beagleboard/pocketbeagle-2/README.md

# PocketBeagle 2

PocketBeagle 2 is based on [Texas Instrments AM6254 SoC](https://www.ti.com/product/AM625), it's quad A53 cores can 
provides better performance than the original PocketBeagle. The new design comes with pre-soldered headers, 
3-pin JST-SH 1.00mm uart debug port, USB-C port, MSPM0L1105, 512MB RAM, LiPo Battery charger, and optional eMMC storage.

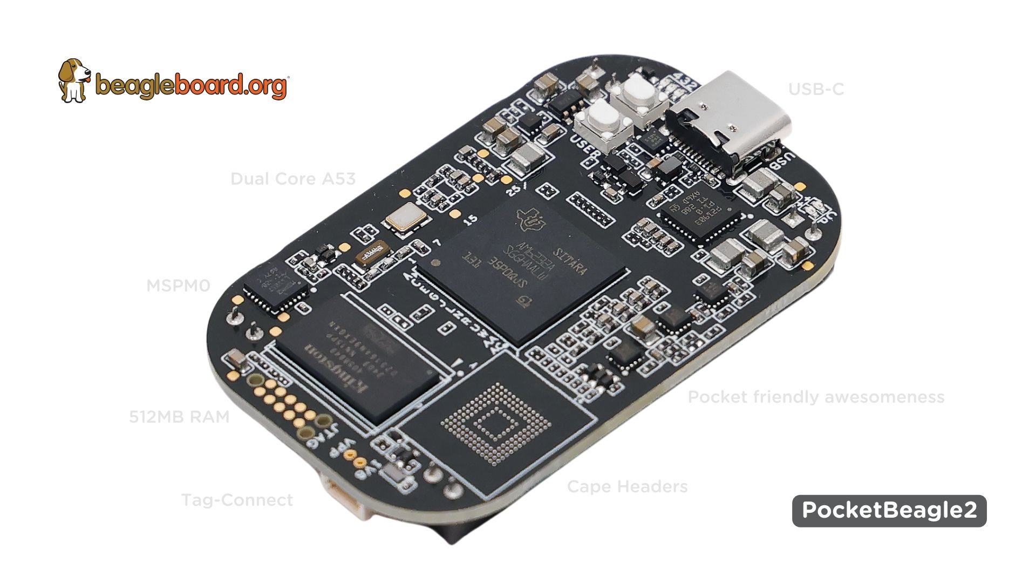
[picture p1: images/hero.jpg]


## Component location - Rev A

| Front |  Back |
| :---: | :---: |
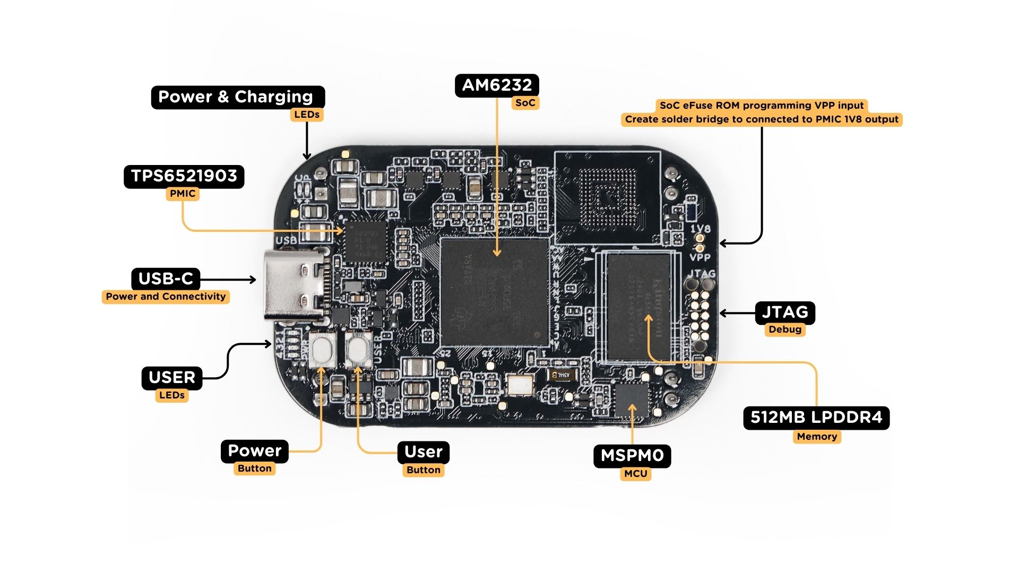
[picture p2: images/front.jpg]
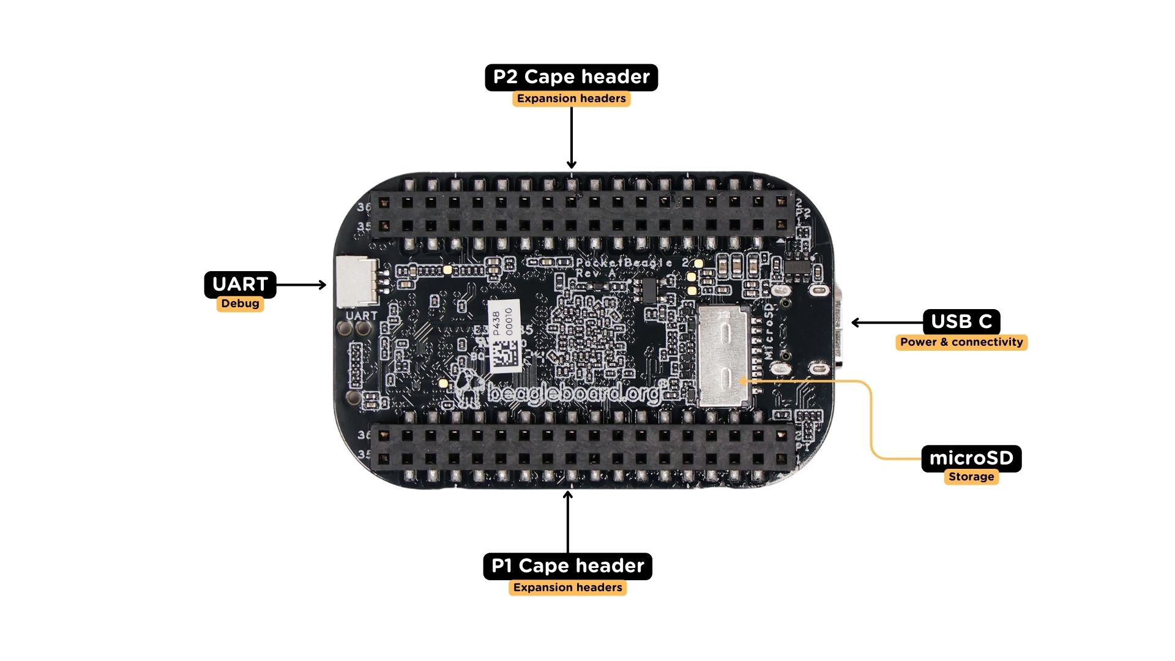
[picture p3: images/back.jpg]
|  |  | 

## Comparison table

| Feature | PocketBeagle 2 | PocketBeagle (original) |
| :---: | :---: | :---: |
| SoC | AM6254 | AM3358 |
| Arm CPU | Cortex-A53 (64-bit) | Cortex-A8 (32-bit) |
| Arm cores | 4 x 1.4 GHz | 1 x 1GHz |
| RAM | 512MB DDR4 | 512MB DDR3 |

## PocketBeagle 2 Features and Specification

| | Feature |
| :---: | :---: |
| **Processor** | [Texas Instrments AM6254 SoC](https://www.ti.com/product/AM625) |
| **SDRAM Memory** | 512MB DDR4 (Kingston D2516AN9EXGXN-TU) |
| **PMIC** | TPS6521903 |
| **Debug Support** | 3 pin 3.3V JST-SH 1.00mm UART debug port (RPI debug probe compatible) |
| | 10-pin JTAG TAG-CONNECT footprint |
| **Power Source** | USB C or Cape Header VIN (5V @ 1A) |
| **PCB** | 55 x 35 mm |
| **Indicators** | 1x Power, 1x Battery charging, and 4x User Controllable LEDs |
| **SD/MMC Connector** | microSD (1.8/3.3V) |
| **User Input** | 1. Power Button |
| | 2. User/Boot Button |
| **Weight** | 12.7gm |
