beagleboard/pocketbeagle-2/images/pocketbeagle2-45-back.jpg

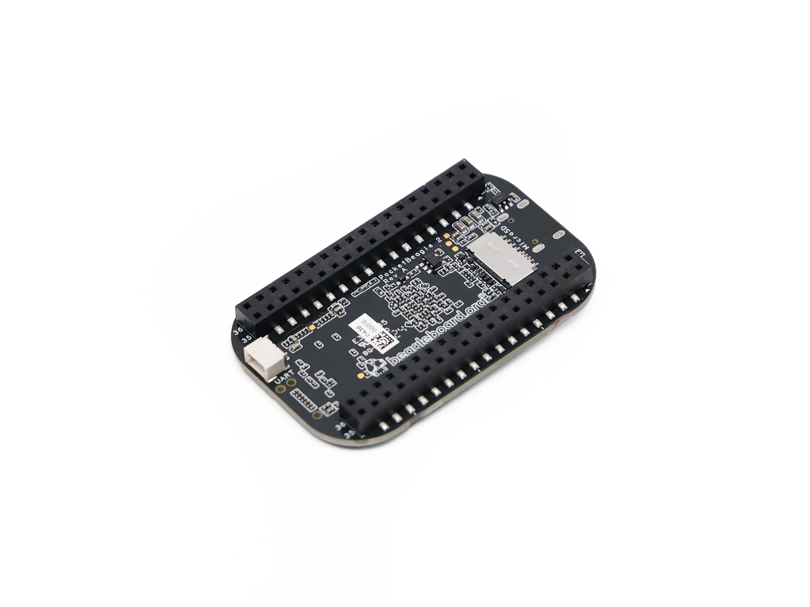
images/pocketbeagle2-45-back.jpg
