beagleboard/pocketbeagle-2/images/pocketbeagle2-45-front.jpg

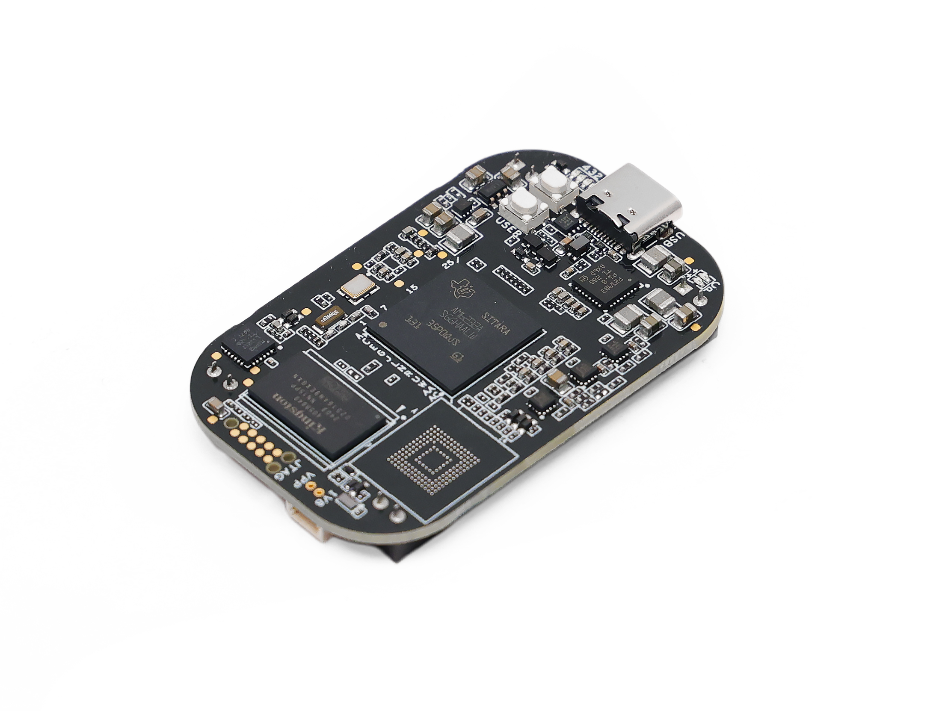
images/pocketbeagle2-45-front.jpg
