beagleboard/pocketbeagle-2/images/pocketbeagle2-back.jpg

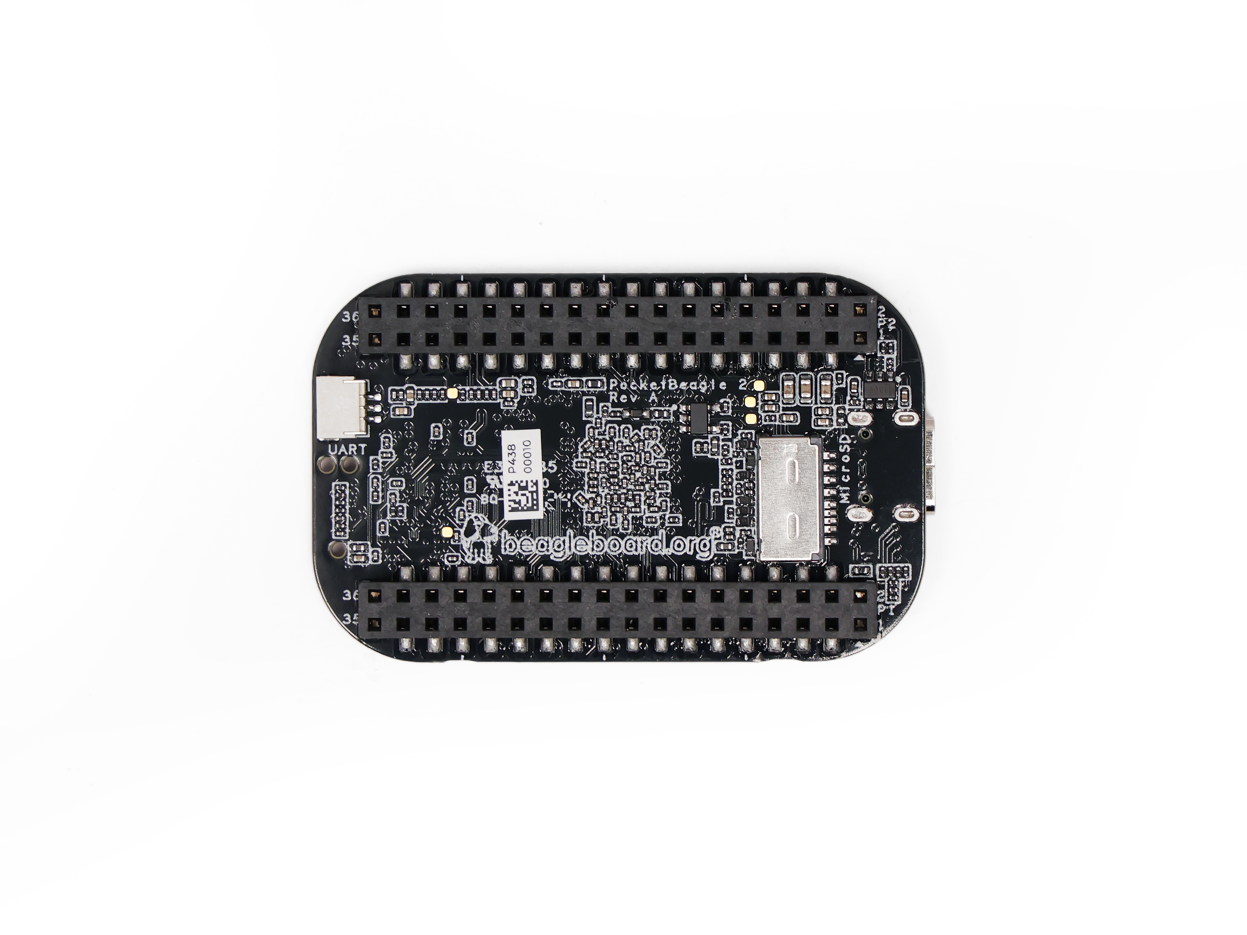
images/pocketbeagle2-back.jpg
