beagleboard/pocketbeagle-2/images/pocketbeagle2-front.jpg

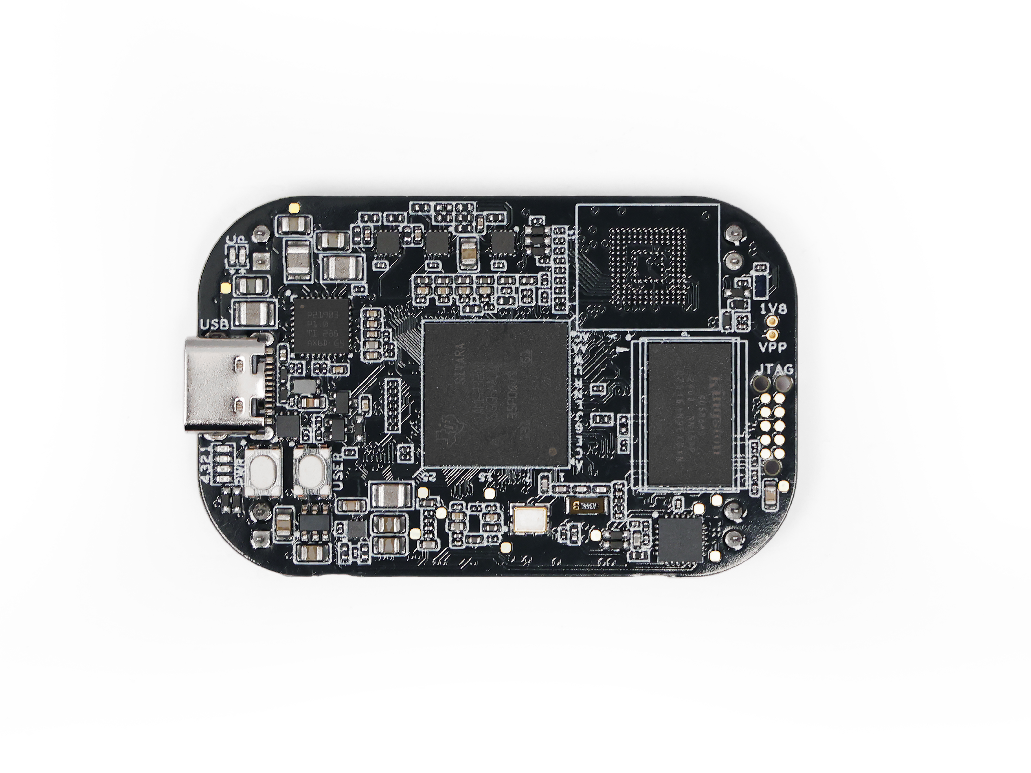
images/pocketbeagle2-front.jpg
