beagleboard/pocketbeagle-2/test-reports/evt/procedure/sd-card.md

Connecting SD Card
==================

Pre-requisites
--------------
* [micor-sd](https://www.amazon.com/SanDisk-Ultra-UHS-I-Memory-Adapter/dp/B00M55C0NS/)

Connecting the SDCard
---------------------

> :warning: Be careful NOT to break SDcard with pressure from top due to the spacing

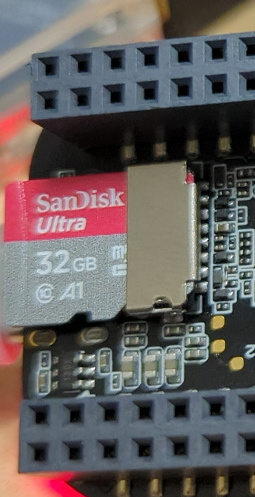
[picture p8: test-reports/evt/procedure/img/pb2_sd_card.jpg]
SDCard

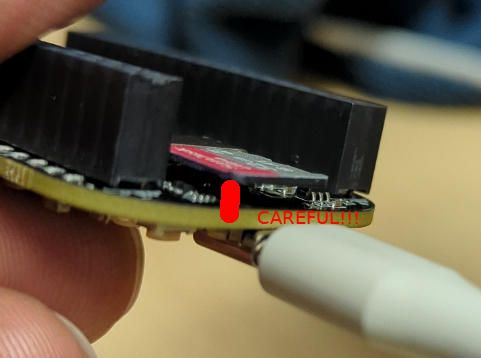
[picture p9: test-reports/evt/procedure/img/pb2_sd_card-2.jpg]
SDcard spacing SDCARD spacing

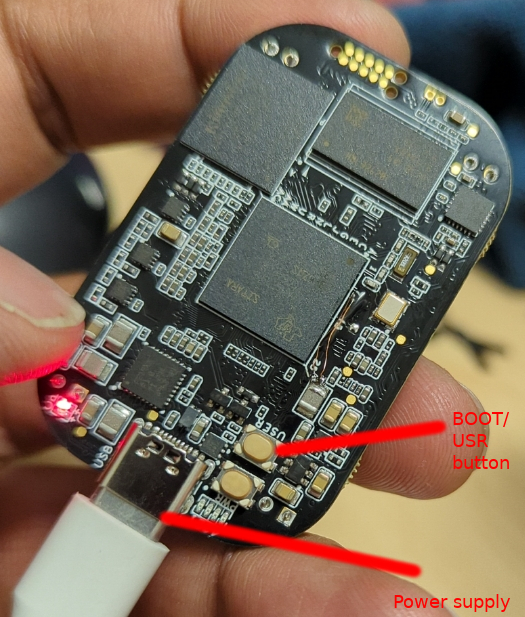
[picture p10: test-reports/evt/procedure/img/pb2_sd-push-button-power.jpg]
USR Button/Power SDCARD USRButton


Booting with SDCard
-------------------
* Flash a bootable SDCard image on uSD card
* With the user button pressed, plug-in power supply over type C
* Once the serial messages startup, let go of the USR button
