beagleboard/pocketbeagle-2/test-reports/evt/procedure/serial_console.md

Serial Console Connectivity
===========================

Pre-requisites
--------------
* [CP2102 USB2Serial adapter](https://www.amazon.com/gp/product/B078W5L8W1/)
* [Male to Female Jumper cable](https://www.amazon.com/EDGELEC-Breadboard-Optional-Assorted-Multicolored/dp/B07GD2BWPY/)

Connecting the serial cable
---------------------------

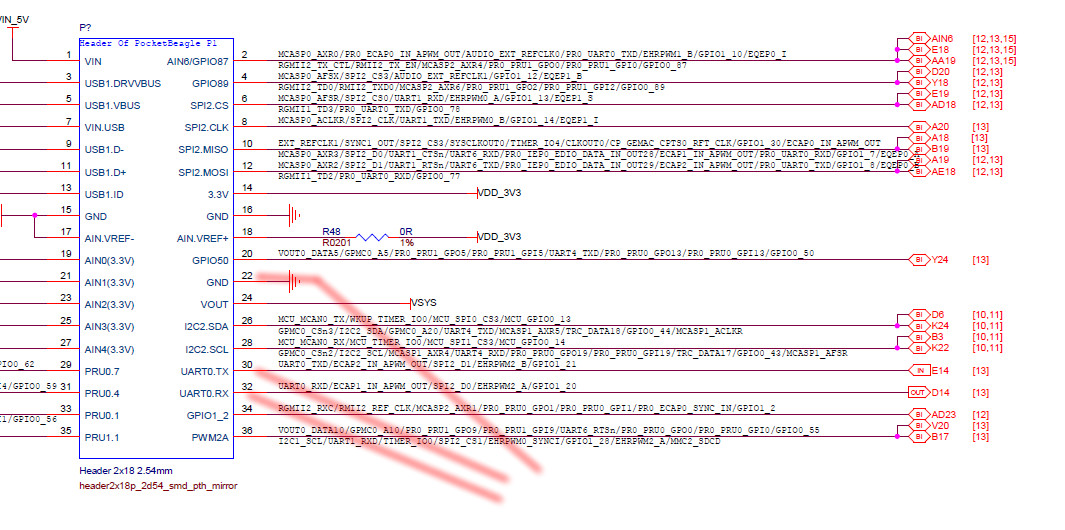
[picture p11: test-reports/evt/procedure/img/pb2_serial_console_shm.jpg]
Console pins schematics Serial Cable Schematics

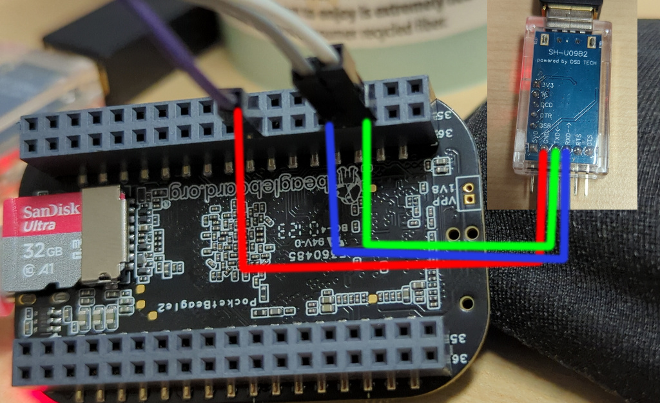
[picture p12: test-reports/evt/procedure/img/pb2_serial_console.jpg]
Connecting serial cable Connecting Serial Cable
