beagleboard/pocketbeagle-2/test-reports/evt/EVT1_PB2_rev0.5_Test_Results.xls

Sheet: Export Summary
This document was exported from Numbers. Each table was converted to an Excel worksheet. All other objects on each Numbers sheet were placed on separate worksheets. Please be aware that formula calculations may differ in Excel.
Numbers Sheet Name | Numbers Table Name | Excel Worksheet Name
Sheet1
 | Table 1 | Sheet1
Sheet2
 | Table 1 | Sheet2

Sheet: Sheet1
Sl.No | Function | Connector | Test case description | Test result (TI) | Comments (TI) | Board work | Seeed Test Result | Seeed comments | Fail track | Priority | Remarks
1 | AM62 JTAG | J19 | Attempt to connect with jtag (openocd)
2 | Uart Console | J6 | prints on console works (Linux console)
3 | Boot (Sdboot) | J1 | Boot works in FS Boot mode
4 | Board ID (eeprom) | U20 | Read and write |  | Dependent on MSP M0 Firmware
5 | LED USR0 | LED3 | enable/disable LED
6 | LED USR1 | LED4 | enable/disable LED
7 | LED USR2 | LED5 | enable/disable LED
8 | LED USR3 | LED6 | enable/disable LED
9 | Power LED | LED11 | Should glow on power ON
10 | Switch on board |  | Board must start up on applying power on Type C
11 | Button (USR) – boot mode select |  | Press USR button and boot into alternate boot – ???
12 | Button (USR) – user detect |  | Press usr button in userspace – event detect
13 | Button (PWR) – power on after power off |  | S/w power off, then press power on button to start
14 | Button (PWR) – short press power on button |  | Short press PWR button and power menu should start up (if GUI is active)
15 | Button (PWR) – Long press power off |  | On Pressing PWR button for long (8-12sec), system should power off
16 | Button (PWR) – Long press power off, PWR ON |  | after h/w power off, pressing power button should start system back up
17 | USB – Host | P1 | Operate USB as mass storage / HID devices |  | Requires External USB
18 | USB – peripheral | P1 | Power board from PC, operate as USB peripheral mode
19 | MSP M0 (RTC) |  | Detect,operate RTC |  | Dependent on MSP M0 Firmware
20 | MSP M0 (ADC) |  | Detect, get ADC readings |  | Dependent on MSP M0 Firmware
21 | Crystal operation: SoC – 25MHz | X6 | Run linux, measure time taken for sleep |  | test_25_mhz_time.md
22 | Stress operation – build for long hours |  | Do on target build for over the weekend – build linux kernel in a loop over weekend
23 | Stress operation – power on-off test |  | Power on/off board using s/w and power cycle over weekend.
 | Rest to be filled by Seeed
