beagleboard/pocketbeagle-2/test-reports/evt/procedure/README.md

Test procedure for Pocket beagle 2
==================================

* [Serial Console](serial_console.md)
* [SD Card](sd-card.md)
