beagleboard/pocketbeagle-2/design/pocketbeagle2 revA_dimension.pdf

55MM

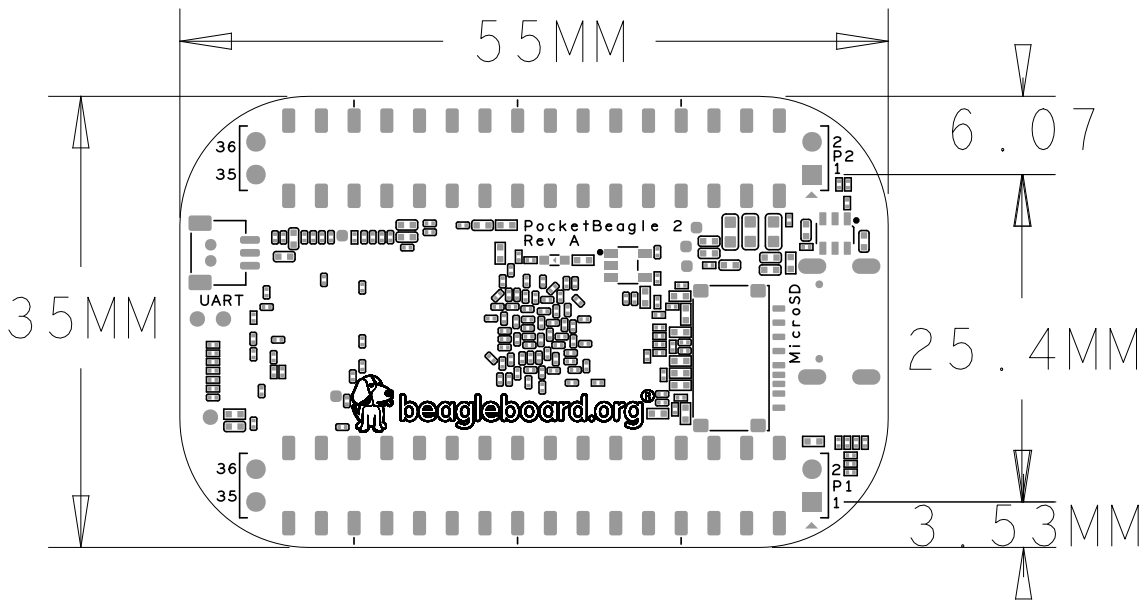
[picture p13: page 1]
UART; PocketBeagle 2 Rev A; MicroSD
