beagleboard/pocketbeagle-2/pocketbeagle2_sch.pdf

D | D
C | C
B | B
A | A
VER # | DATE | DESCRIPTION OF CHANGES | AUTHOR
0.1 | | First release | qxn
| | | qxn

## 28 Oct. 2022

## PAGE

001 | Revision History PAGE NAME
PAGE LIST | REVISION HISTORY
002 | 002_Block Diagram
003 | 003_Power Tree
004 | 004_I2C Usage Diagram
005 | 005_PMIC & Charger
006 | 006_SoC Power
007 | 007_SoC DCAPs
008 | 008_SoC DDR & DDR4
009 | 009_SoC MMC & eMMC & SD

010

011

012

014

013

016

015

## qxn

## qxn 010_SoC WKUP/MCU/System

## 011_SoC Bootstrap

## 012_SoC RGMII/OSPI

## 013_SoC GPIO/MCASP/VOUT

## 014_SoC USB/OLDI/CSI & USB C

## 015_SoC JTAG & MISC

## 016_BP P1 & P2

0.2 | 1. Remove unused nets

## 2. Use WKUP_I2C0 for PMIC 3. Add pull-down to VPP 4. Move eEMMC_RSTn to GPIO0_7 5. Add USER button for boot mode seletion 6. Try to add a CSI connector 7. Using processor boall numbers for signal name on P1 and P2 8. Change SoC to AM6232, change eMMC to 4GB, change DDR to 512MB

## 1 Nov. 2022

0.3 | 1. Remove CSI

## 2. Add SD card, move LDO0 to VDD_SD 3. Power the VPP with VDD_1V8 through a jumper 4. Connect P2.19 to AC20 instead

## 2 Nov. 2022

0.4 | 1. Replace the ideal diode with LM73100RPWR

## 2. Replace EEPROM and ADC with MSPM0 3. Correct the boot settings

4. Connect AD24(MDC) to P2.17 and AB22(MDIO) to P2.20 which is same as pocketbealge.

## 23 Dec.2022

0.5 | qxn
1. Add B5 (MCU_UART0_RXD) to P2_5.
2. Add A5 (MCU_UART0_TXD) to P2_7.
3. Add A18 (EXT_REFCLK1) to P1_10.
4. Add AD24 (MDIO0_MDC) to P2_1. 5. Add AB22 (MDIO0_MDIO) to P2_3.

## 28 Dec.2022

1. Add a buffer on reset 2. Correct typo - WKUP_I2C0_SDL 3. Add decoupling capacitors for LM73100 4. Change R44 to 100k 0.1% 5. Add pulldown resistors on RESETSTATz and PORZ_OUT 6. Correct the ideal diode control logic 7. Change C17 to 10uF 8. Change the SD card holder to lower profile with insertion detection 9. Move C11 to be in parallel with R260 10. Add pullup resistors to WKUP_I2C0 11. Add voltage divider on USB1_VBUS
0.6 | 09 Oct.2023 | qxn
1. Add 3-pin JST connector for UART debug 0.7 | 05 Mar.2024 | 2. Add buffer to debug UART | qxn
0.8 | qxn
1. Fix typo of ‘debug' in schematic 21 Nov.2024 | 2. Correct ideal diode control logic.
1. Modify the boot order of non-emmc version, add a pull-down resistor on non-emmc version to force 0.9 | 3 Dec.2024 | SD boot as primary boot | qxn
1.0 | 20 Dec.2024 | 1. Change USB_5V to charger input to prevent battery voltage flowing back to the charger input through the ideal diode, causing charger indicator light problems

## 2. Change the main MPU to AM6232ASGGHAALW which has PRU 3. Change ADC MCU to MSPM0L1105

## qxn

Title:

Size: | Document Number: | Rev:
Draw By: | Date: | Sheet: | of

# https://www.seeedstudio.com

A3 | v1.0
qxn | Friday, December 20, 2024 | 1 | 16

## PocketBeagle2

001_Revision History

SD Only

# https://www.seeedstudio.com

qxn | Friday, December 20, 2024 | 1 | 16
| 001_Revision History

SD Only

# https://www.seeedstudio.com

qxn | Friday, December 20, 2024 | 1 | 16
| 001_Revision History

SD Only

# Block Diagram

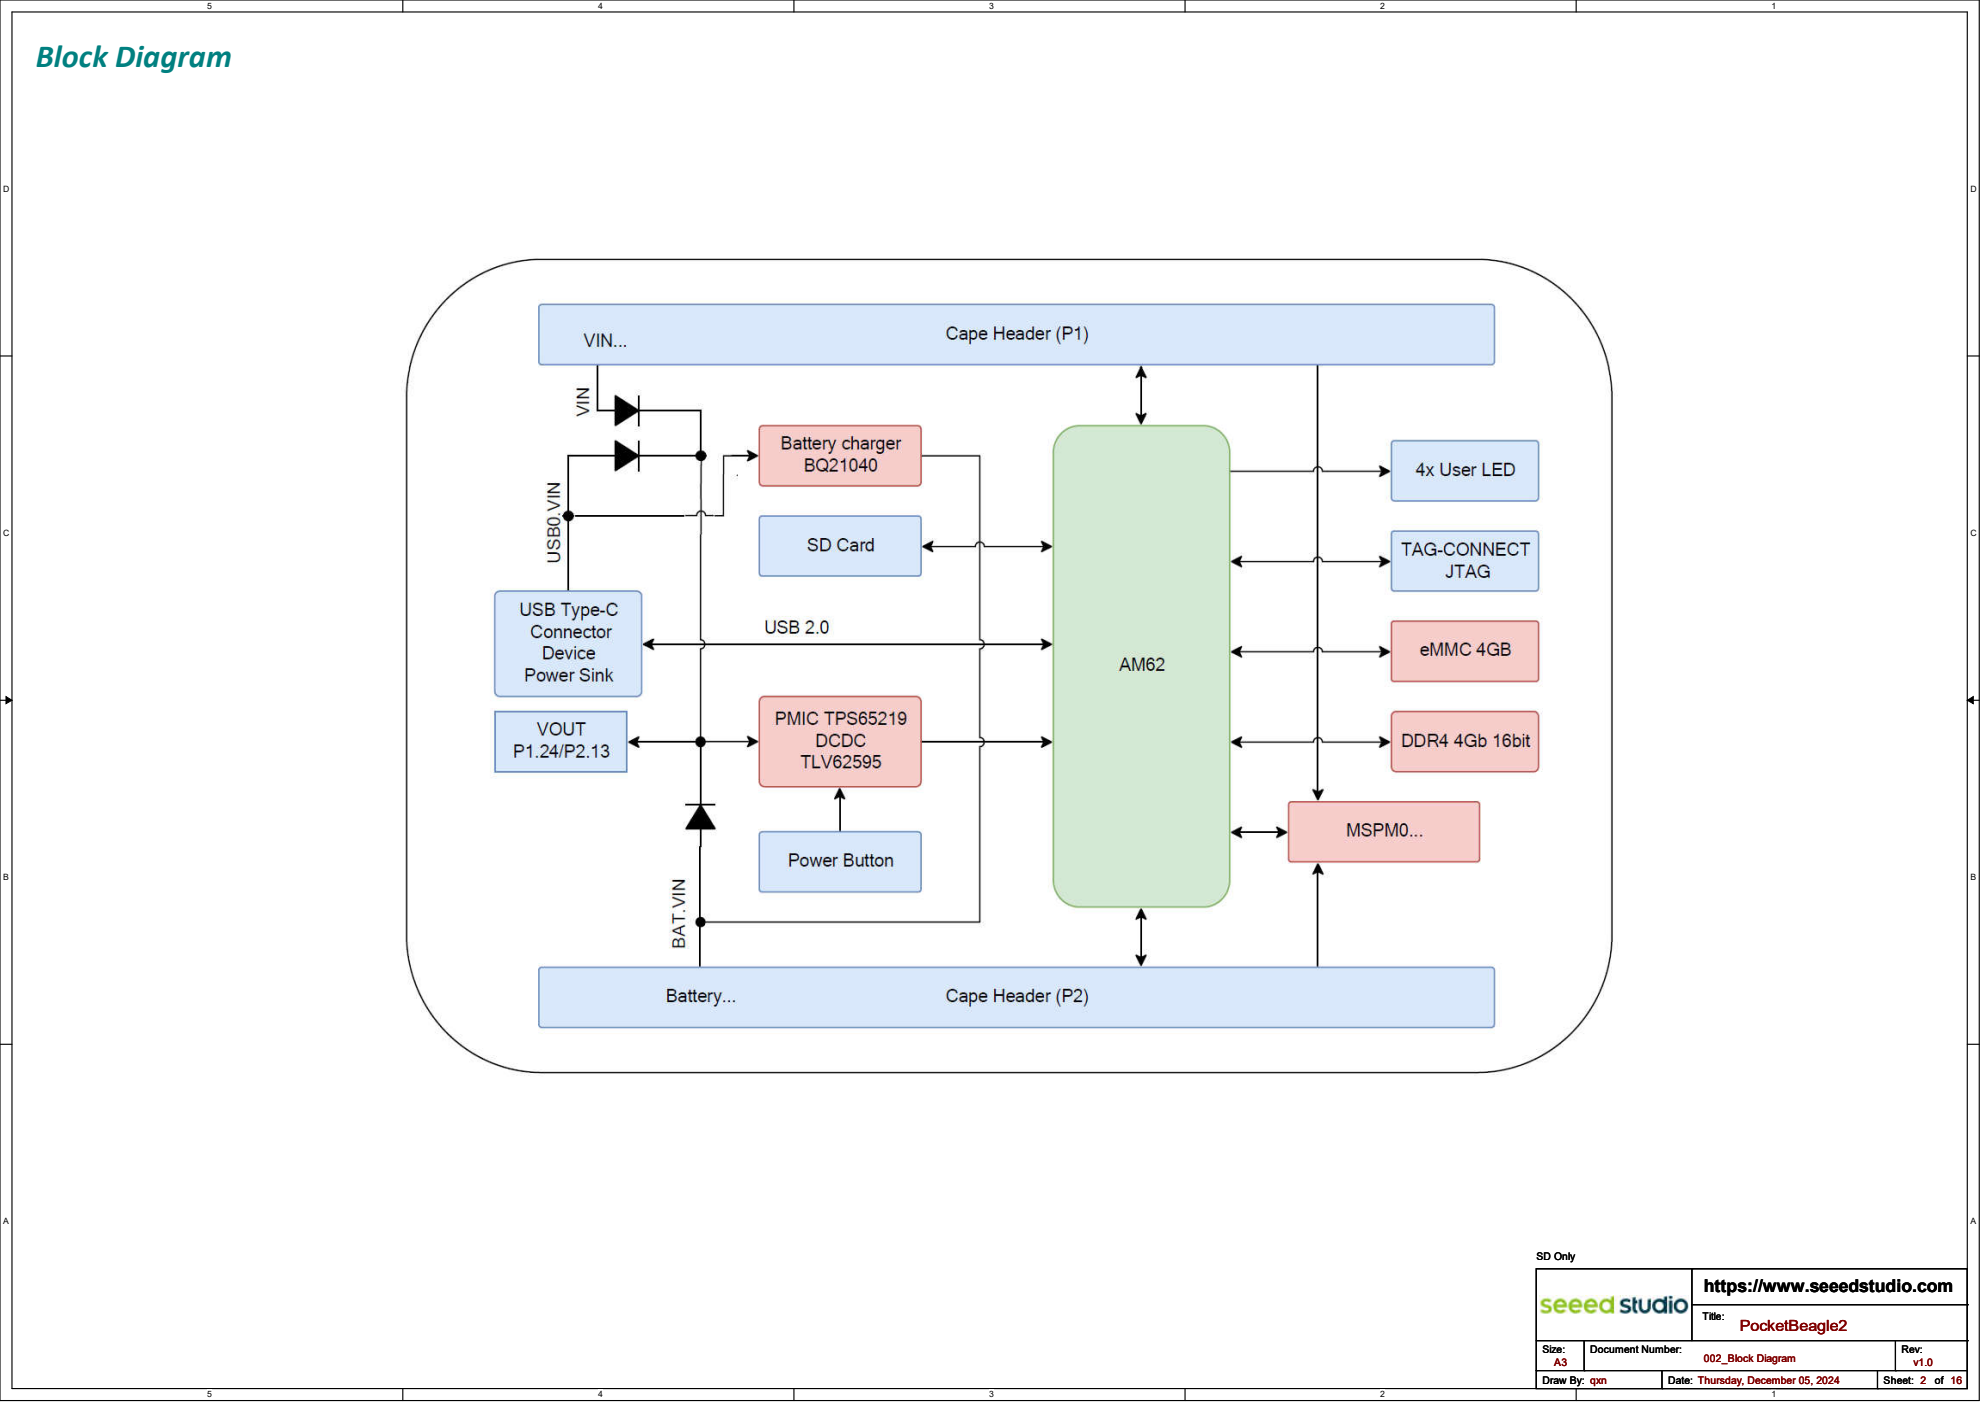
[picture p14: page 2]
qxn; Thursday, December 05, 2024; 002_Block Diagram; SD Only

https://www.seeedstudio.com

# Power tree

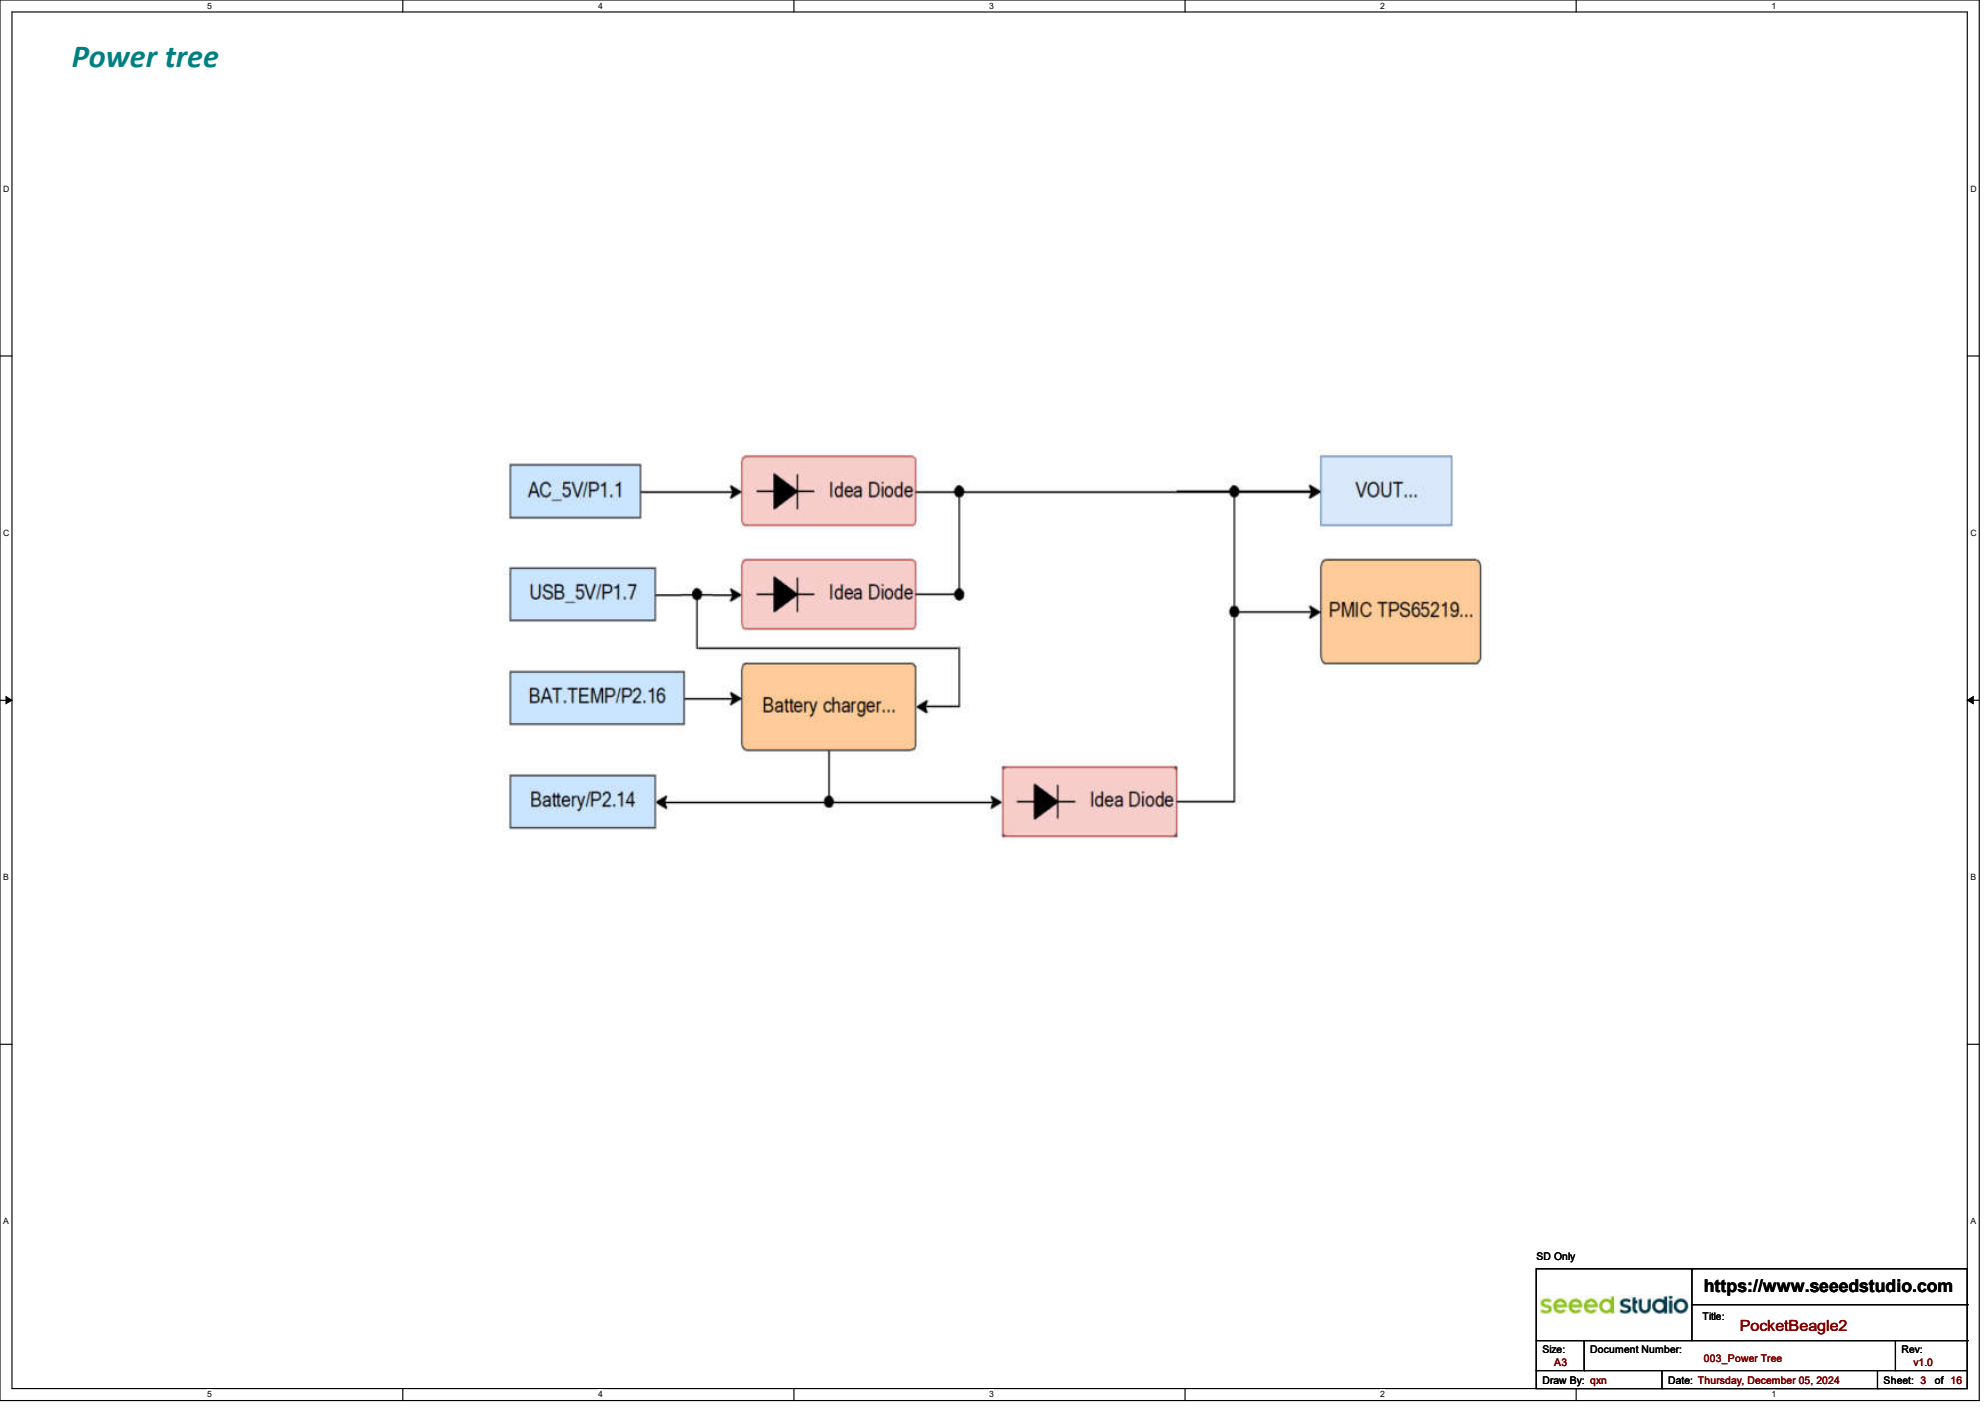
[picture p15: page 3]
qxn; Thursday, December 05, 2024; 003_Power Tree; SD Only

https://www.seeedstudio.com

# I2C Usage Diagram

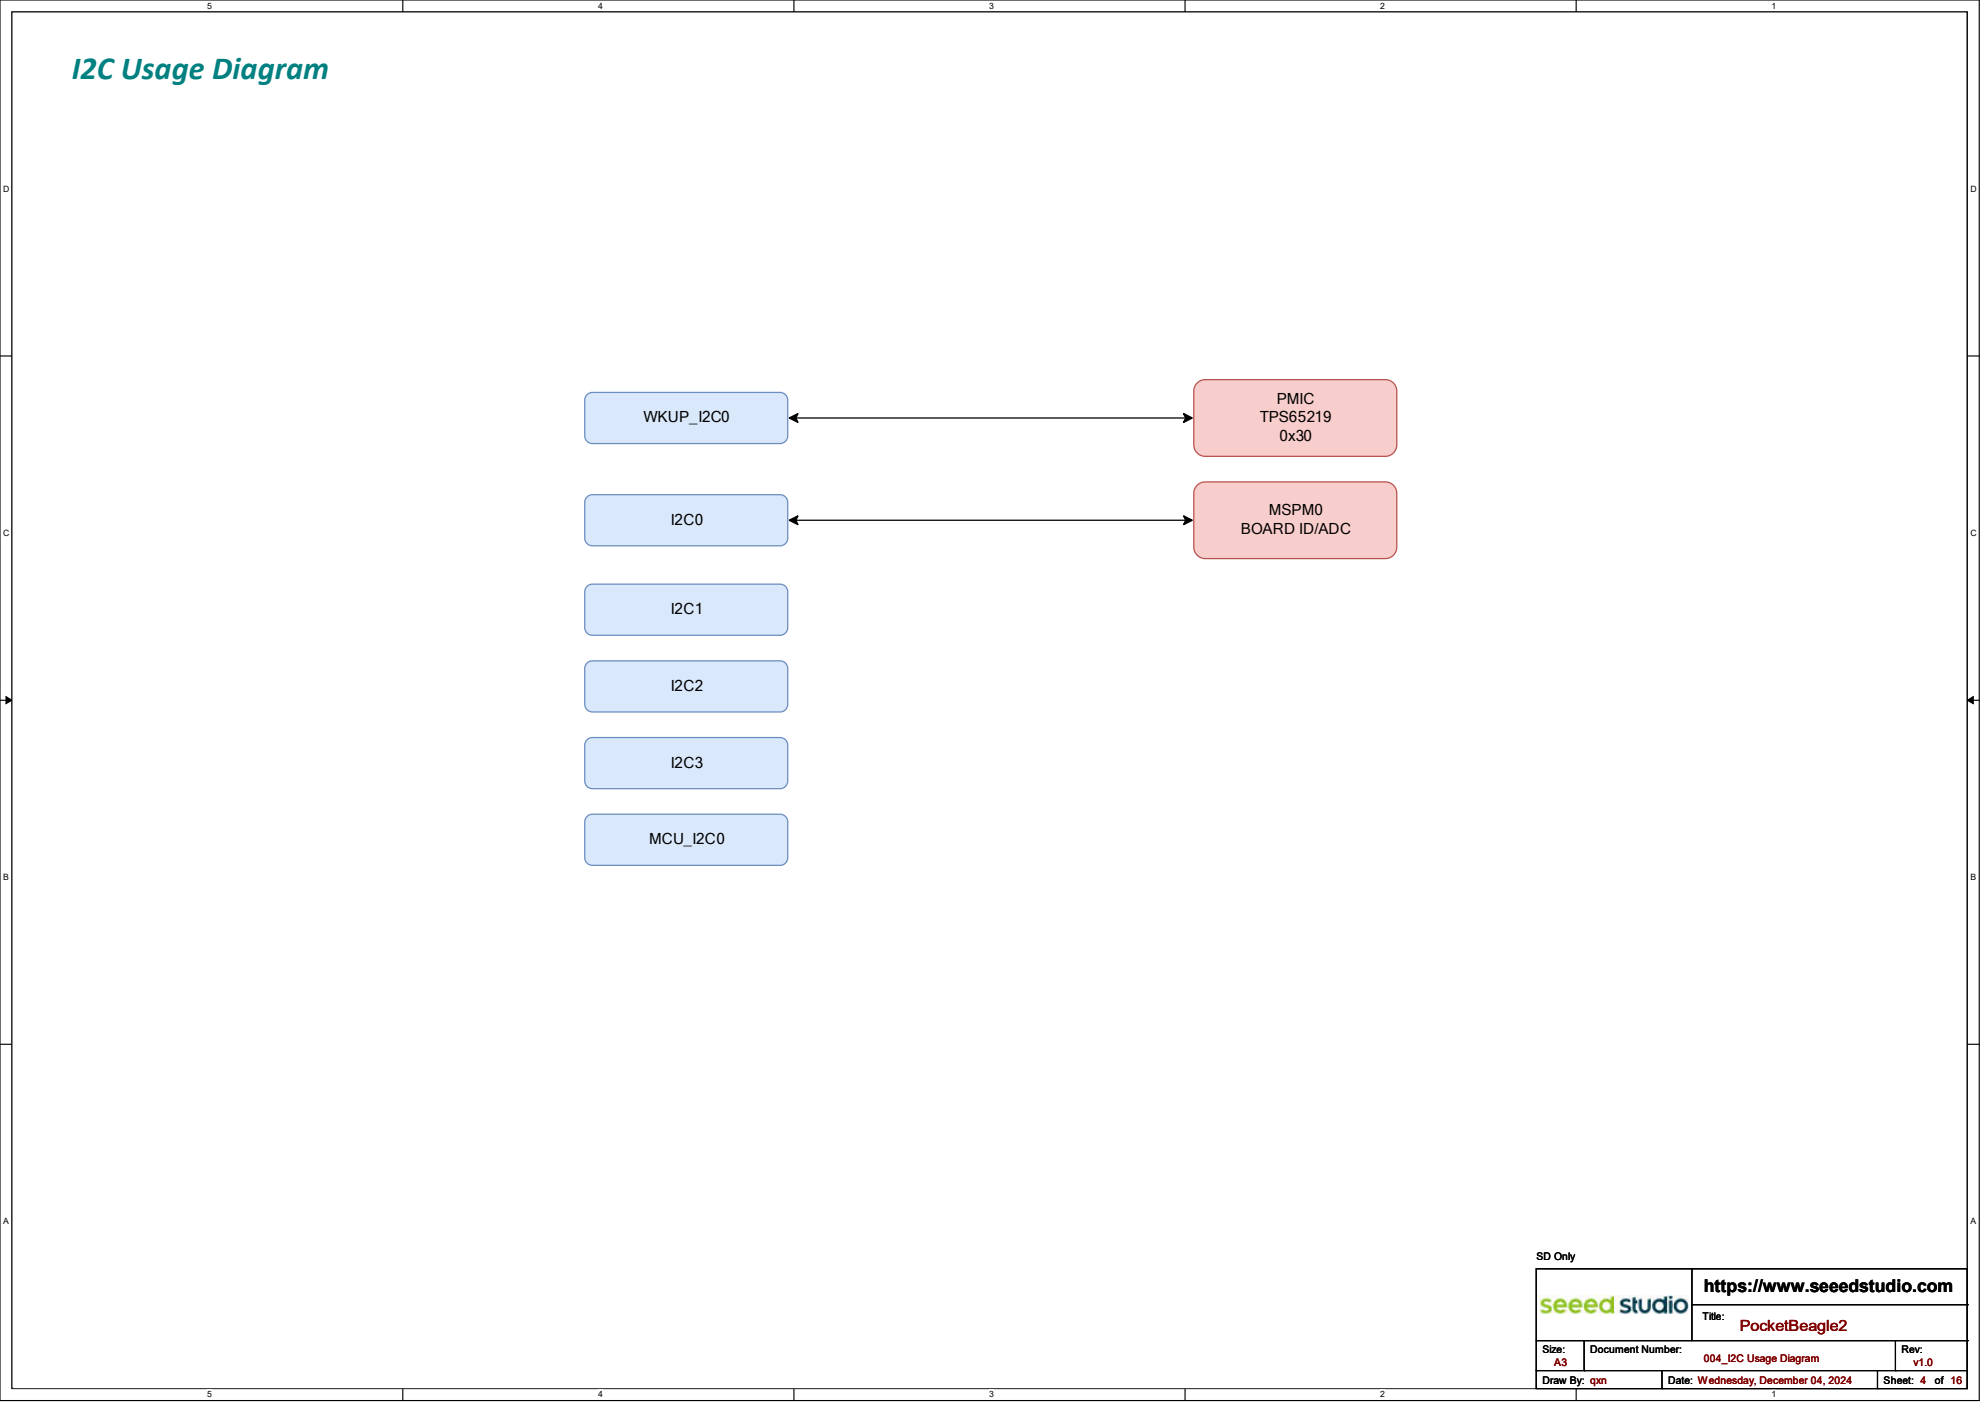
[picture p16: page 4]
PMIC TPS65219 0x30; MSPM0; MCU_I2C0; WKUP_I2C0; qxn; Wednesday, December 04, 2024; 004_I2C Usage Diagram; SD Only

BOARD ID/ADC

https://www.seeedstudio.com

Power Path | Battery Charger

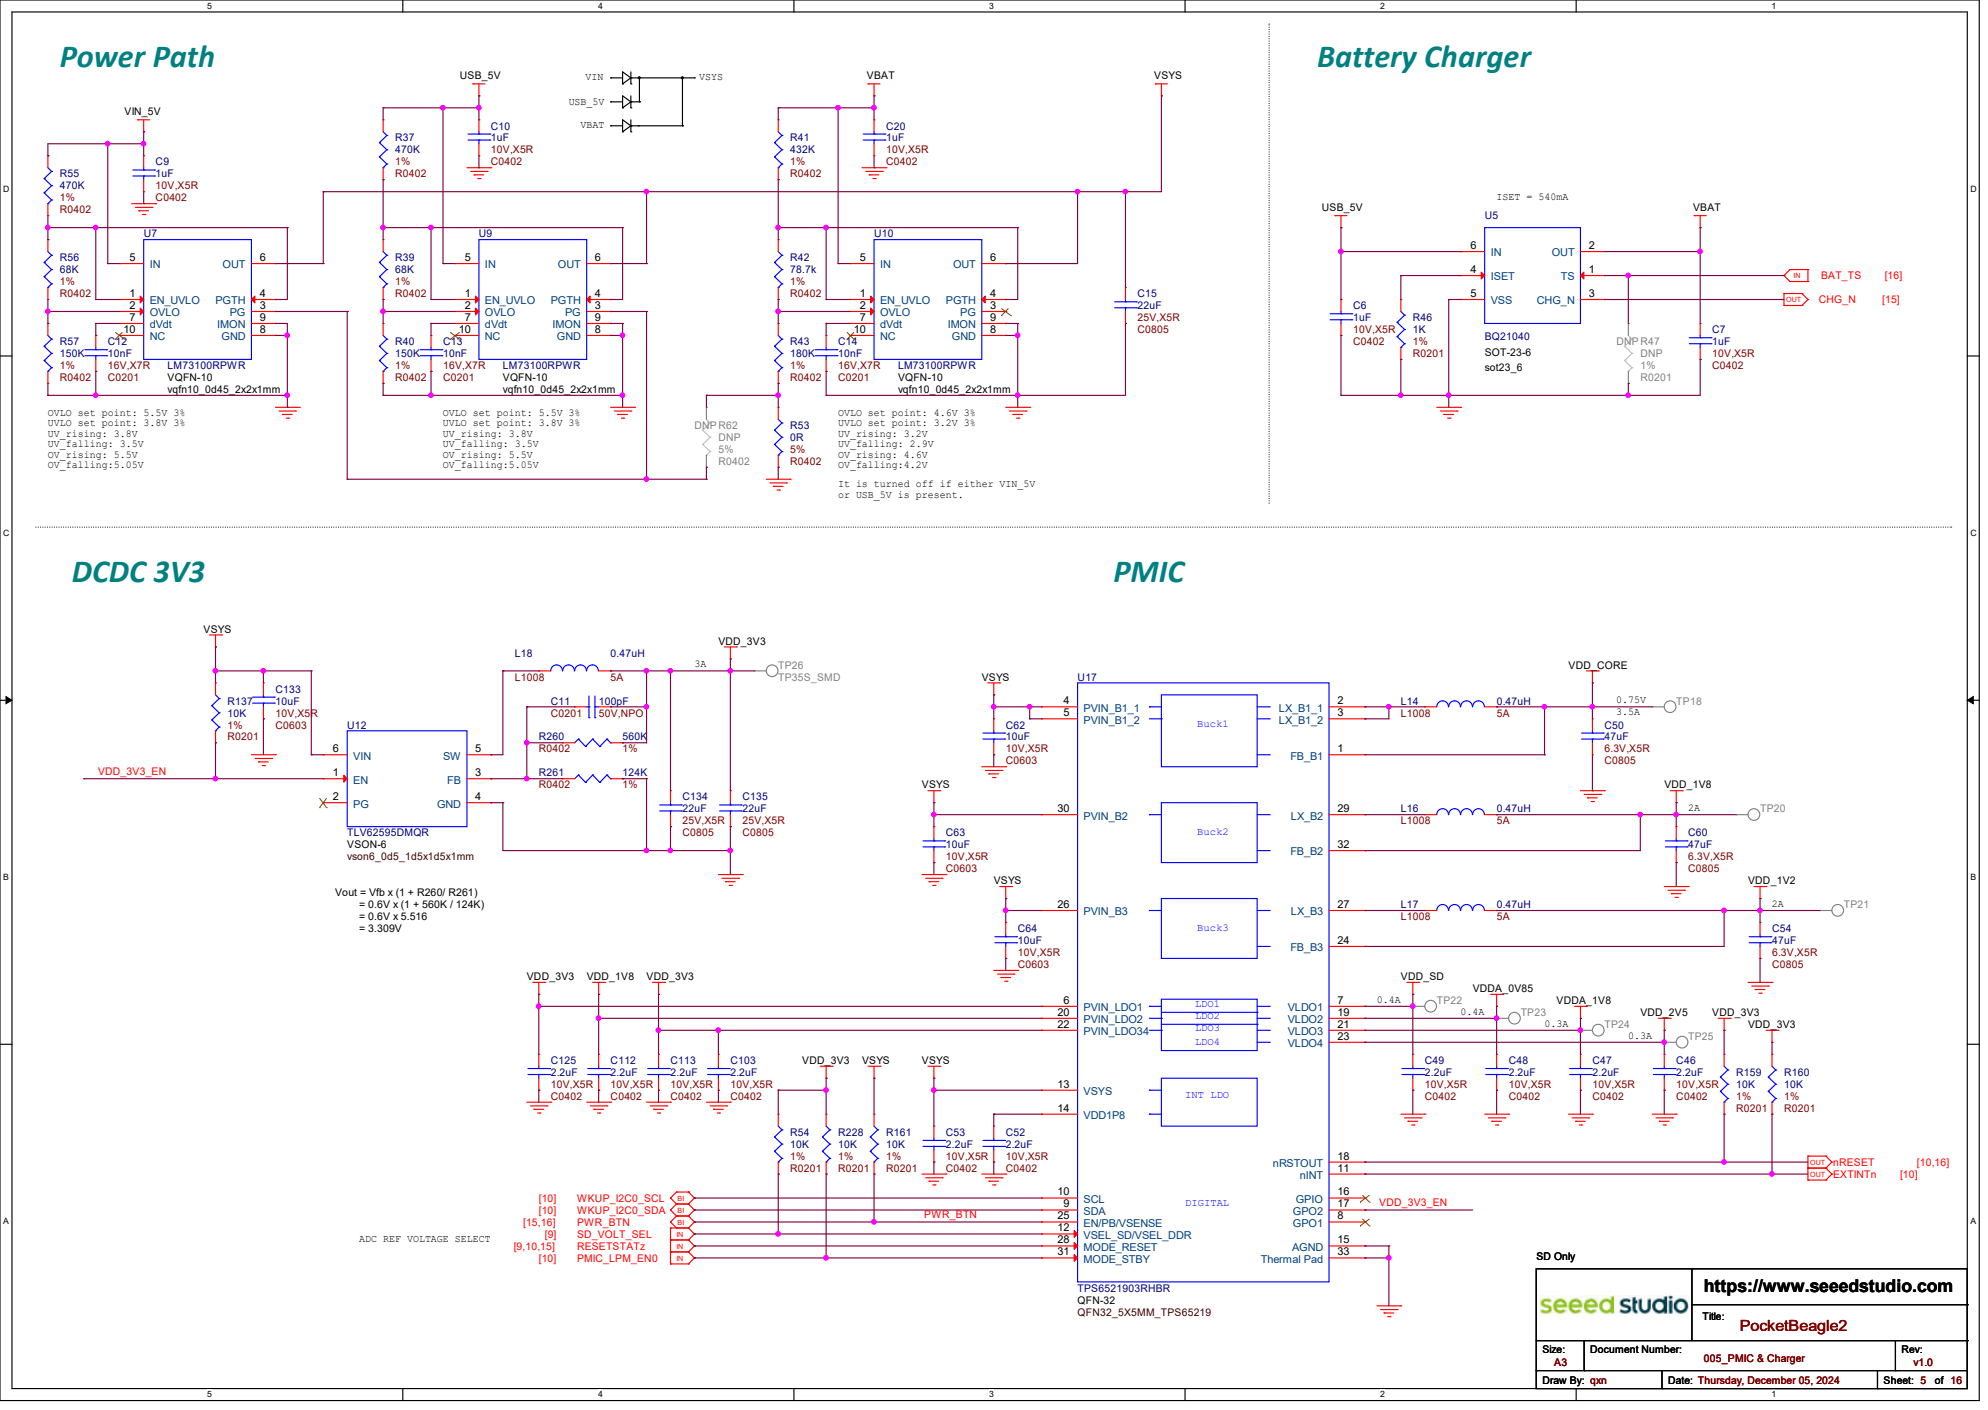
[picture p17: page 5]

It is turned off if either VIN_5V
or USB_5V is present.

ADC REF VOLTAGE SELECT

https://www.seeedstudio.com

# SoC Power

## ANALOG AND DIGITAL

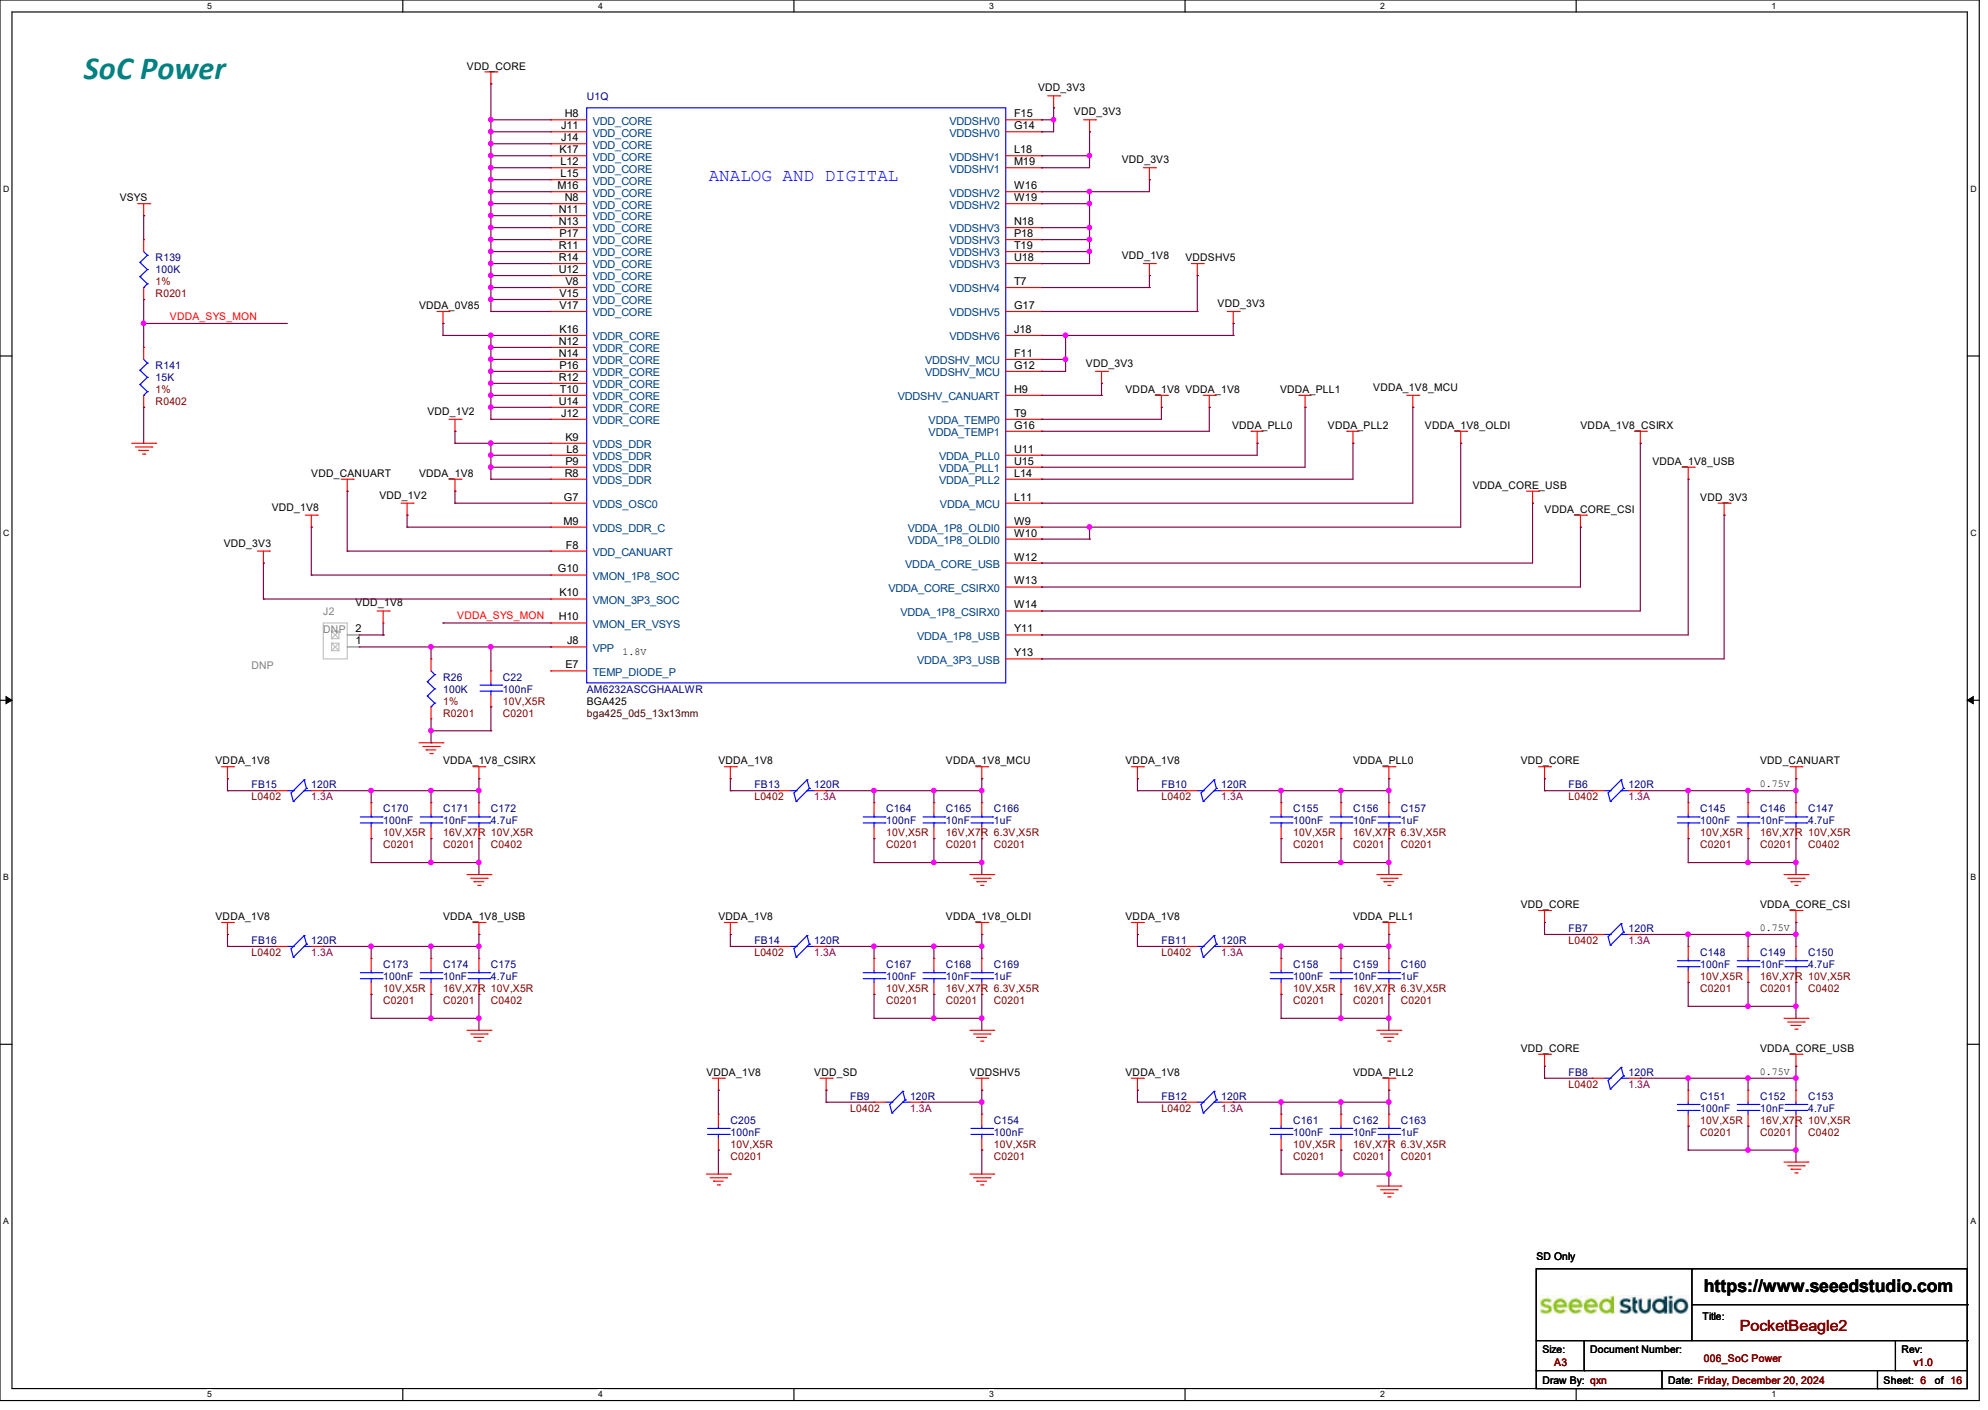
[picture p18: page 6]

https://www.seeedstudio.com

# SoC DCAPs

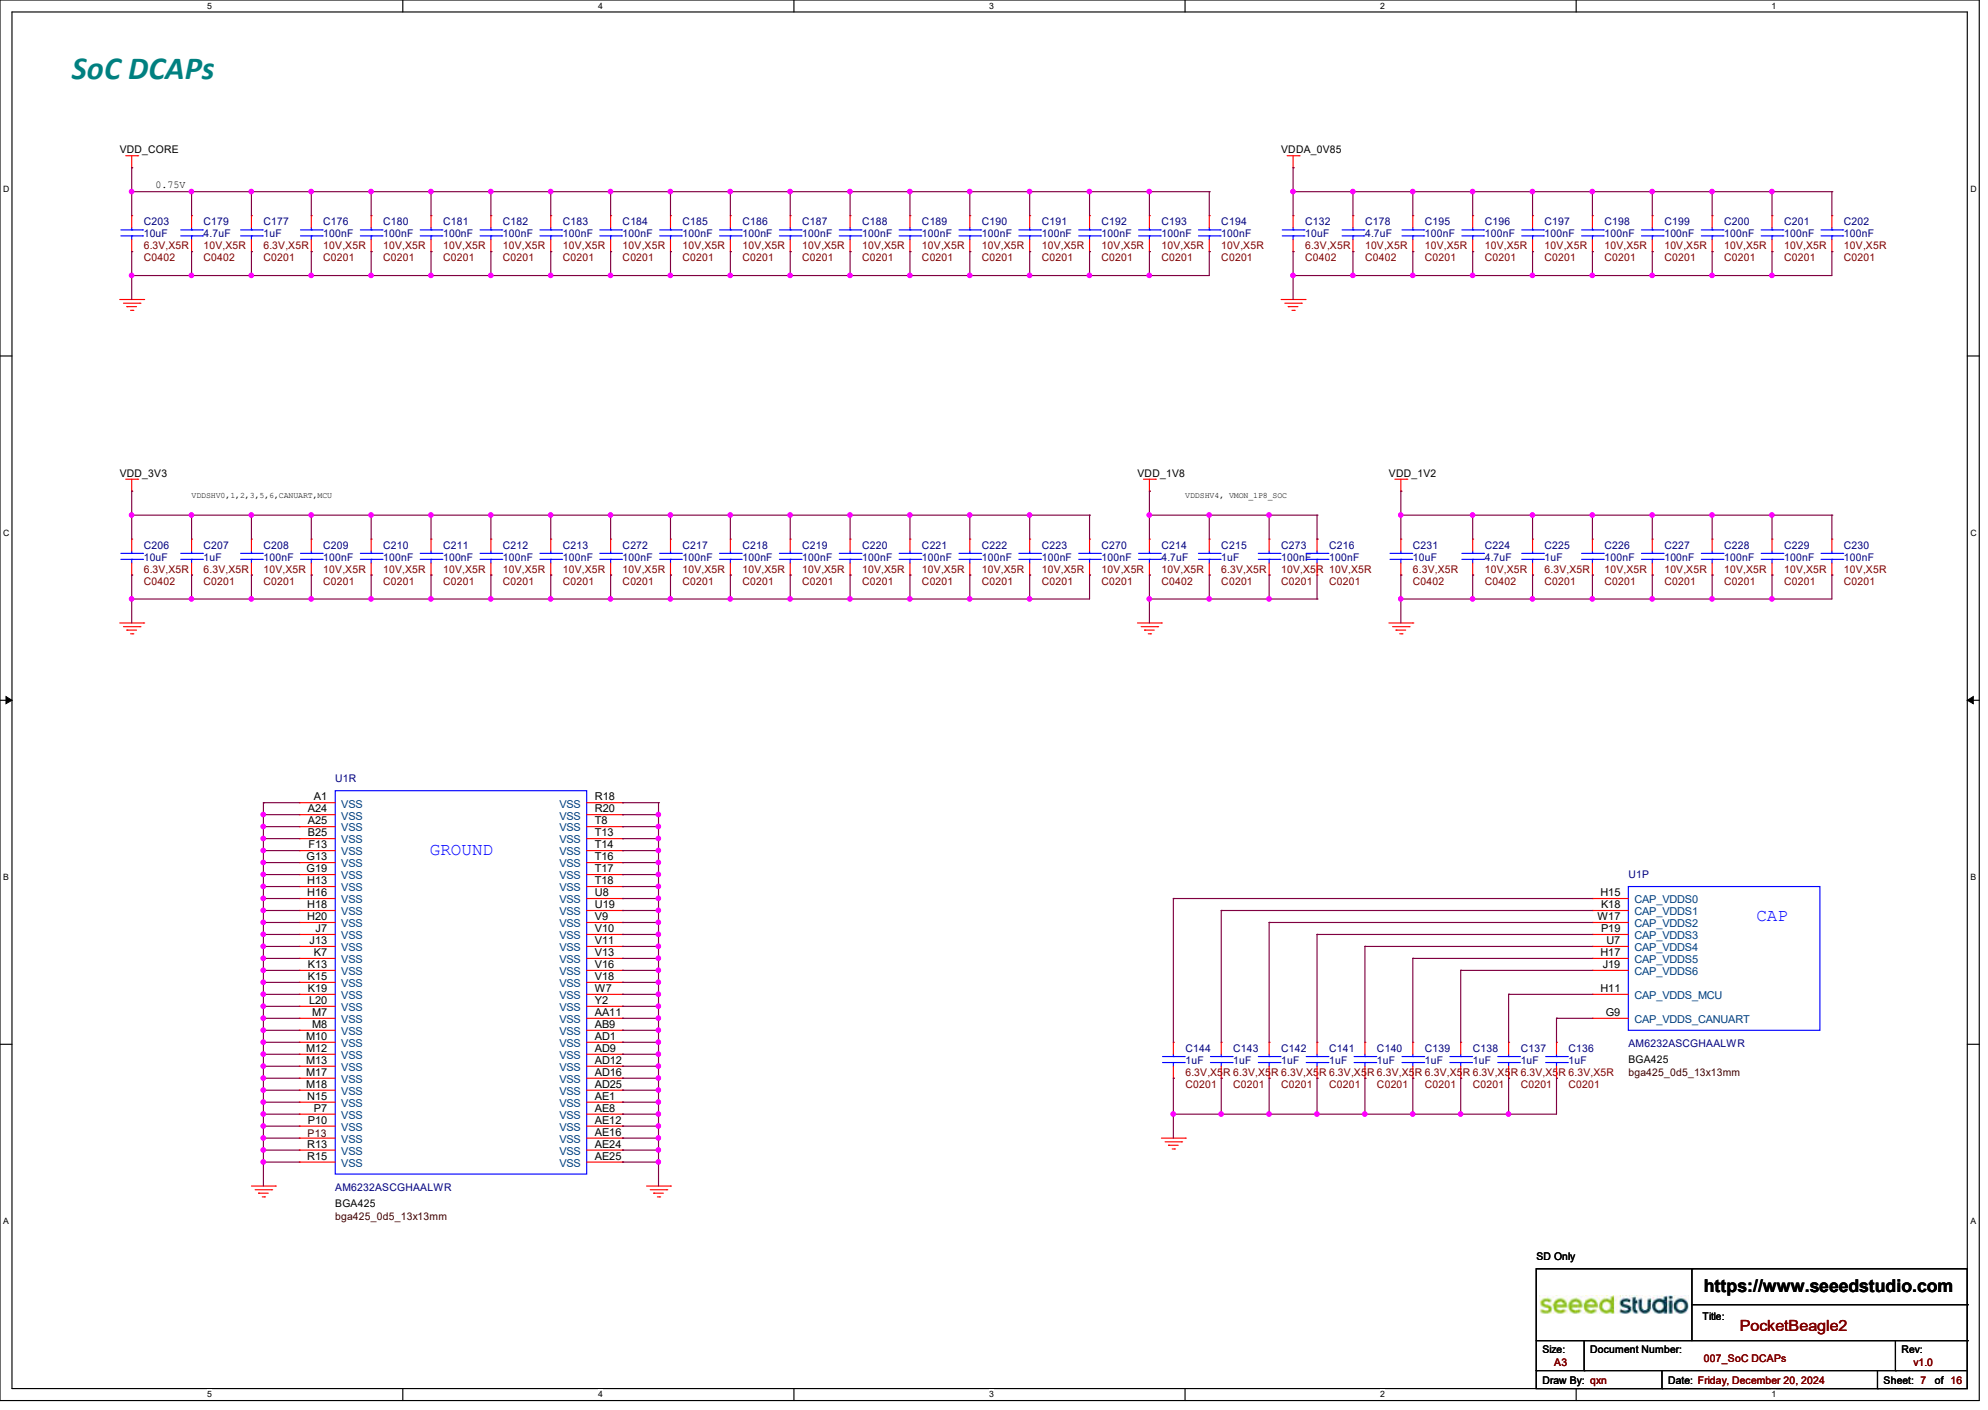
[picture p19: page 7]

https://www.seeedstudio.com

# DDR4

bga96_t9_p8_10_3x13_3 VDD B³ | VDD B⁹ | VDD D¹

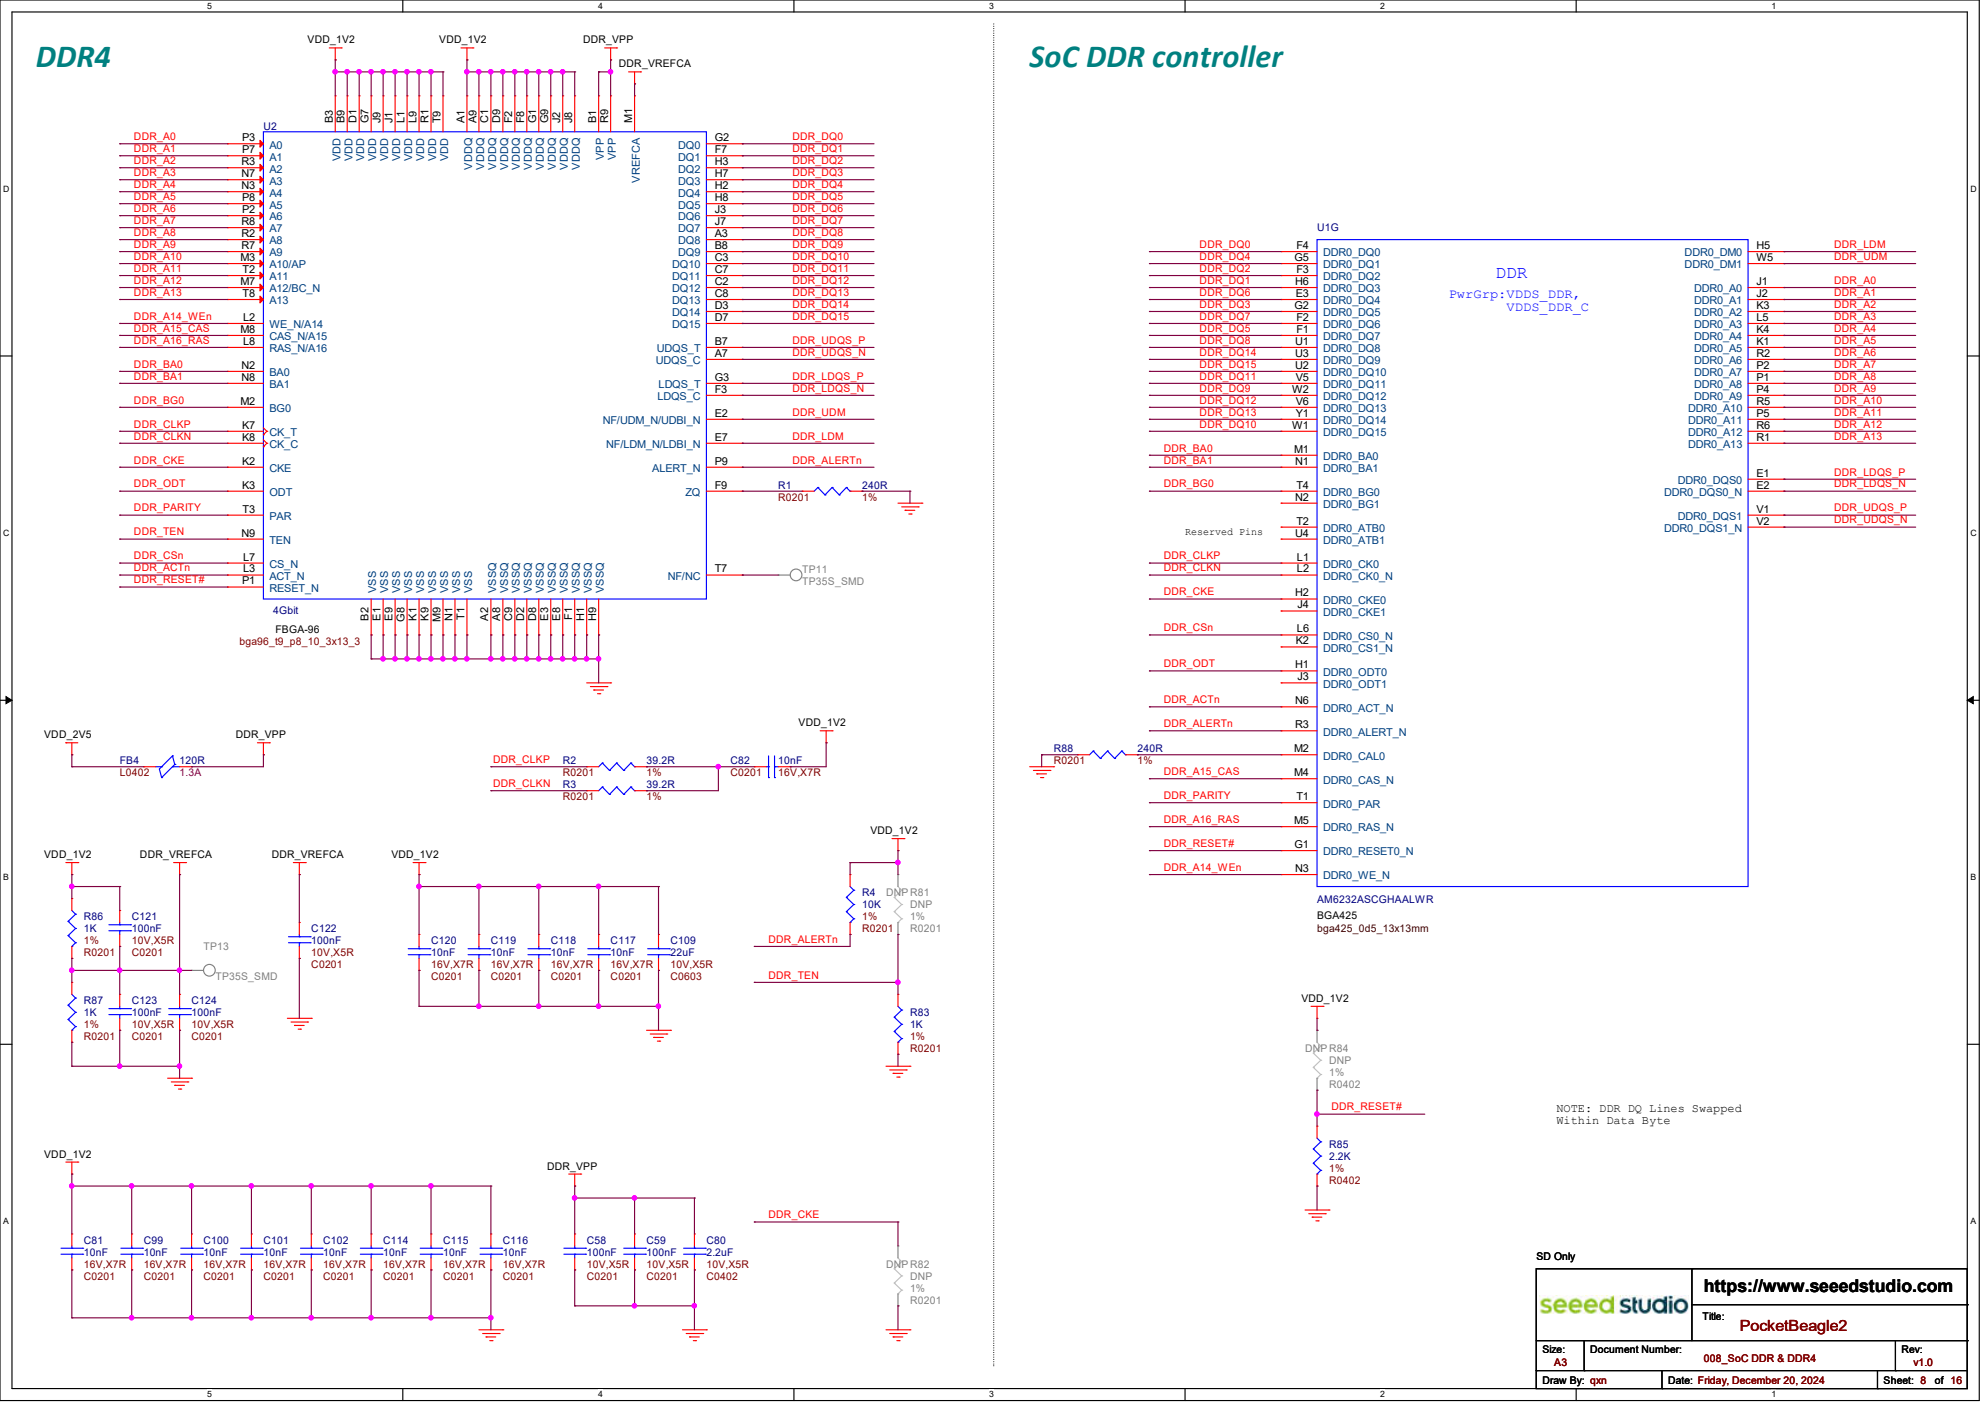
[picture p20: page 8]

NOTE: DDR DQ Lines Swapped
Within Data Byte

https://www.seeedstudio.com

# eMMC

# SoC MMC & eMMC

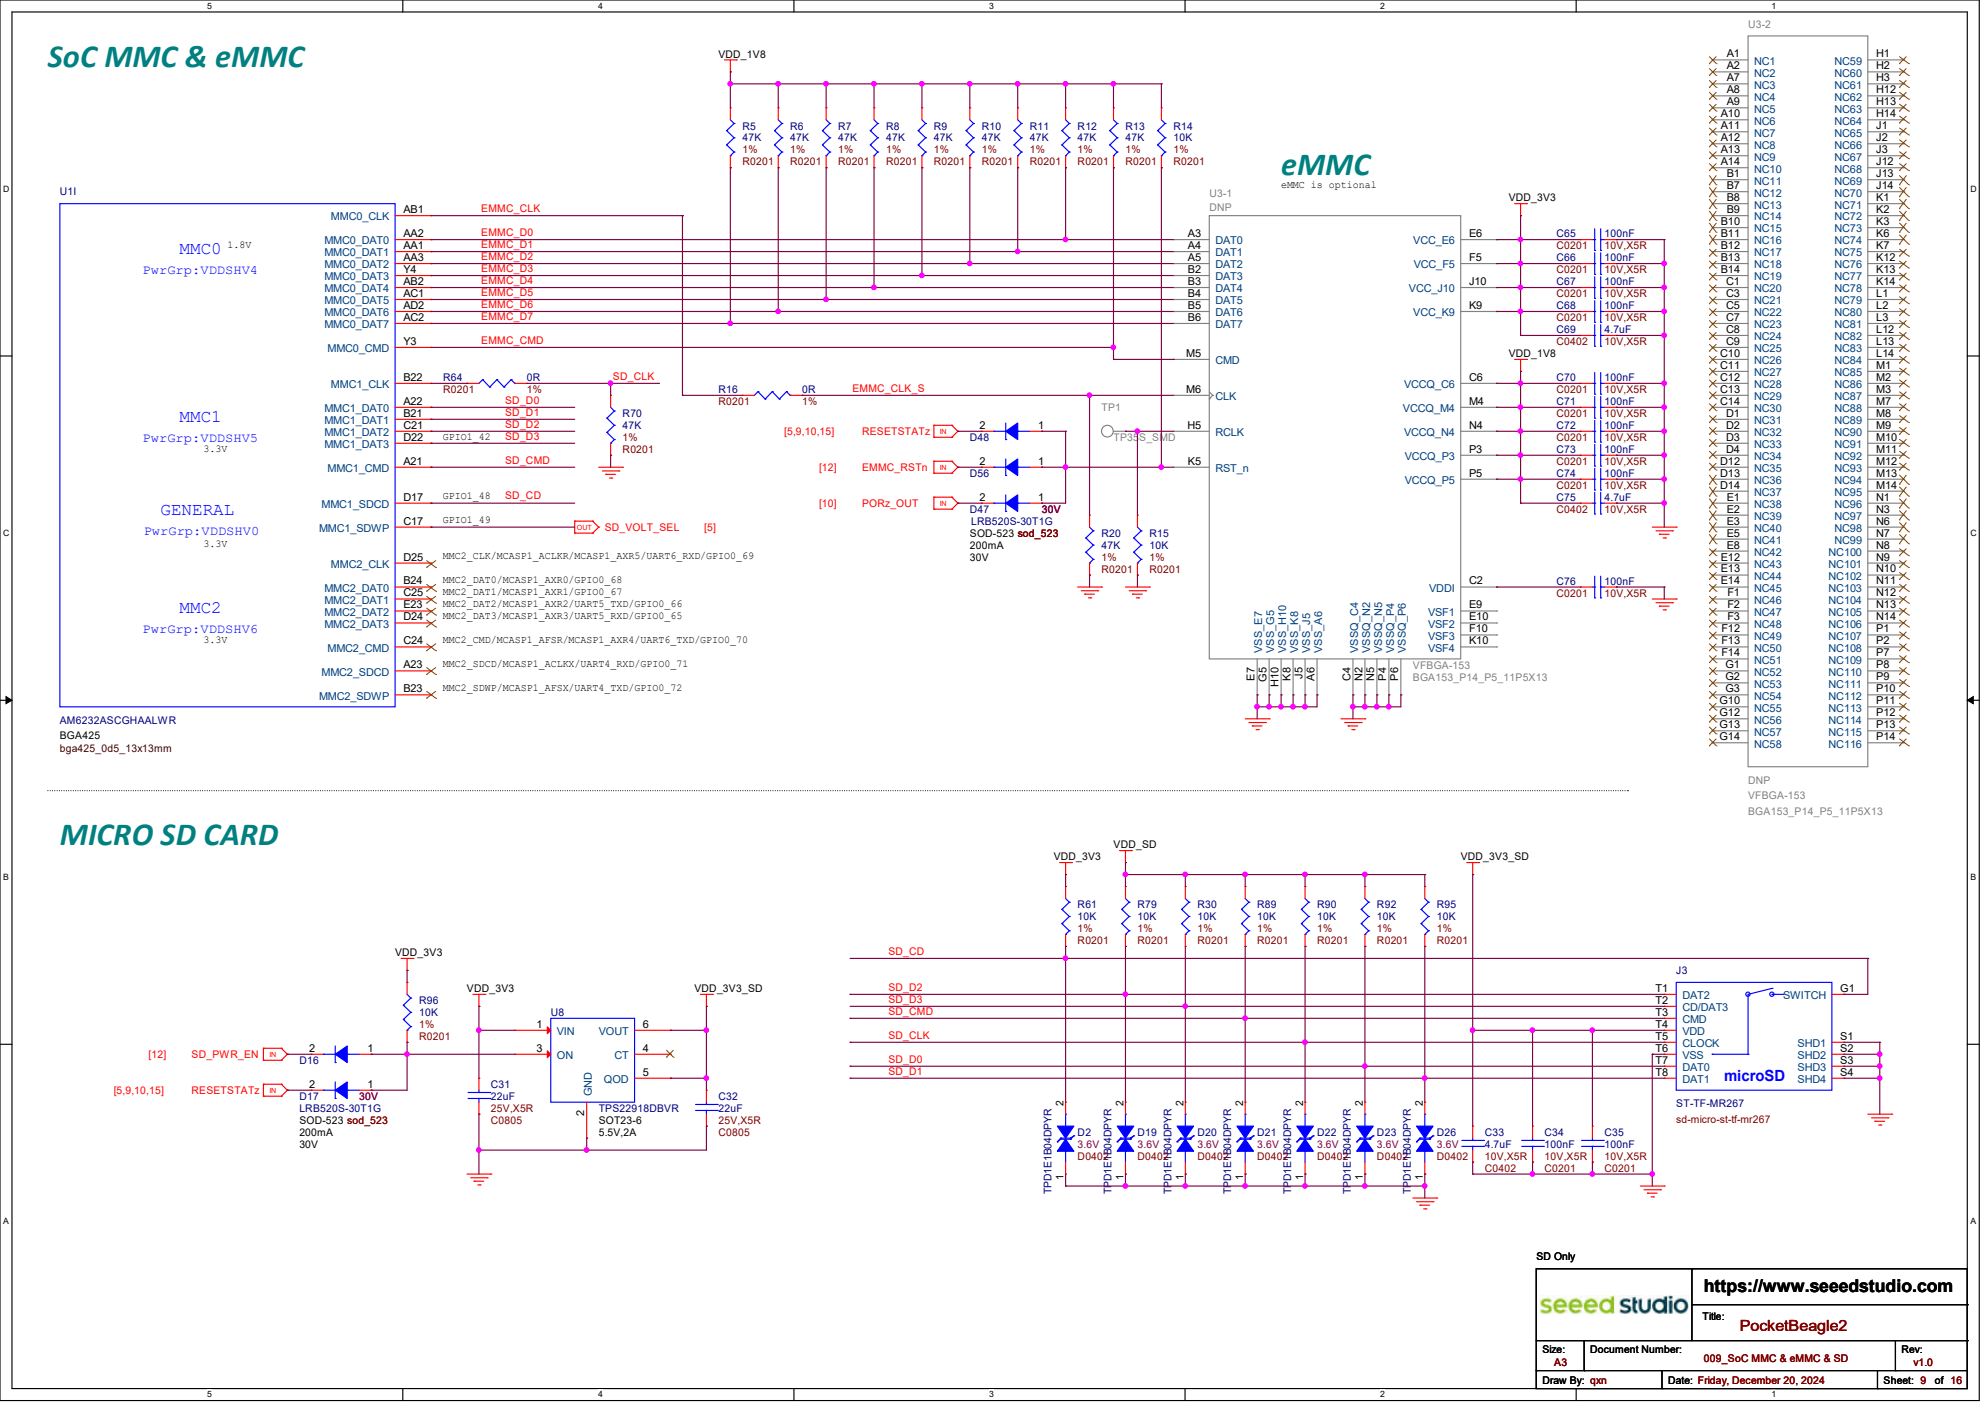
[picture p21: page 9]

sd-micro-st-tf-mr267

https://www.seeedstudio.com

# SoC System

## OSC0

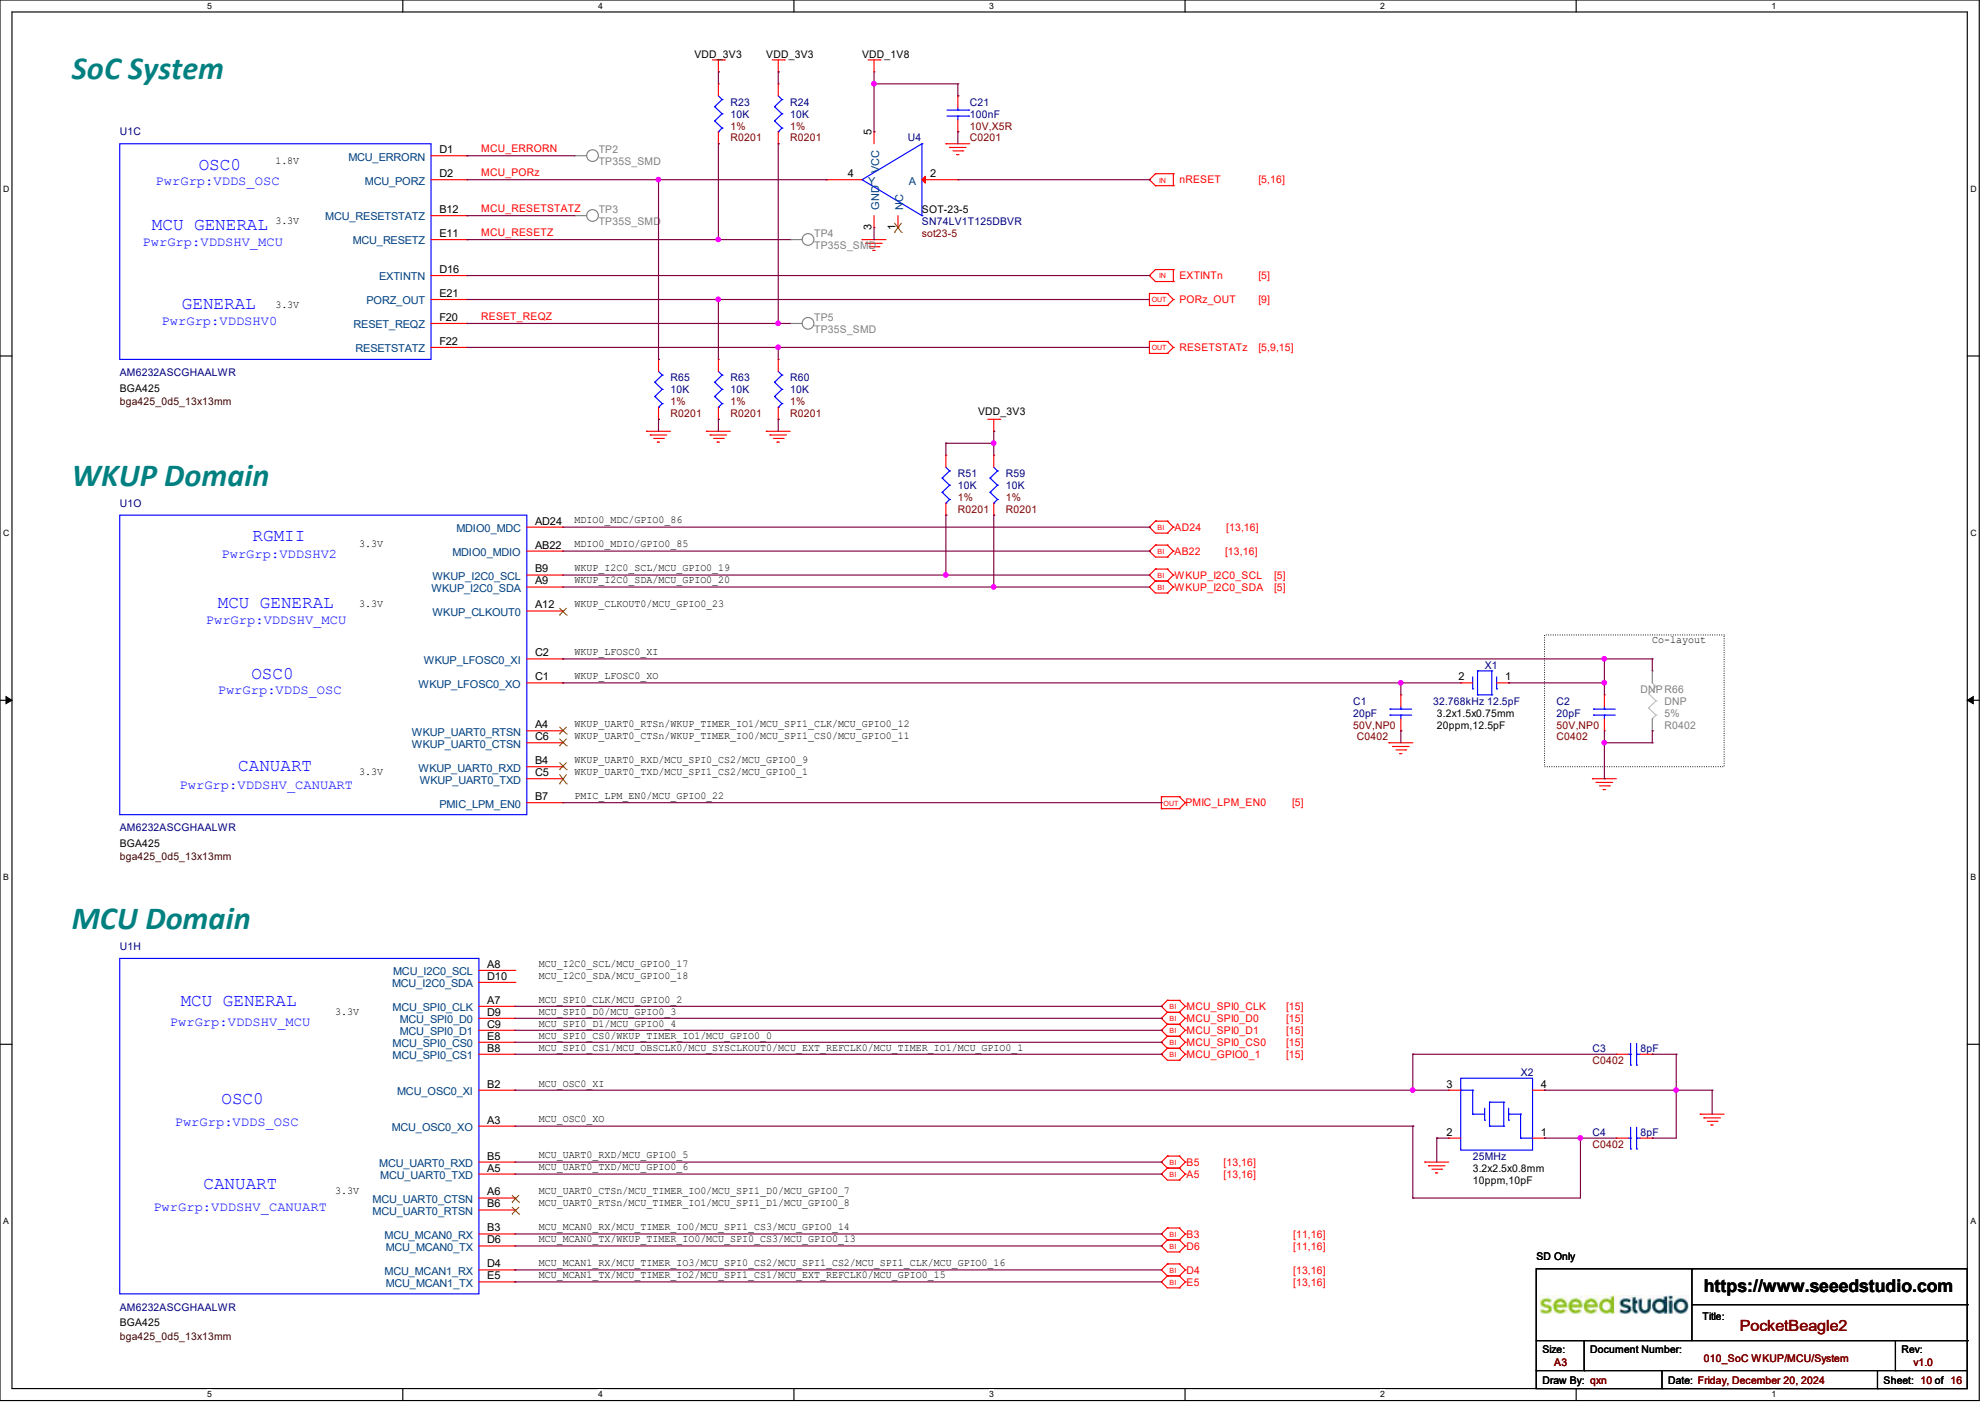
[picture p22: page 10]

https://www.seeedstudio.com

# SoC GPIO

## GPMC

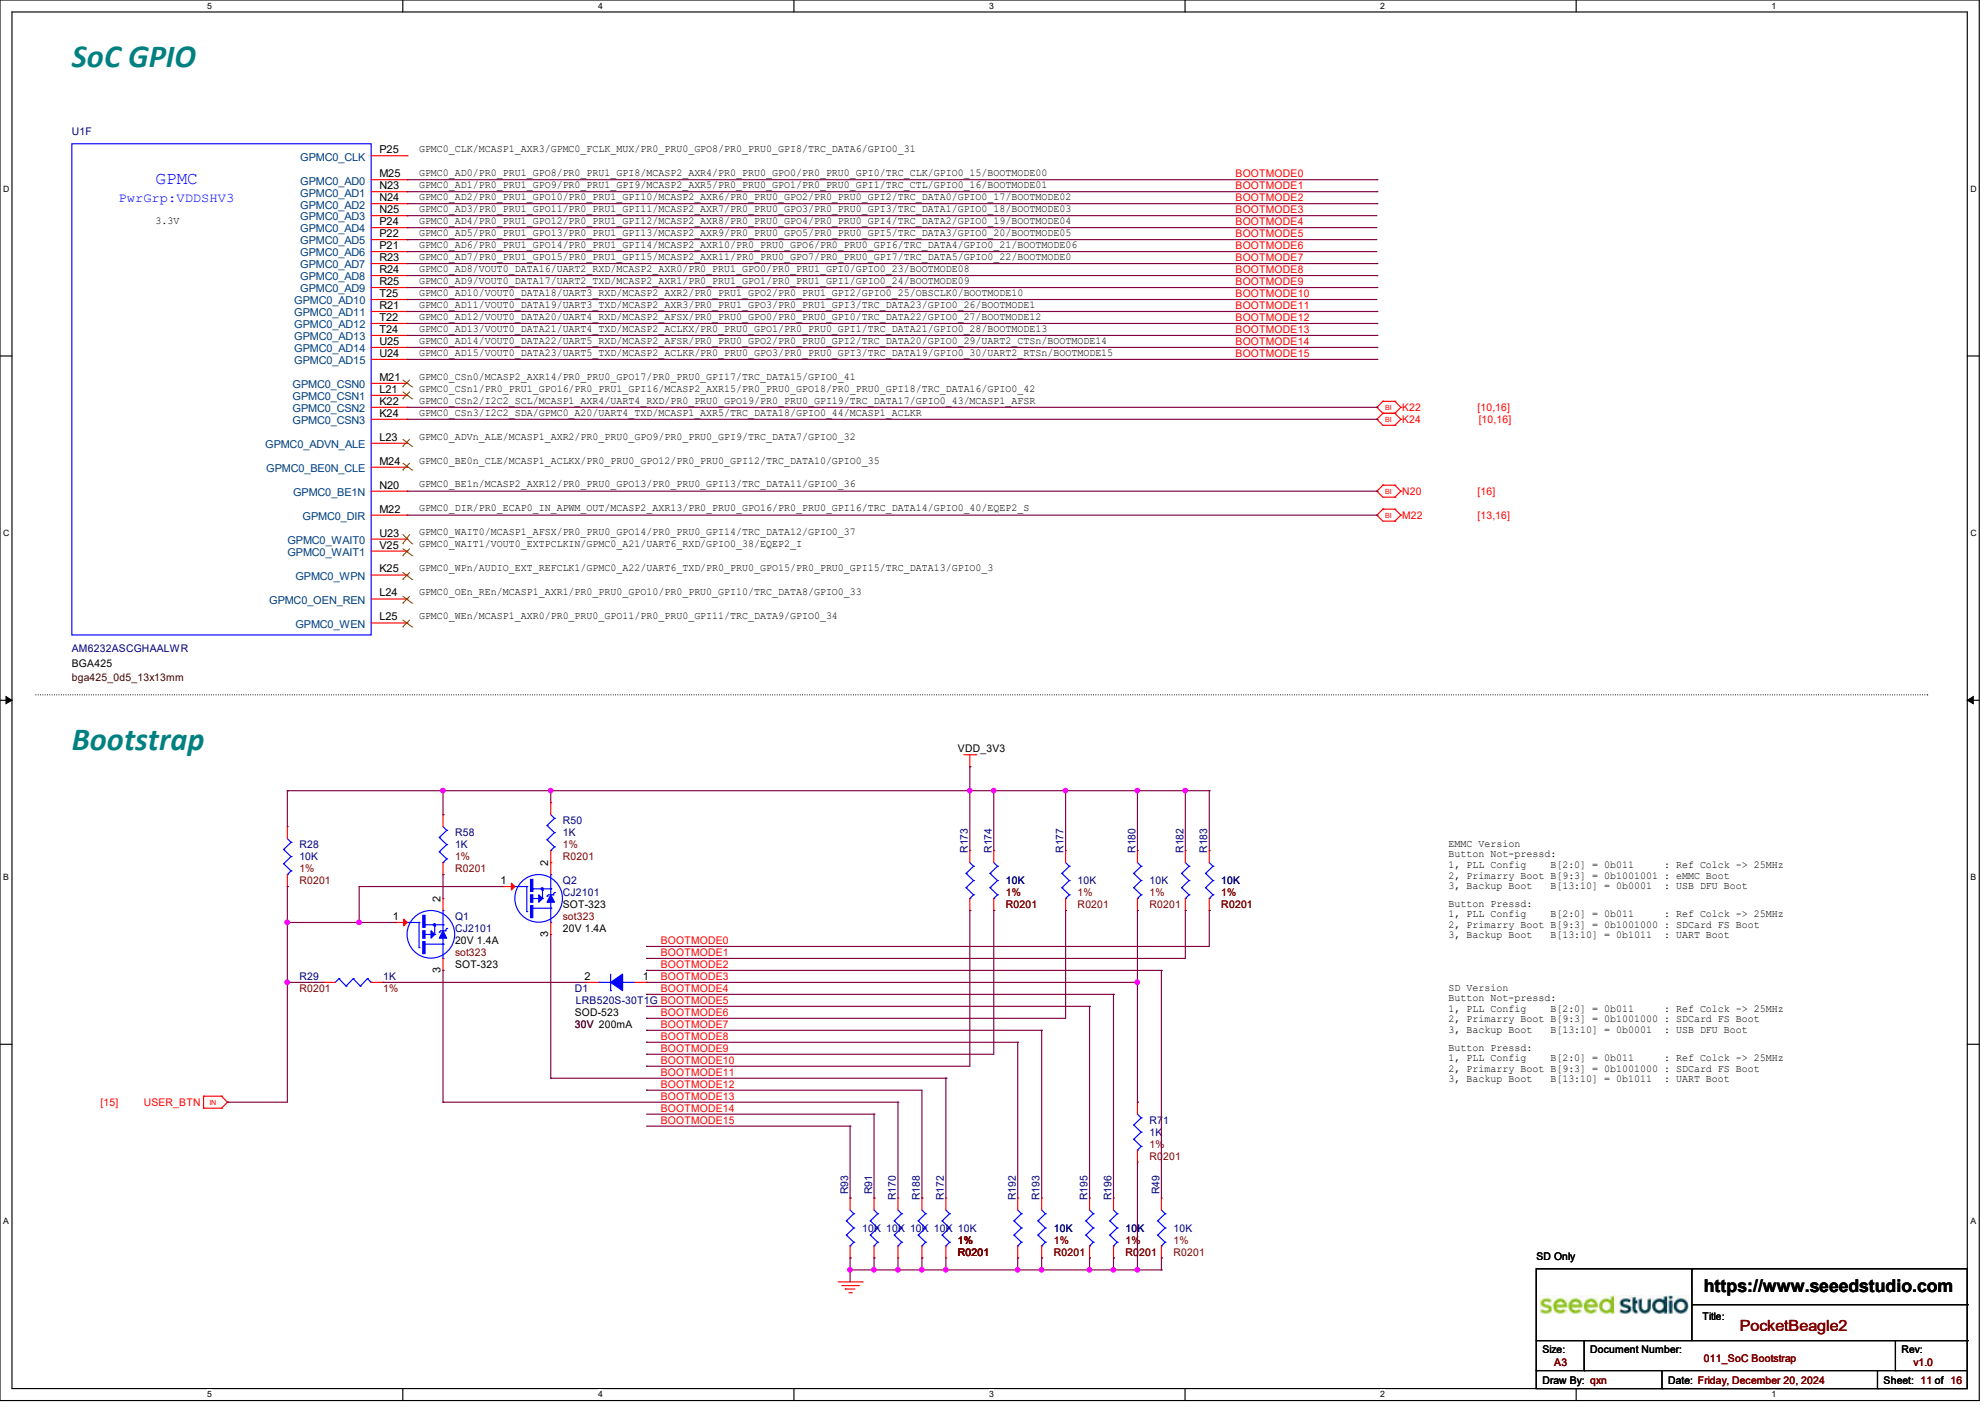
[picture p23: page 11]

EMMC Version
Button Not-pressd:
2, Primarry Boot B[9:3] = 0b1001001 : eMMC Boot

Button Pressd:
2, Primarry Boot B[9:3] = 0b1001000 : SDCard FS Boot

SD Version

https://www.seeedstudio.com

# RGMII

## RGMII1

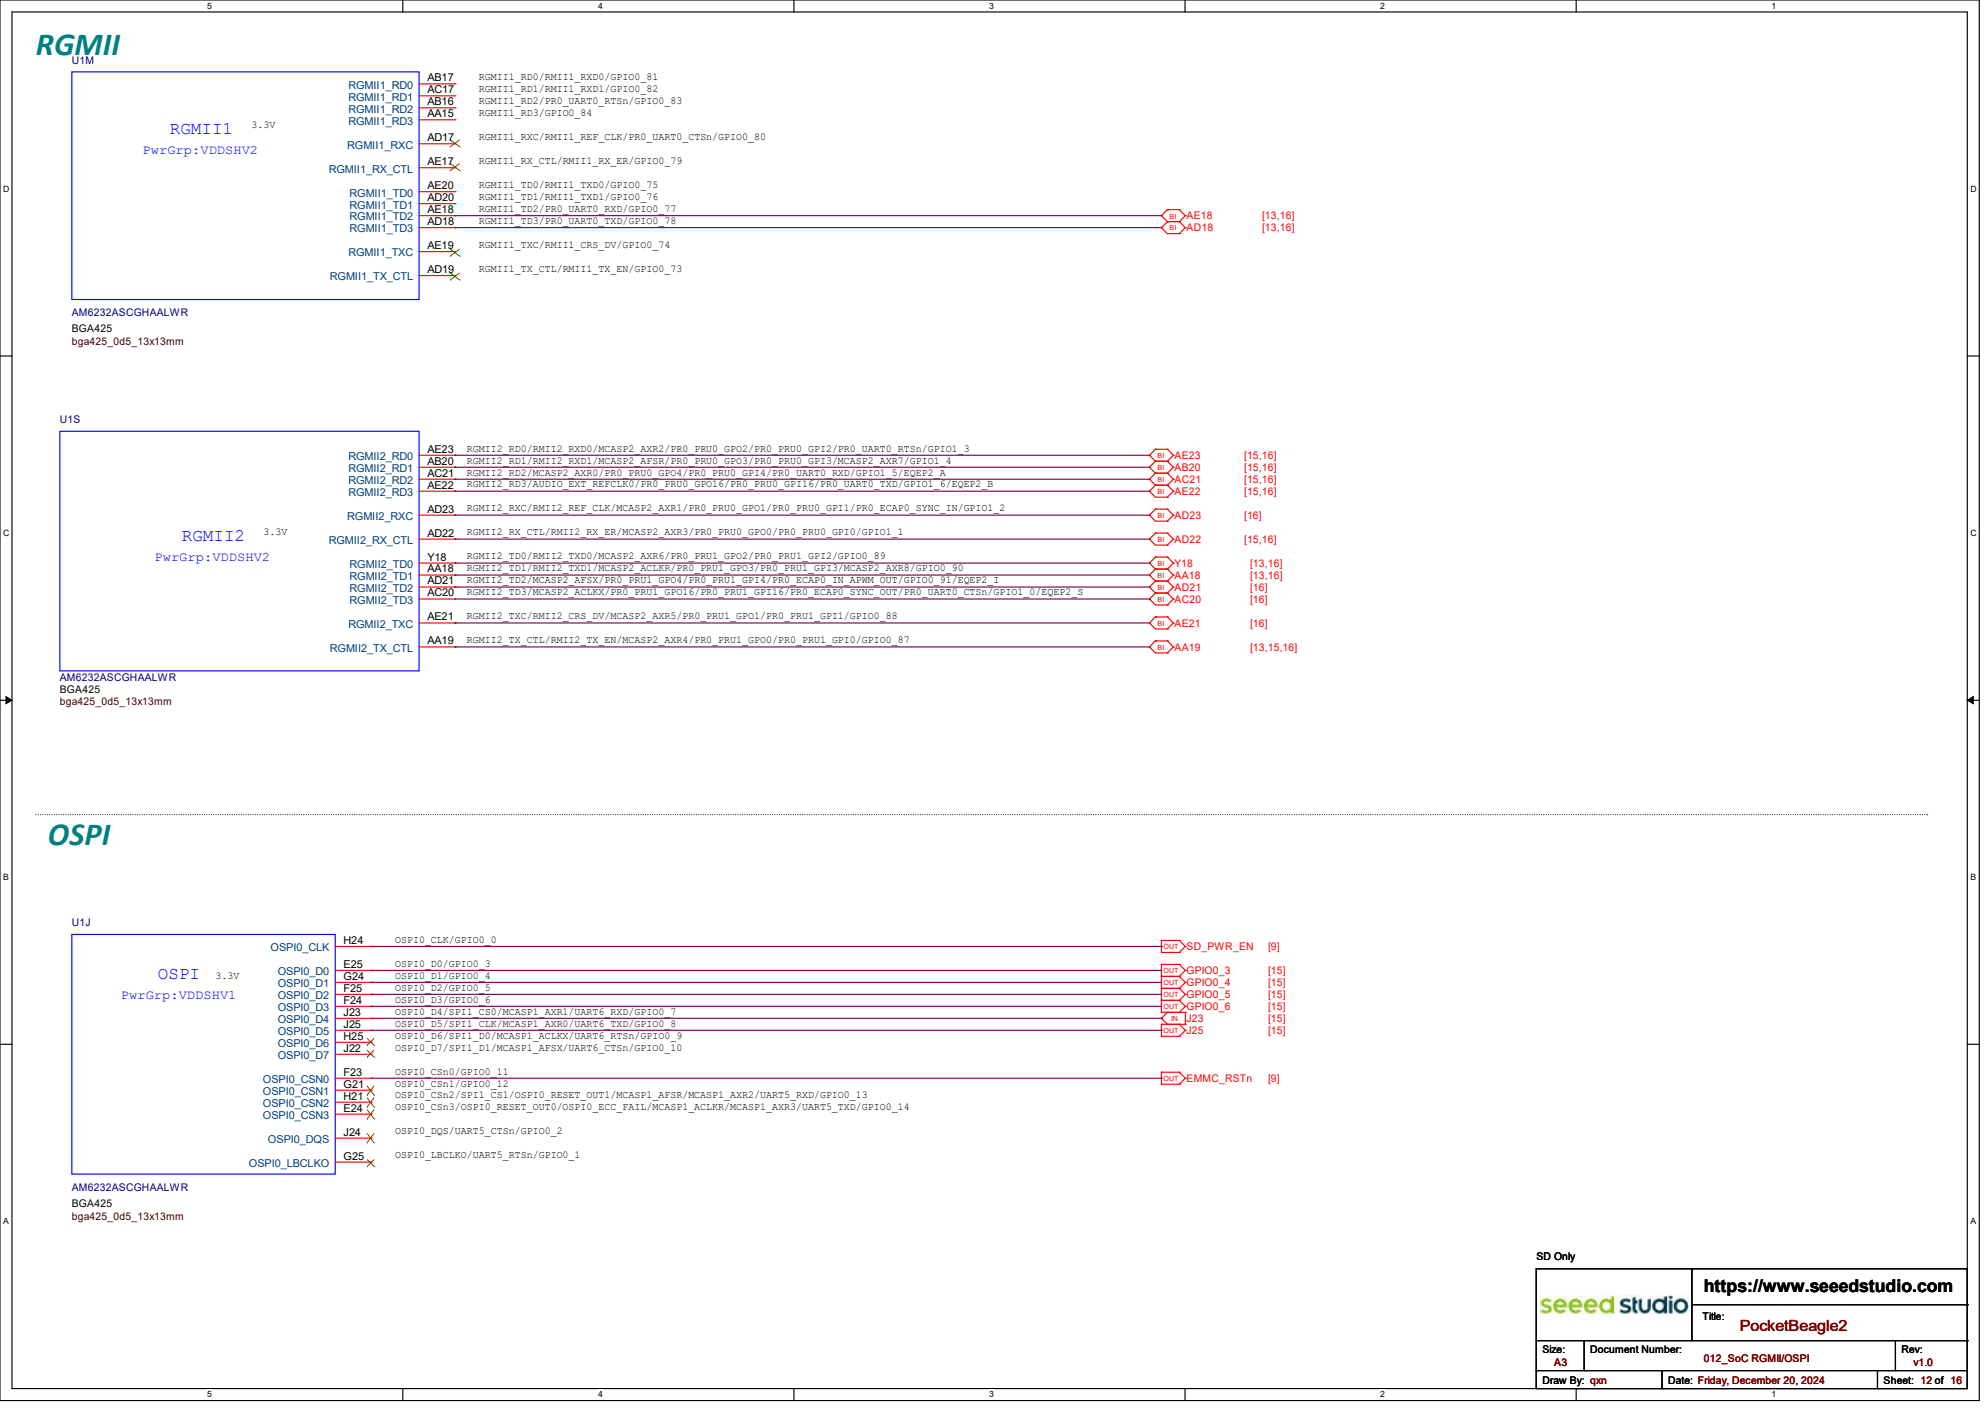
[picture p24: page 12]
OSPI0_DQS/UART5_CTSn/GPIO0_2; OSPI0_CSn3/OSPI0_RESET_OUT0/OSPI0_ECC_FAIL/MCASP1_ACLKR/MCASP1_AXR3/UART5_TXD/GPIO0_14; OSPI0_D0/GPIO0_3; OSPI0_CSn1/GPIO0_12; OSPI0_CLK/GPIO0_0; OSPI0_CSn2/SPI1_CS1/OSPI0_RESET_OUT1/MCASP1_AFSR/MCASP1_AXR2/UART5_RXD/GPIO0_13; OSPI0_D2/GPIO0_5 OSPI0_D3/GPIO0_6 OSPI0_D4/SPI1_CS0/MCASP1_AXR1/UART6_RXD/GPIO0_7; OSPI0_D1/GPIO0_4; OSPI0_D7/SPI1_D1/MCASP1_AFSX/UART6_CTSn/GPIO0_10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

https://www.seeedstudio.com

# SoC GPIO

3.3V

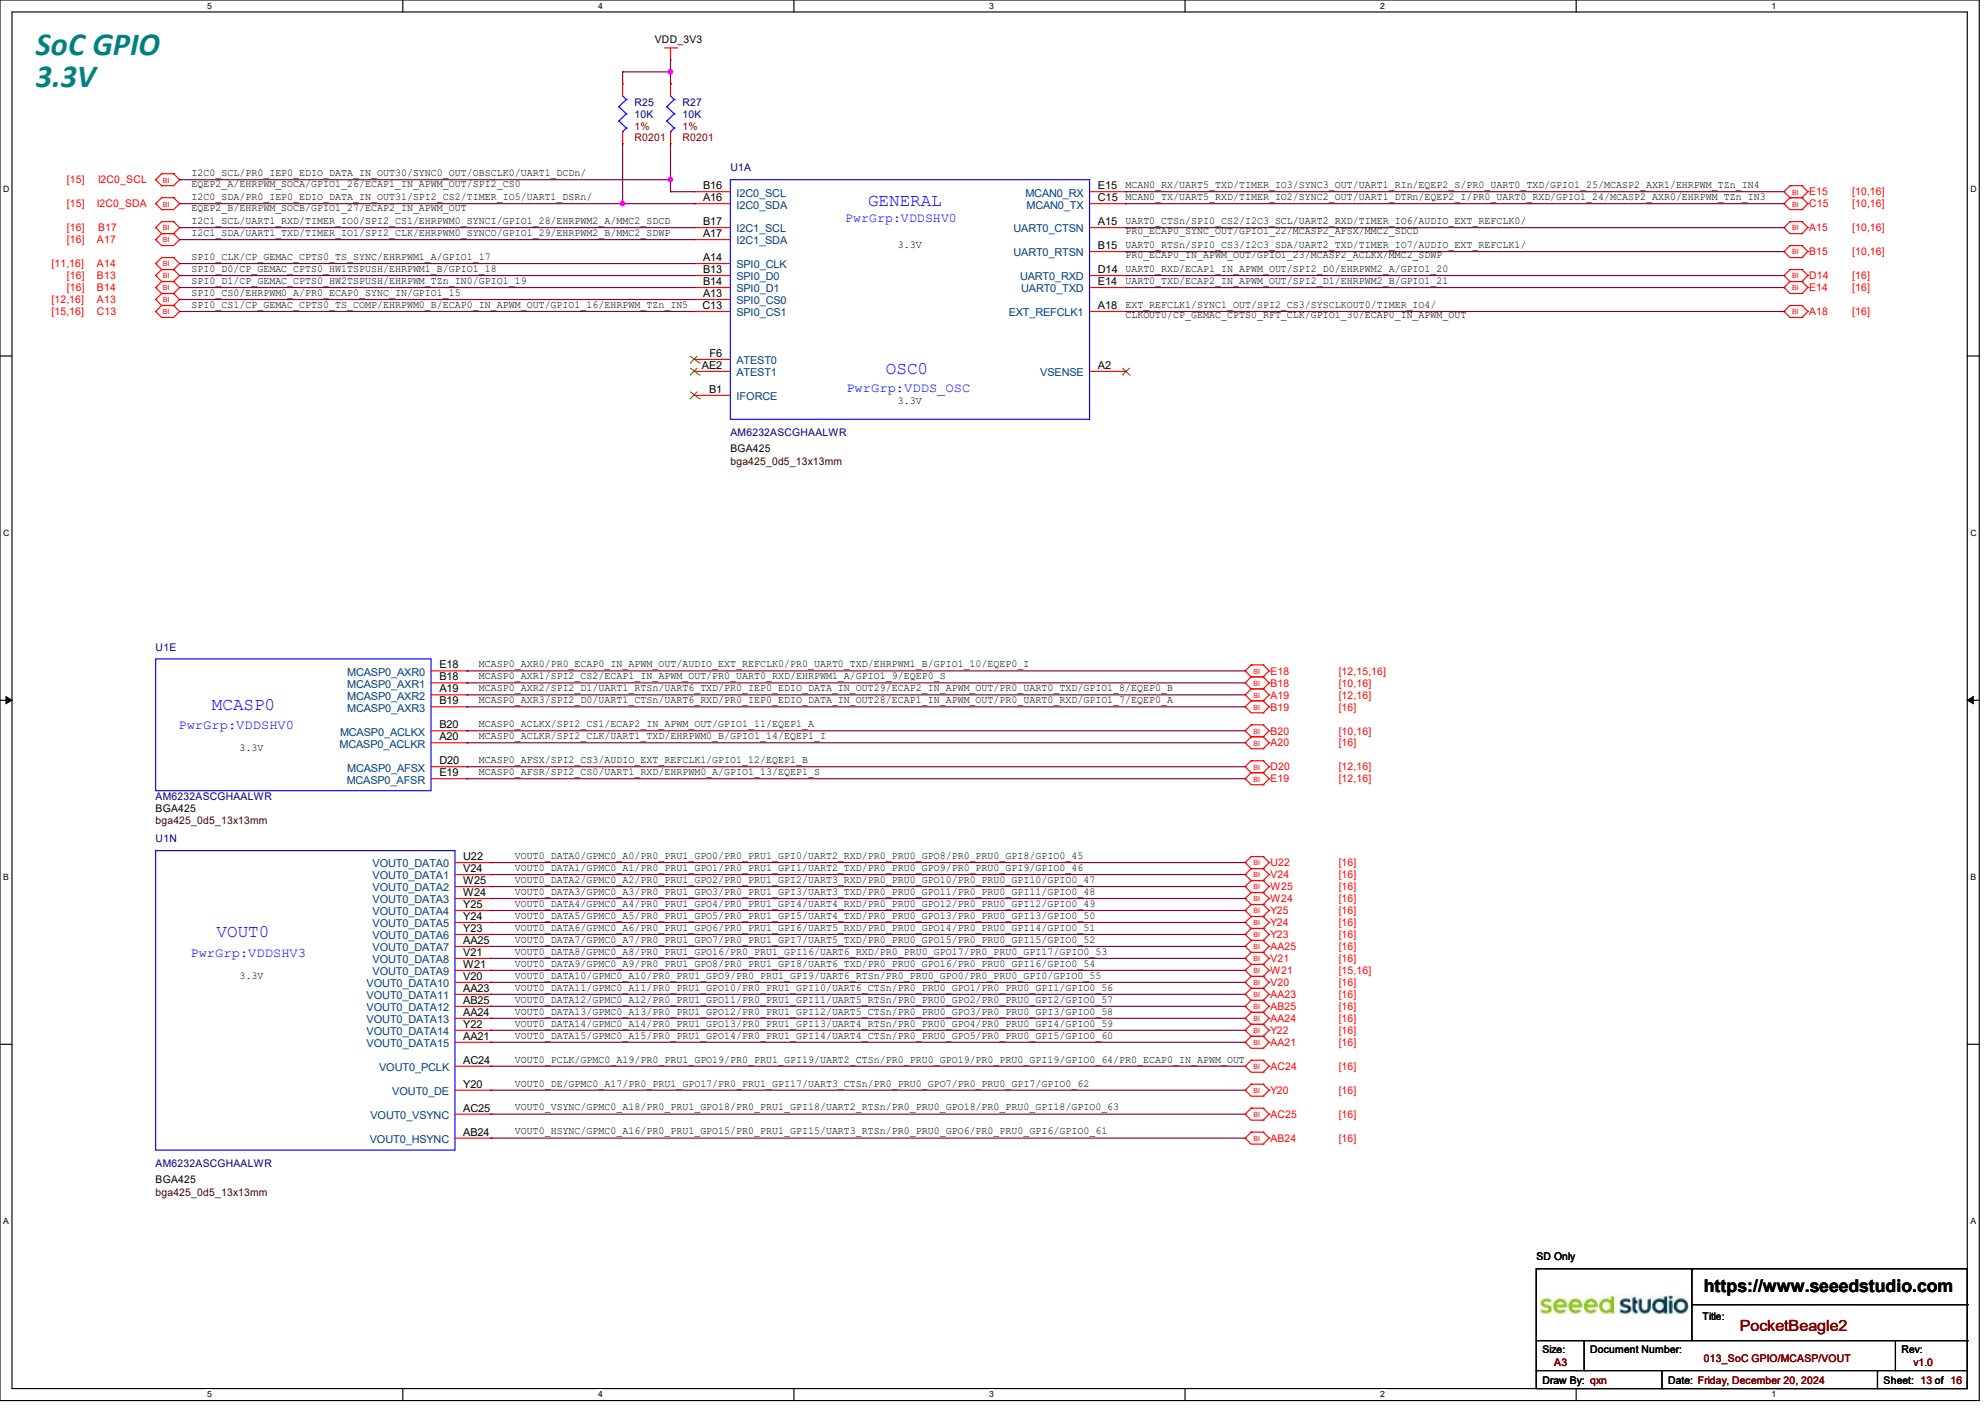
[picture p25: page 13]

https://www.seeedstudio.com

# USB_A & USB_C

## USB0

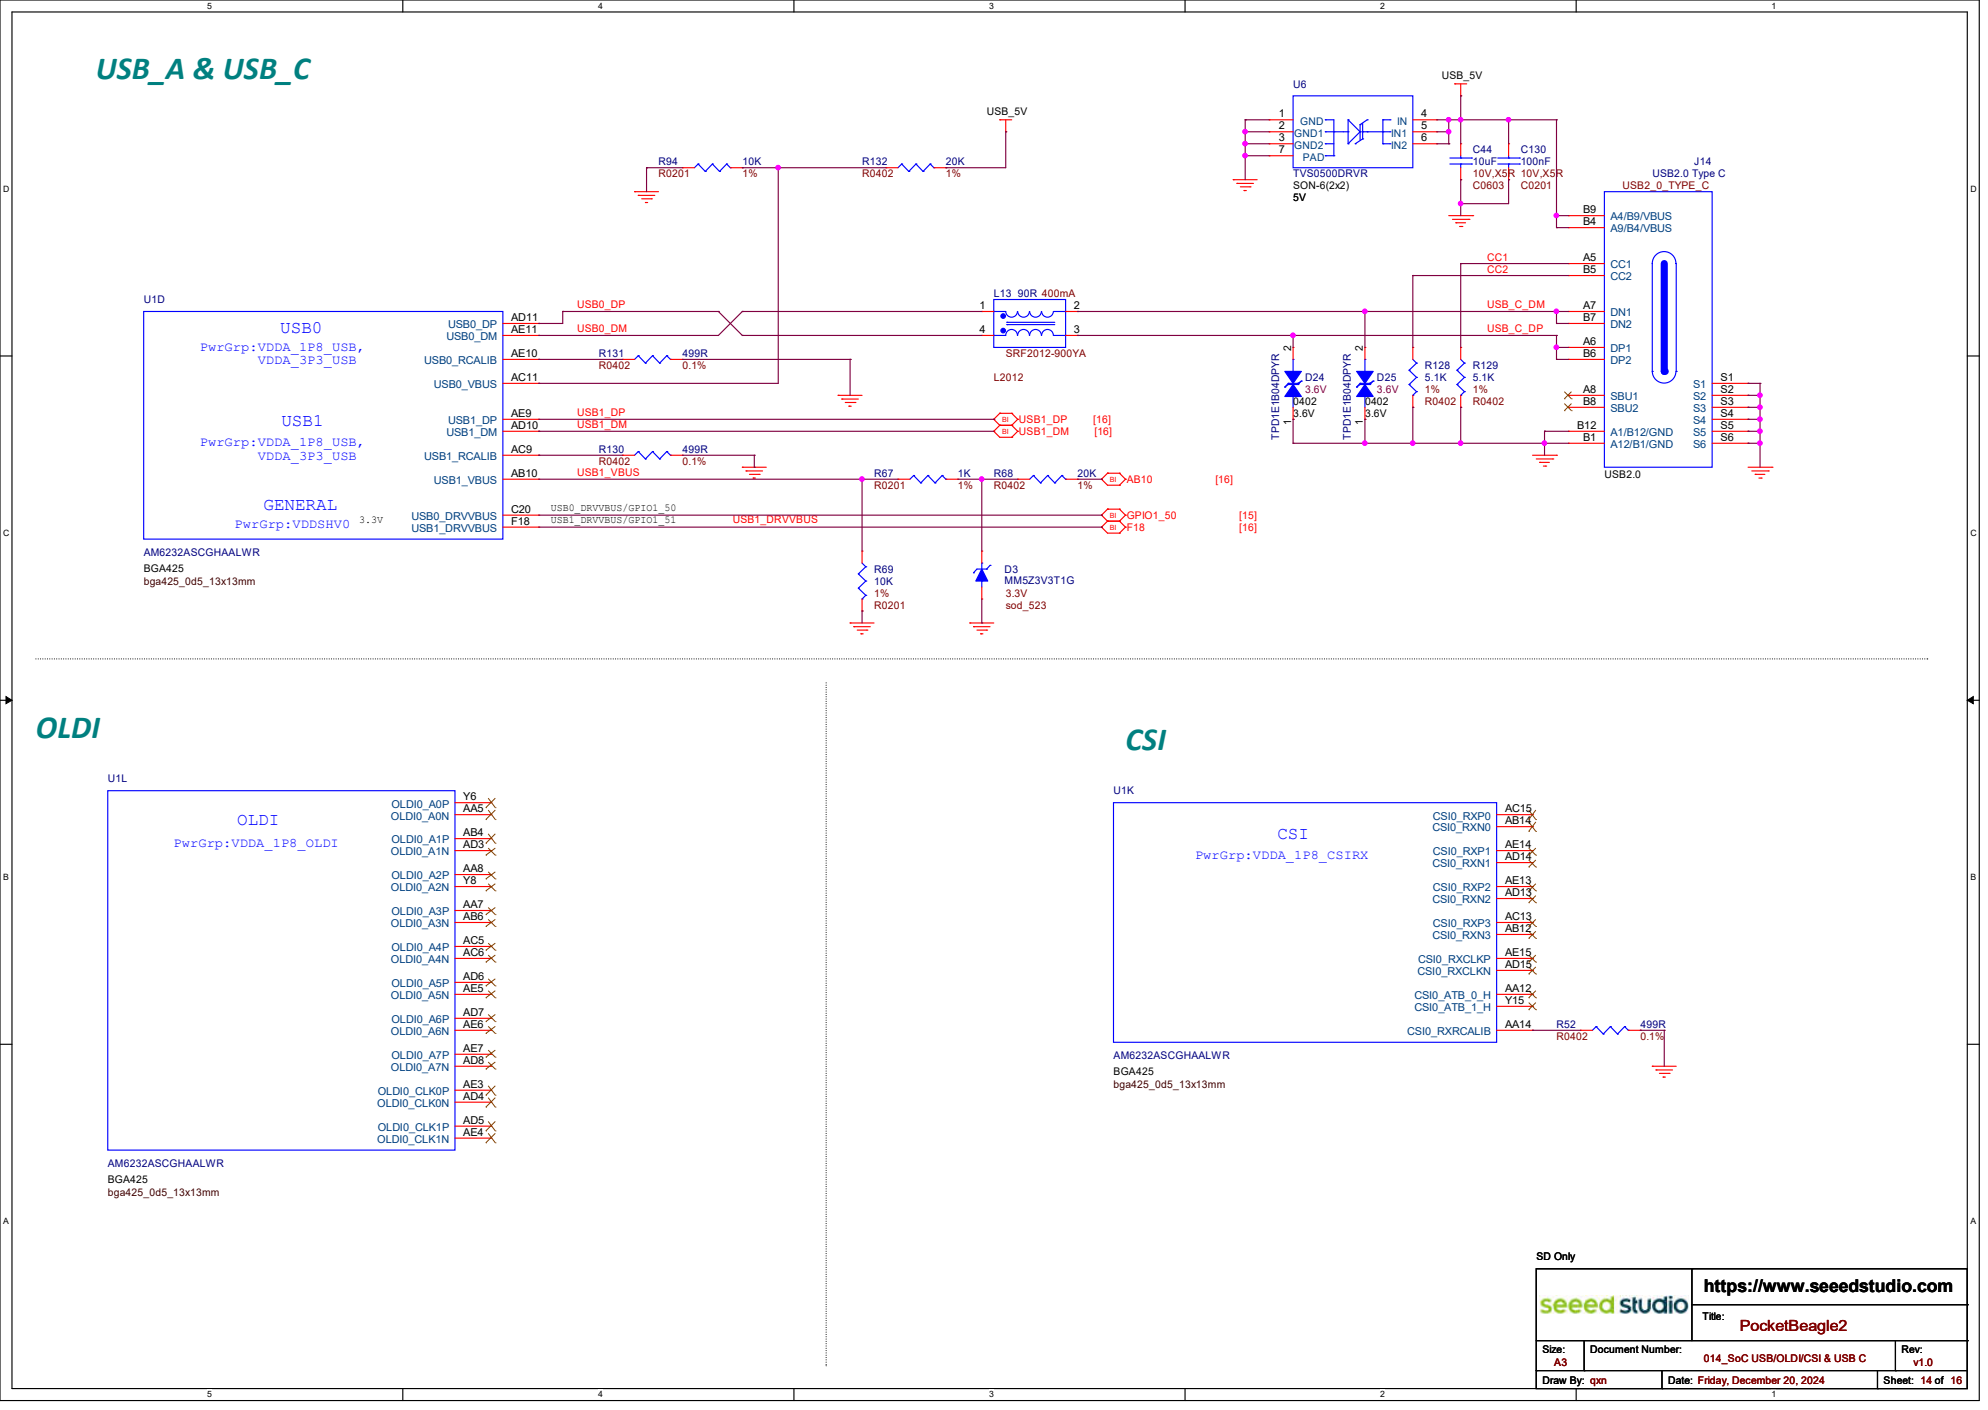
[picture p26: page 14]

https://www.seeedstudio.com

014_SoC USB/OLDI/CSI & USB C

# JTAG

# Tag-Connect

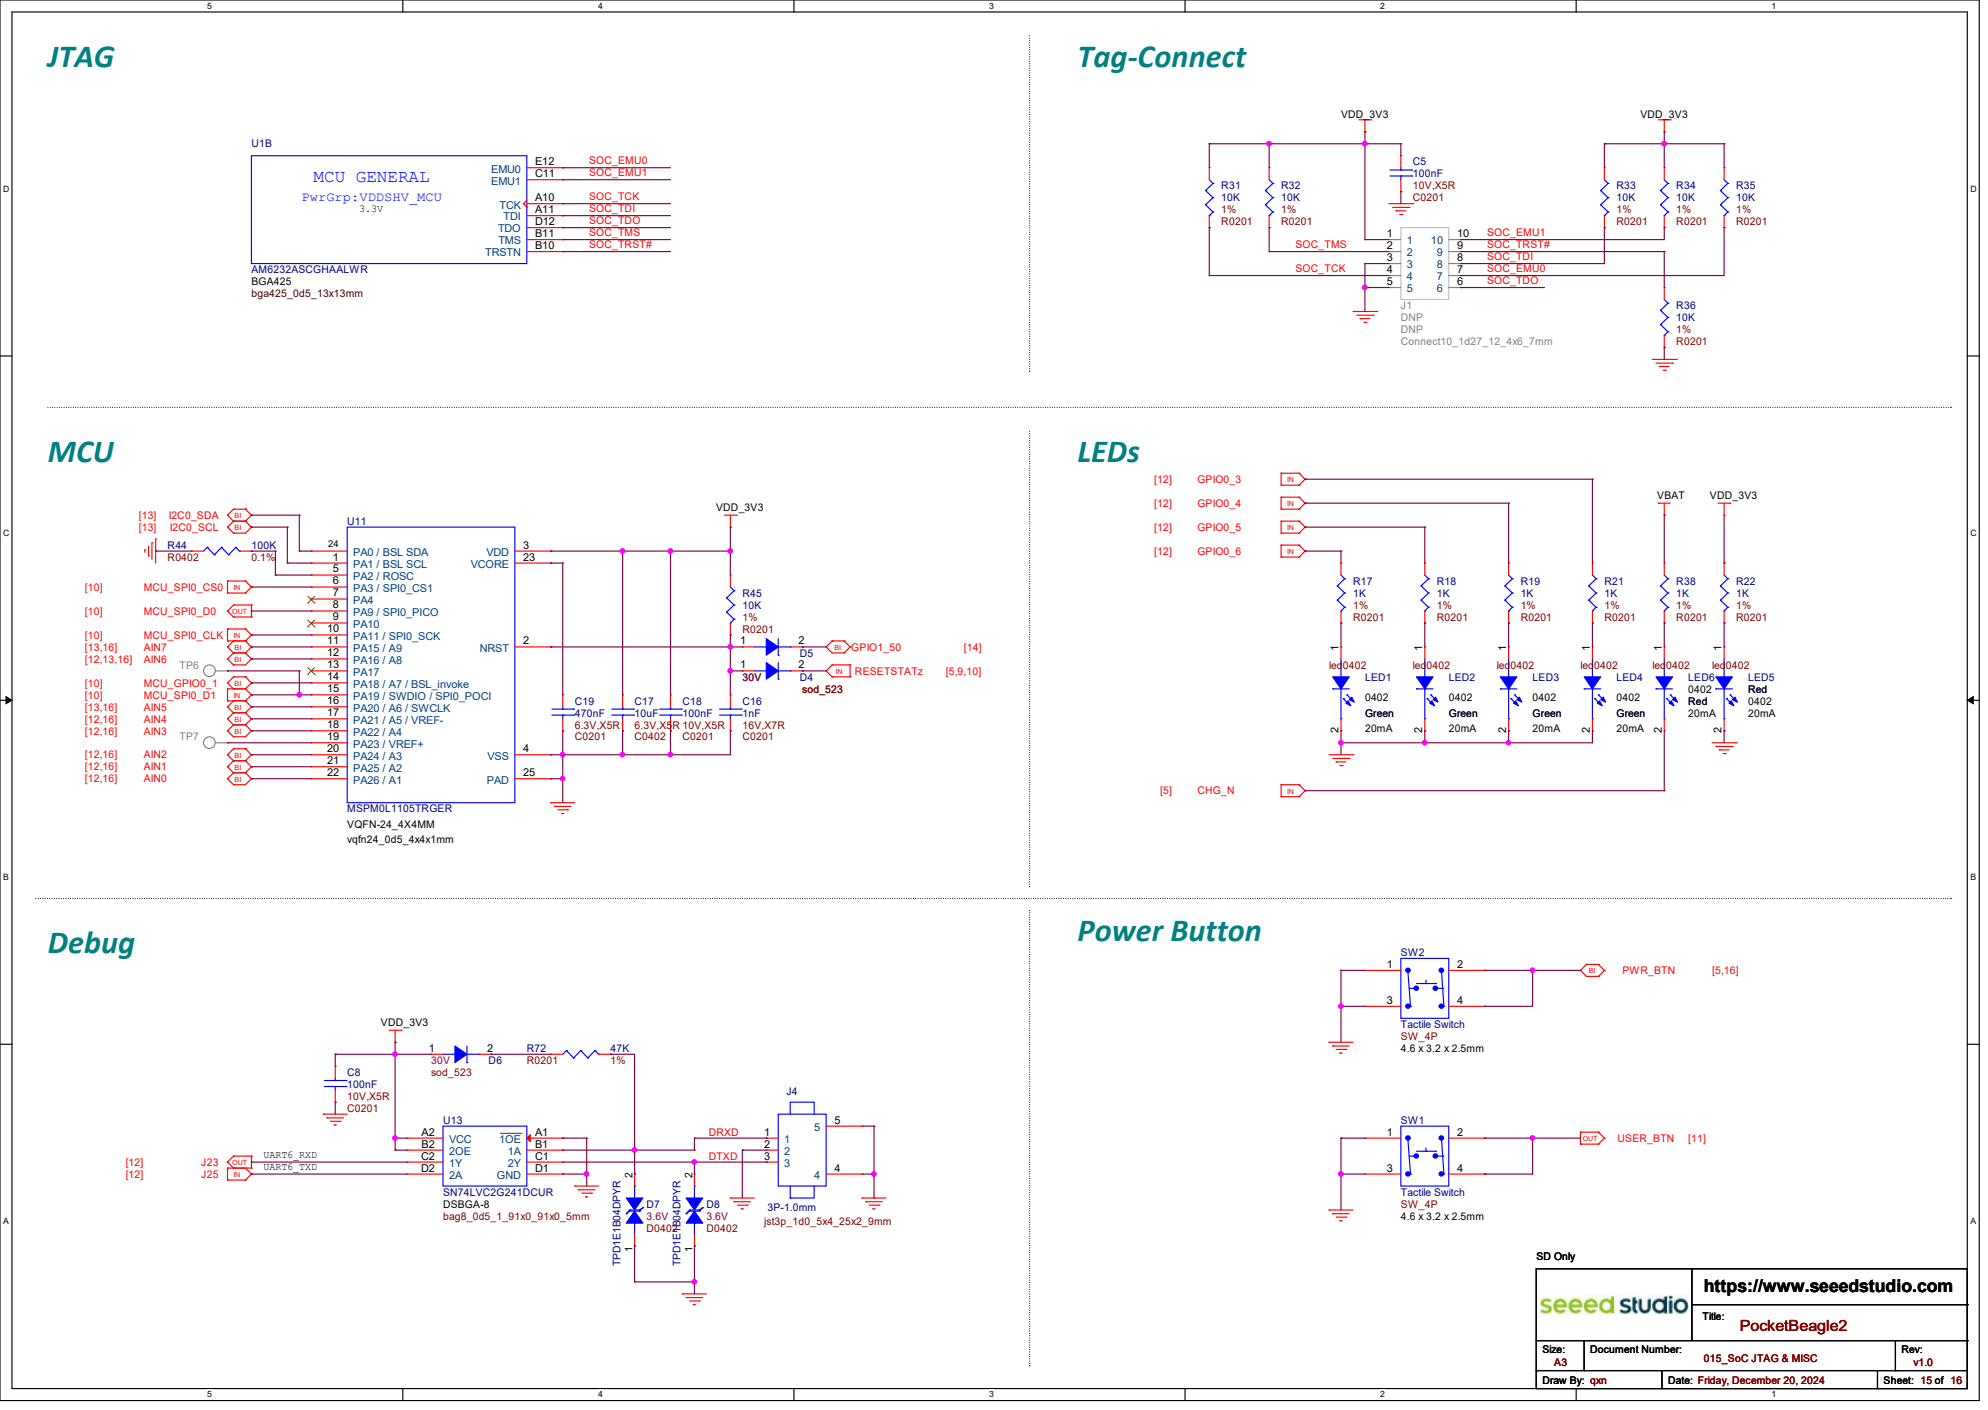
[picture p27: page 15]

https://www.seeedstudio.com

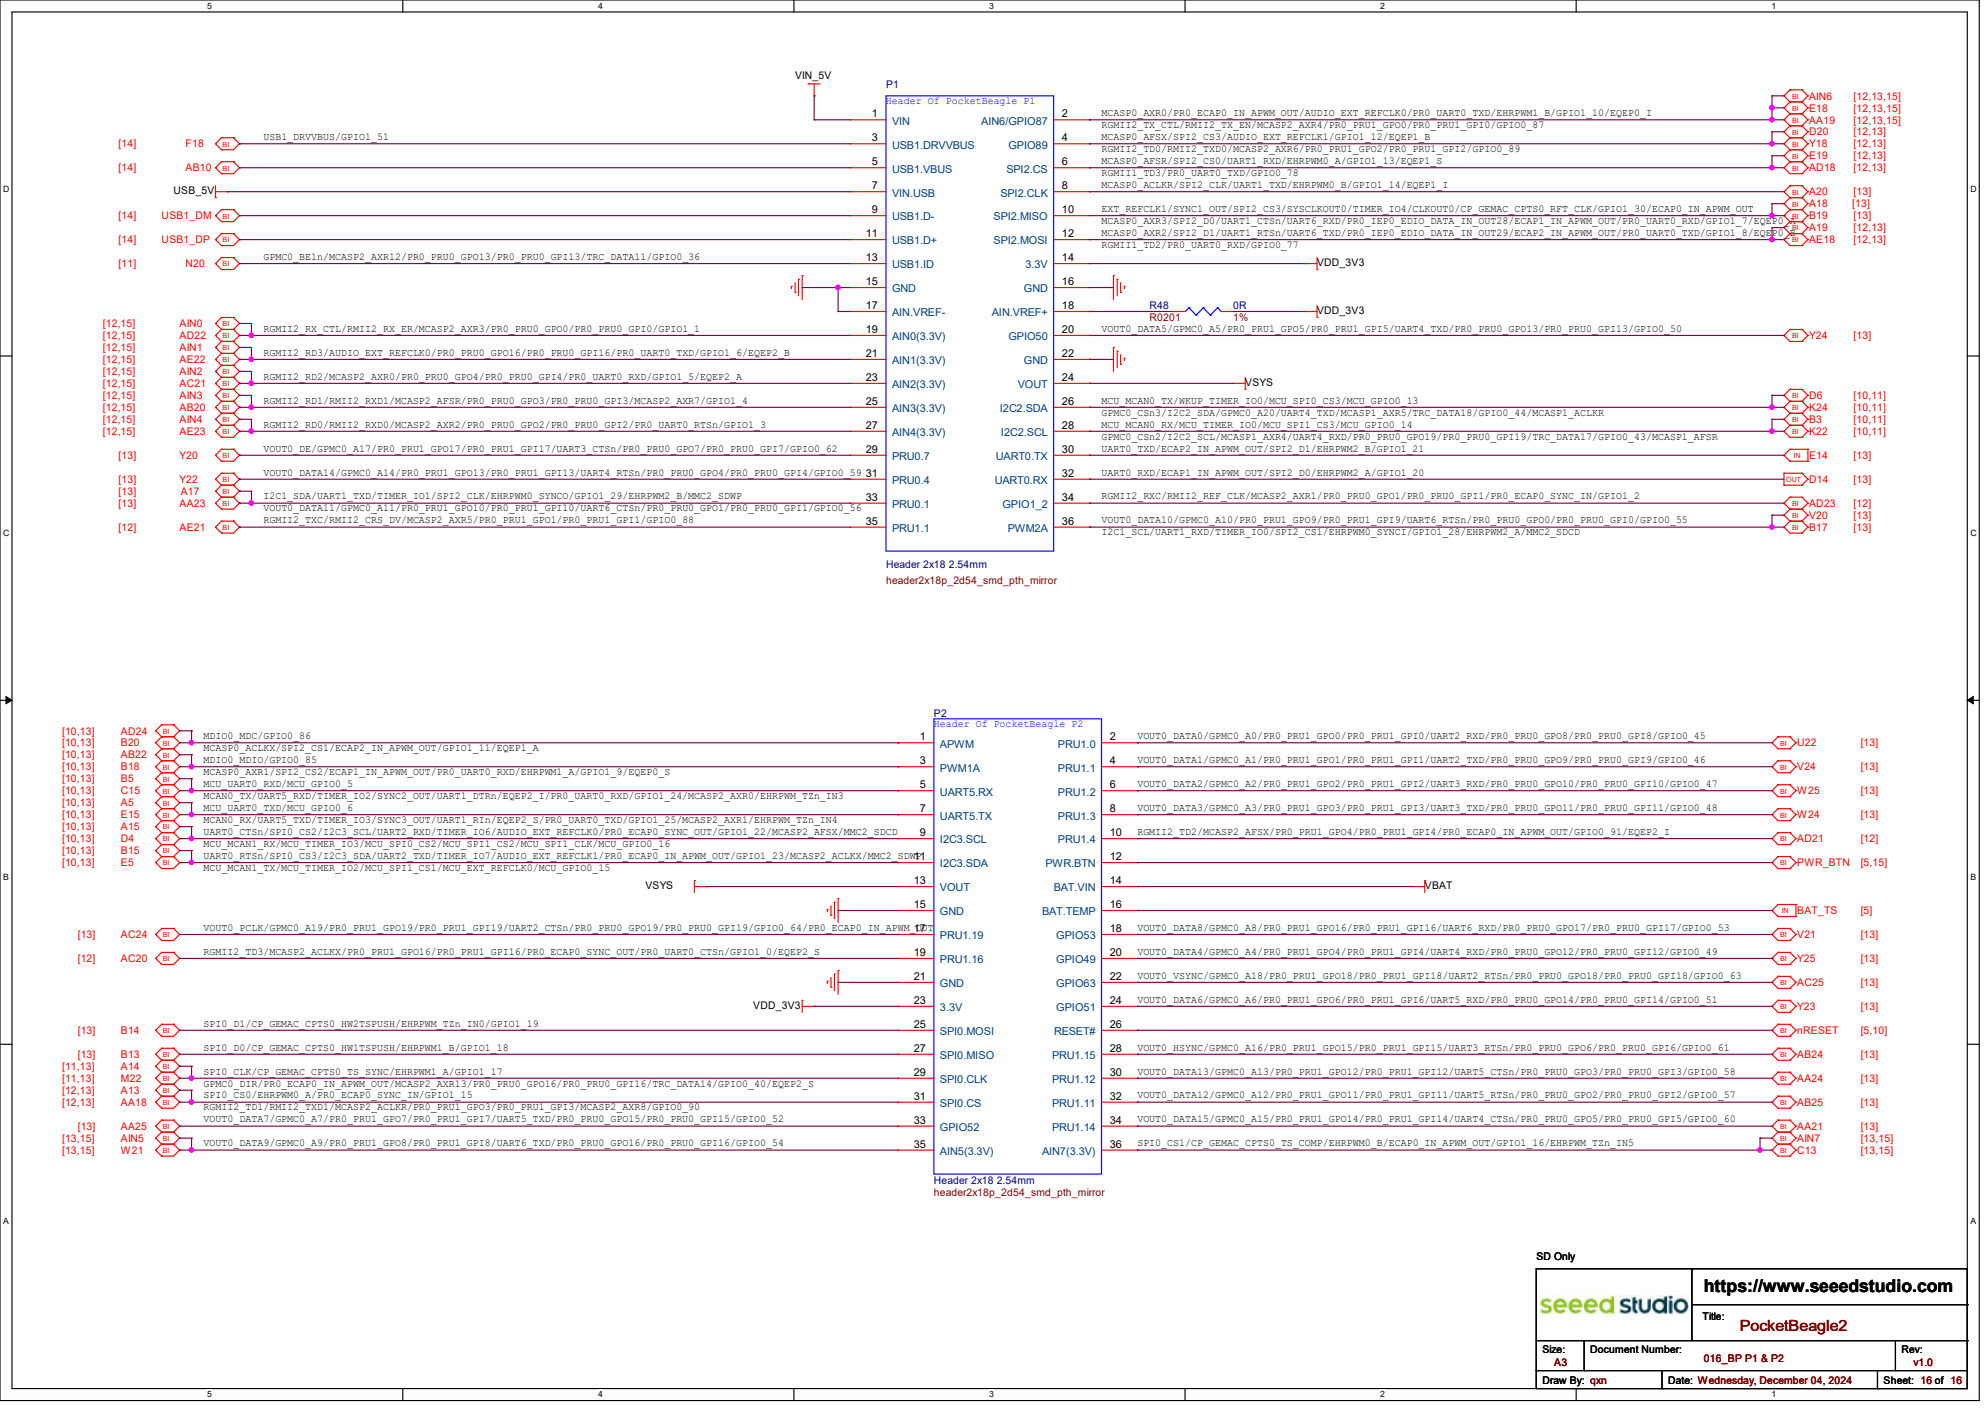
[picture p28: page 16]

https://www.seeedstudio.com
