beagleboard/pocketbeagle-2/design/old/PocketBeagle2 sch v0.3 20221102.pdf

VER # | DATE | AUTHOR DESCRIPTION OF CHANGES
0.1 | First release | qxn

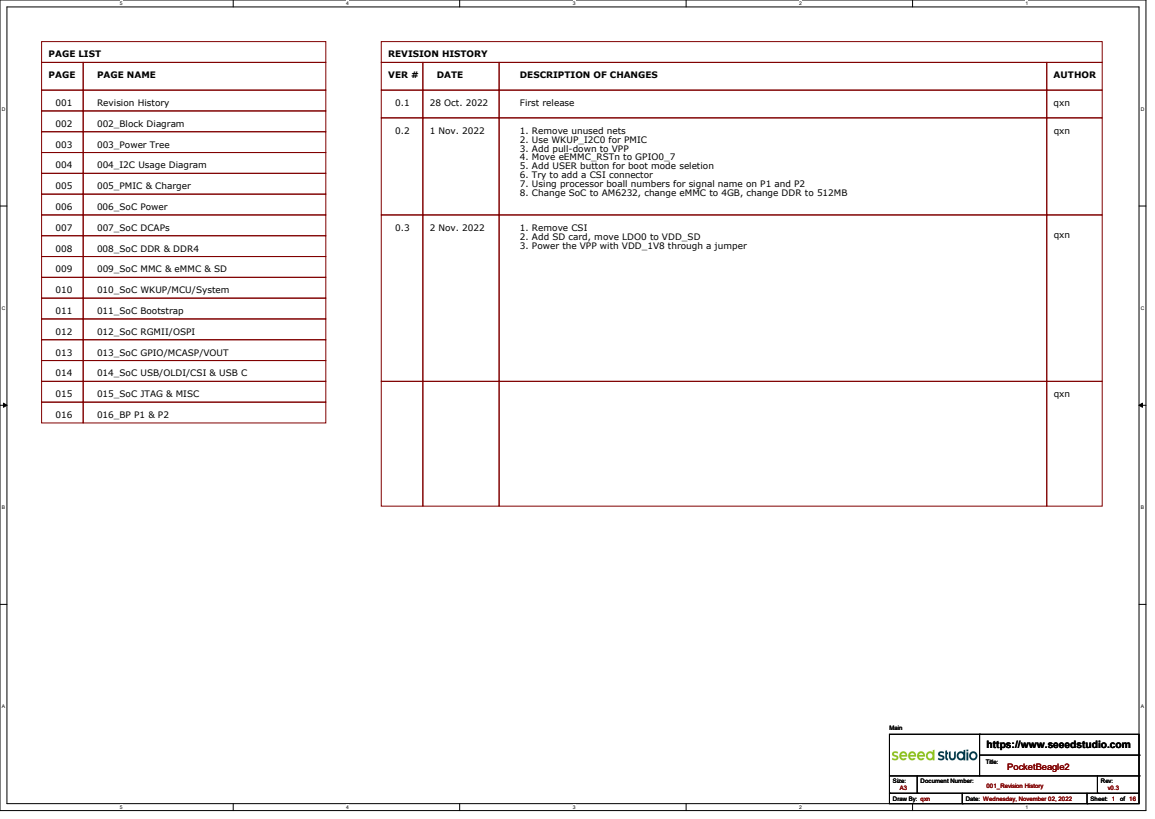
[picture p93: page 1]
qxn; 28 Oct. 2022; PAGE; 001 Revision History; PAGE NAME; PAGE LIST; REVISION HISTORY; 002 002_Block Diagram; 003 003_Power Tree; 004 004_I2C Usage Diagram; 005 005_PMIC & Charger; 006 006_SoC Power; 007 007_SoC DCAPs; 008 008_SoC DDR & DDR4; 009 009_SoC MMC & eMMC & SD; 1 Nov. 2022; 0.3 1. Remove CSI; 2 Nov. 2022; Title: Size:; Document Number:; Rev: Draw By:; Date:; Sheet:; https://www.seeedstudio.com A3; Wednesday, November 02, 2022; 16 PocketBeagle2; 001_Revision History Main

0.2 1. Remove unused nets

2. Use WKUP_I2C0 for PMIC
3. Add pull-down to VPP
4. Move eEMMC_RSTn to GPIO0_7
5. Add USER button for boot mode seletion
6. Try to add a CSI connector
7. Using processor boall numbers for signal name on P1 and P2
8. Change SoC to AM6232, change eMMC to 4GB, change DDR to 512MB

2. Add SD card, move LDO0 to VDD_SD
3. Power the VPP with VDD_1V8 through a jumper

010_SoC WKUP/MCU/System
011_SoC Bootstrap
012_SoC RGMII/OSPI
013_SoC GPIO/MCASP/VOUT
014_SoC USB/OLDI/CSI & USB C
015_SoC JTAG & MISC

# Block Diagram

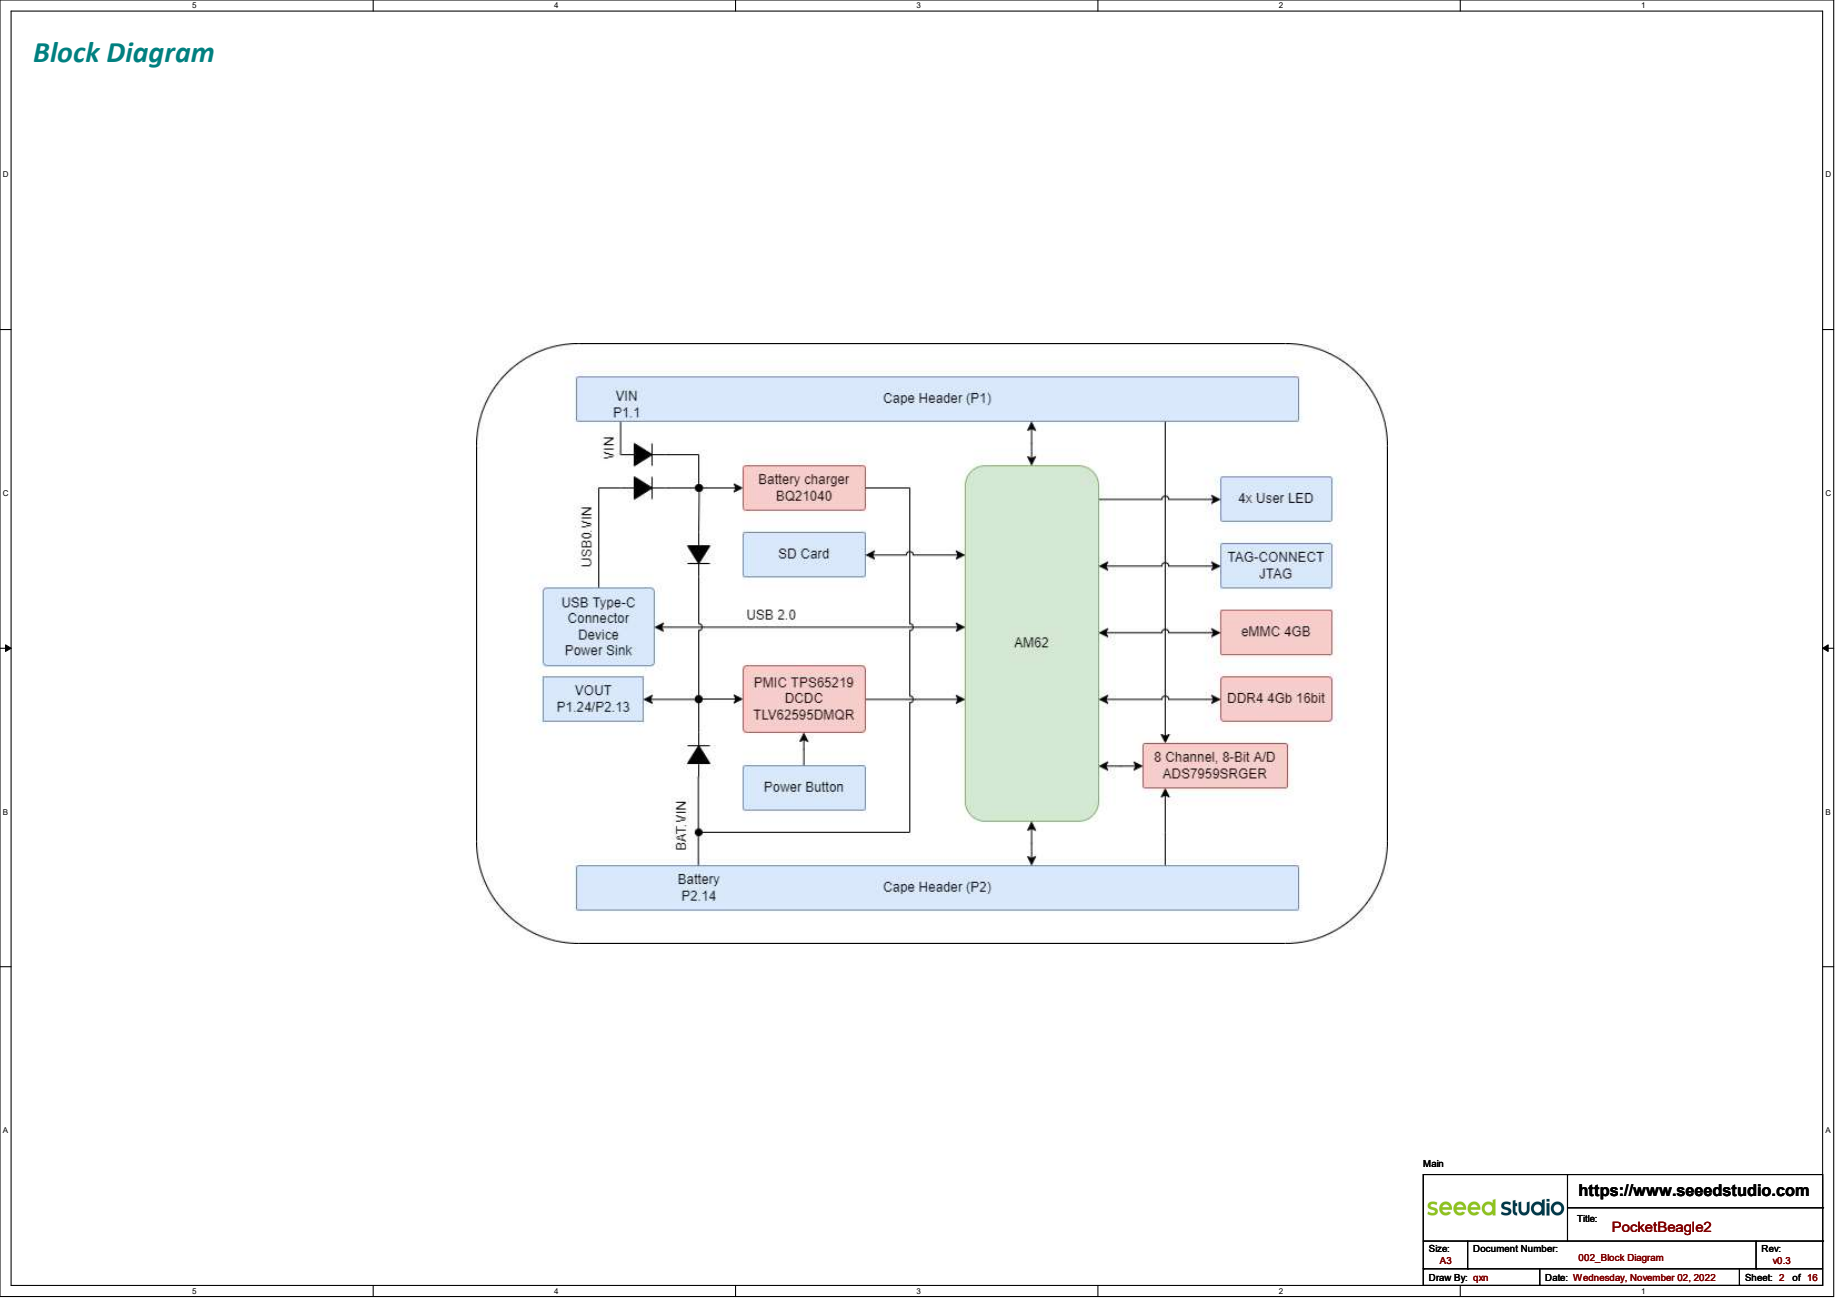
[picture p94: page 2]
https://www.seeedstudio.com A3; qxn; Wednesday, November 02, 2022; 16 PocketBeagle2; 002_Block Diagram; Main; Title: Size:; Document Number:; Rev: Draw By:; Date:; Sheet:

## Idea Diode

## AC_5V/P1.1

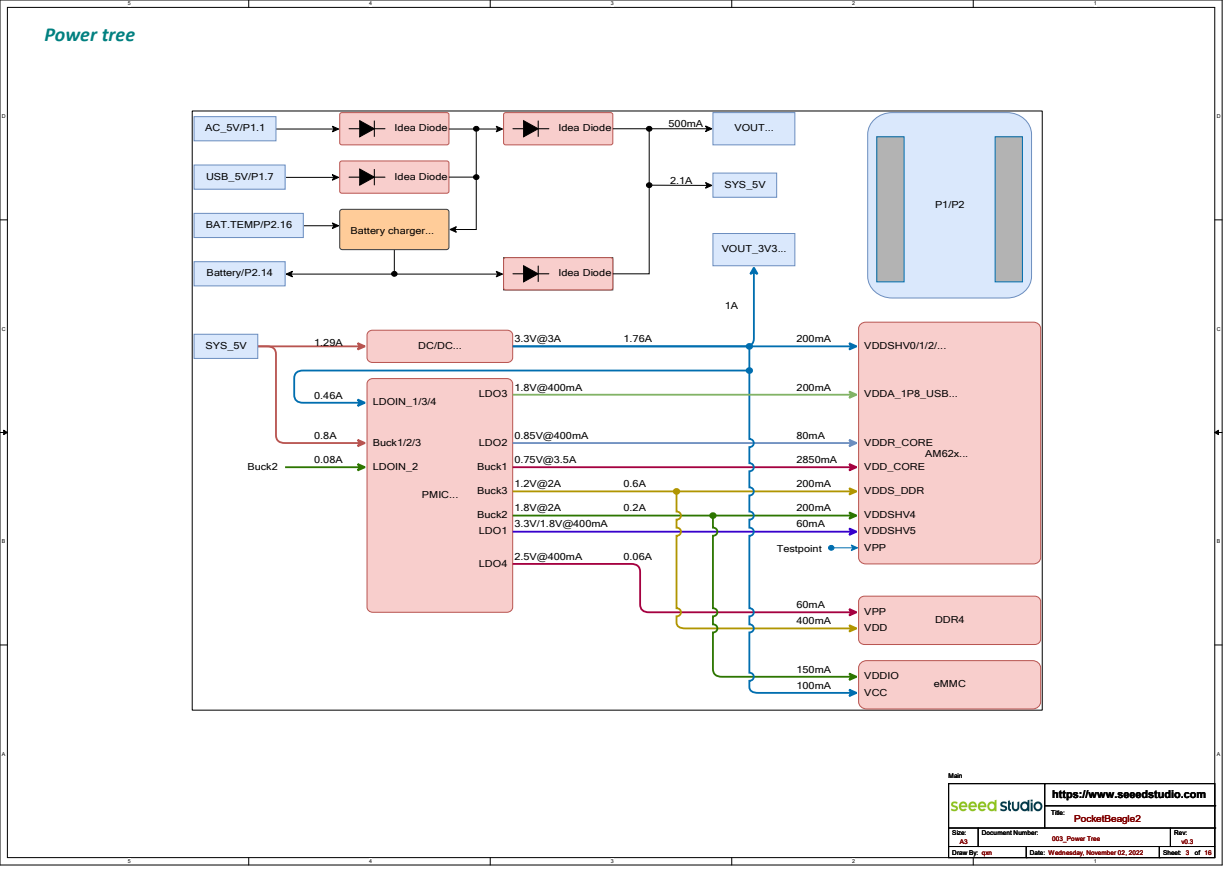
[picture p95: page 3]
PMIC...; DDR4; VPP VDD; eMMC; Buck2 LDO1; Buck1; LDO2; LDO4; Buck3; VDDS_DDR; VDDSHV4; VDDSHV0/1/2/...; VDDSHV5; VDD_CORE; VPP; VDDIO VCC; Buck1/2/3; LDOIN_1/3/4; Testpoint; VDDA_1P8_USB...; VDDR_CORE; Buck2; LDOIN_2 0.08A; LDO3 1.8V@400mA; BAT.TEMP/P2.16; USB_5V/P1.7; Battery/P2.14; Idea Diode; Battery charger...; VOUT...; SYS_5V; VOUT_3V3...; Power tree; https://www.seeedstudio.com A3; qxn; Wednesday, November 02, 2022; 16 PocketBeagle2; 003_Power Tree Main; Title: Size:; Document Number: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

# I2C Usage Diagram

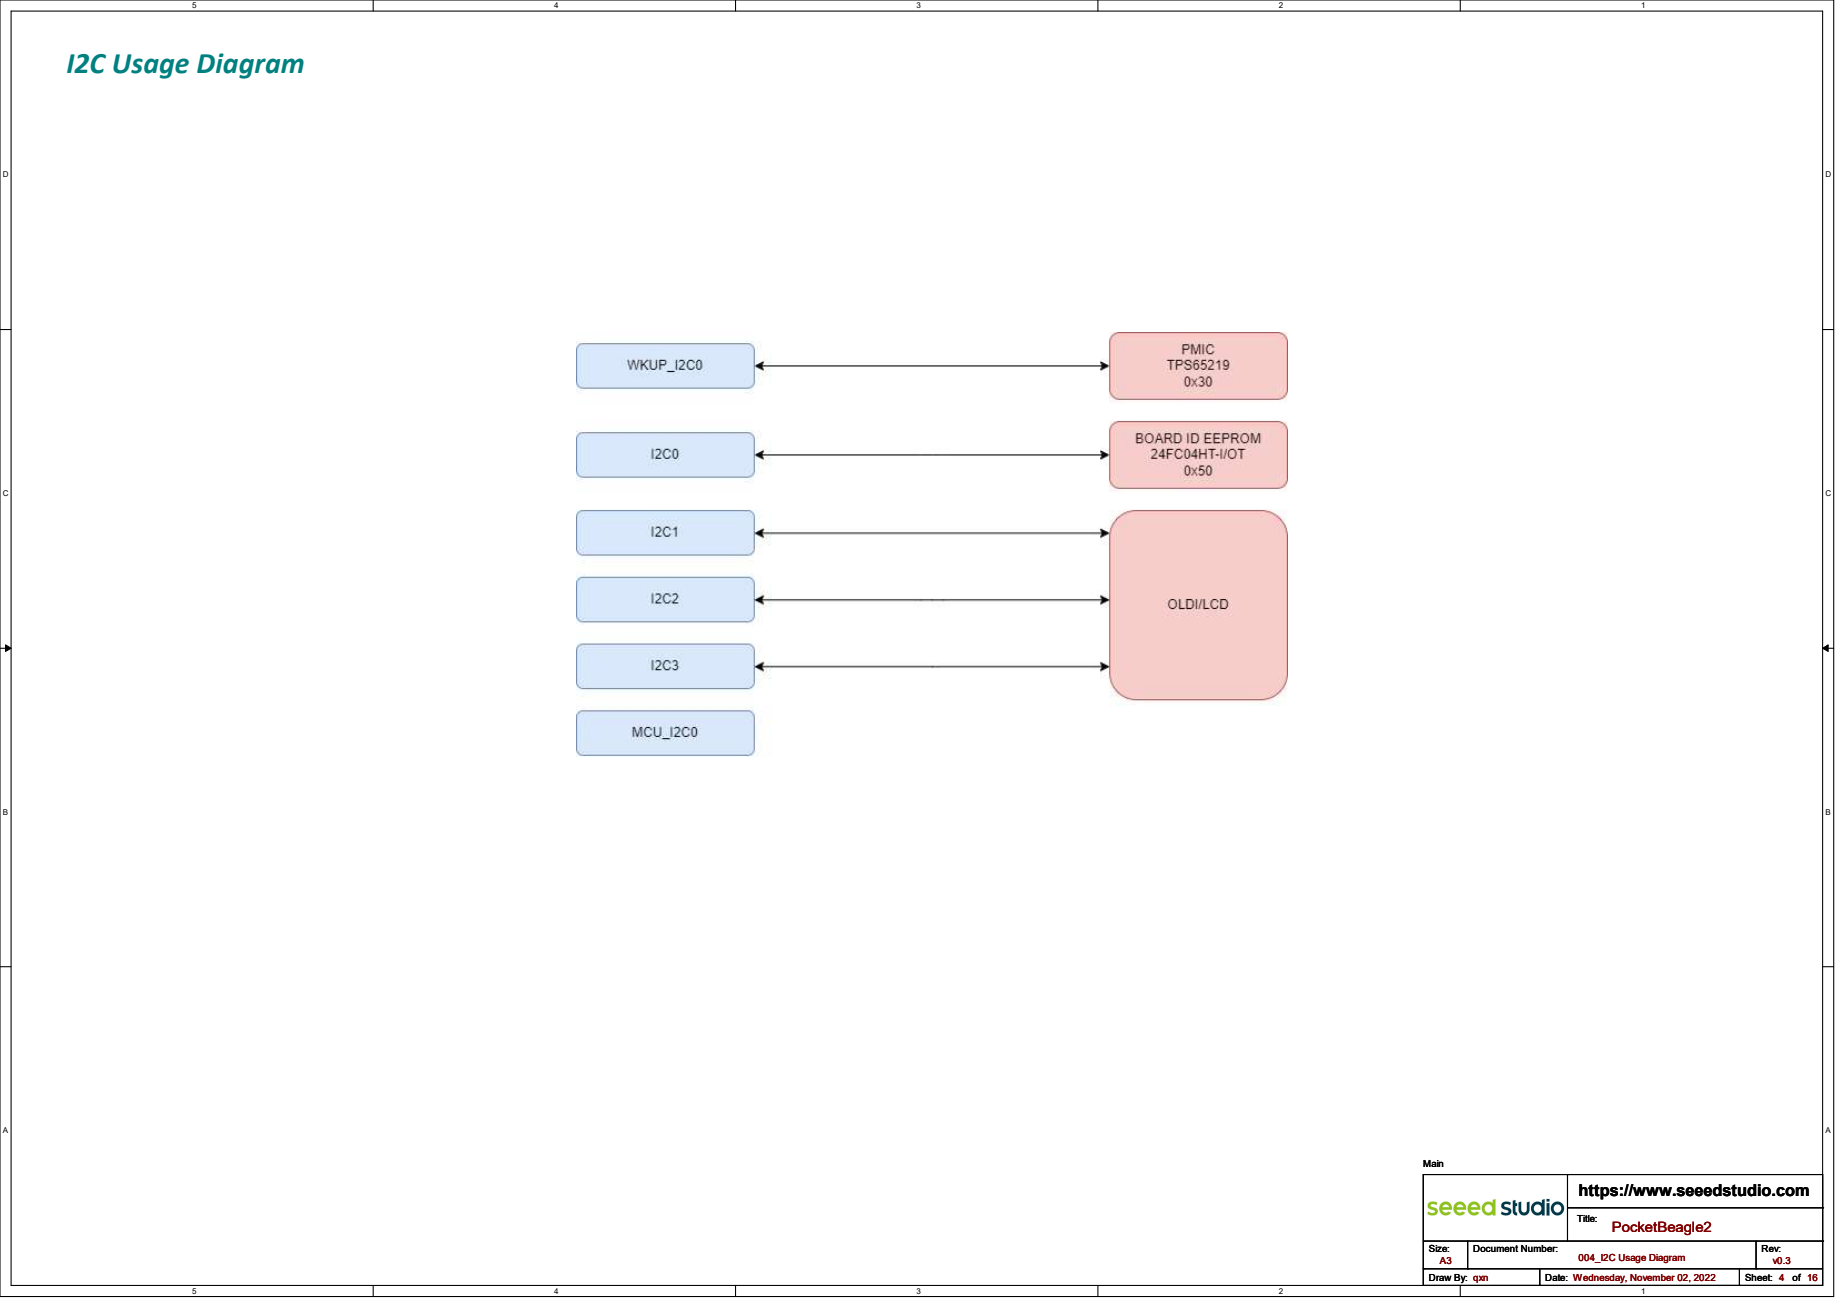
[picture p96: page 4]
https://www.seeedstudio.com A3; qxn; Wednesday, November 02, 2022; 16 PocketBeagle2; 004_I2C Usage Diagram; Main; Title: Size:; Document Number:; Rev: Draw By:; Date:; Sheet:

Power Path | Battery Charger

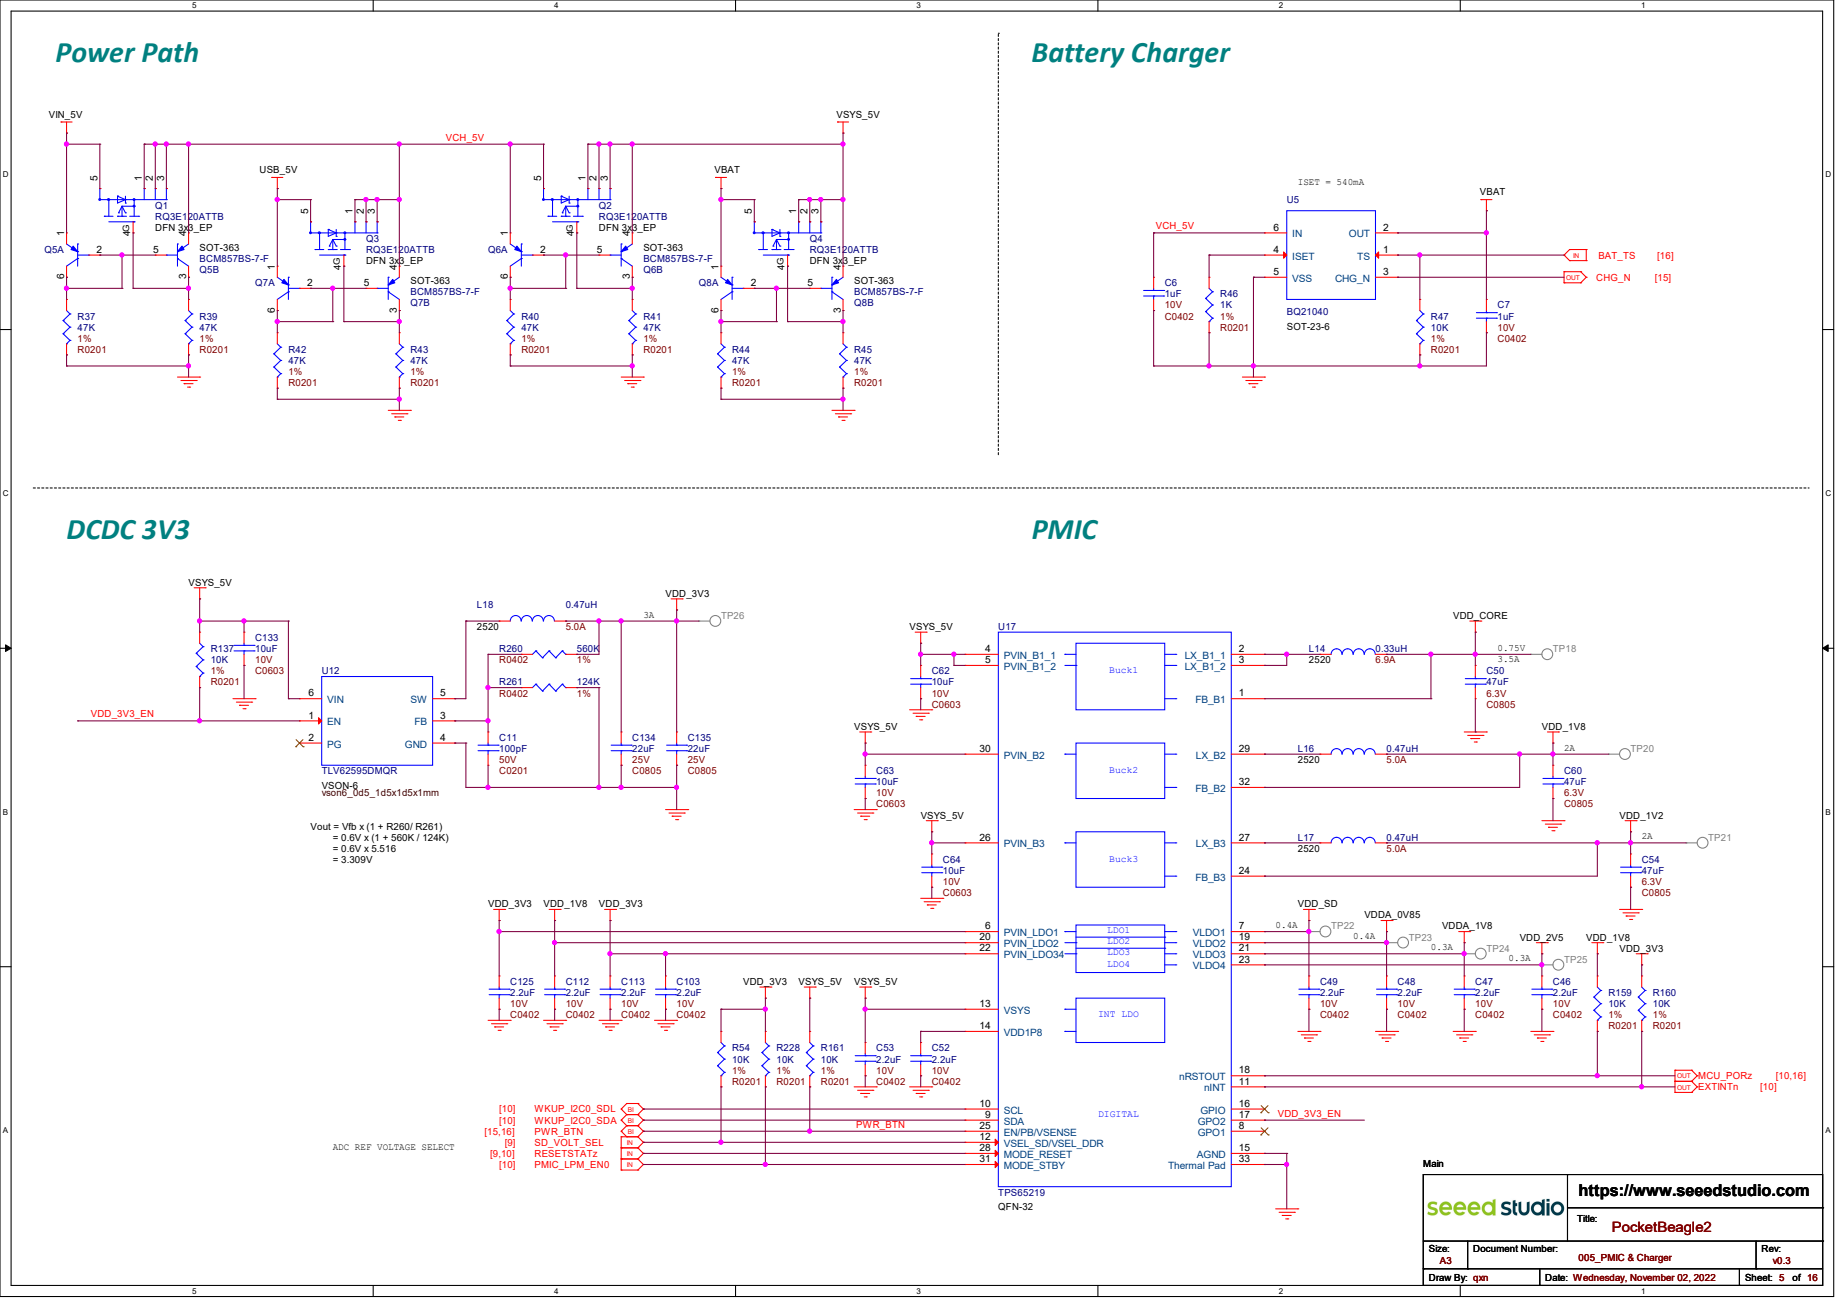
[picture p97: page 5]

# SoC Power

# ANALOG AND DIGITAL U1Q

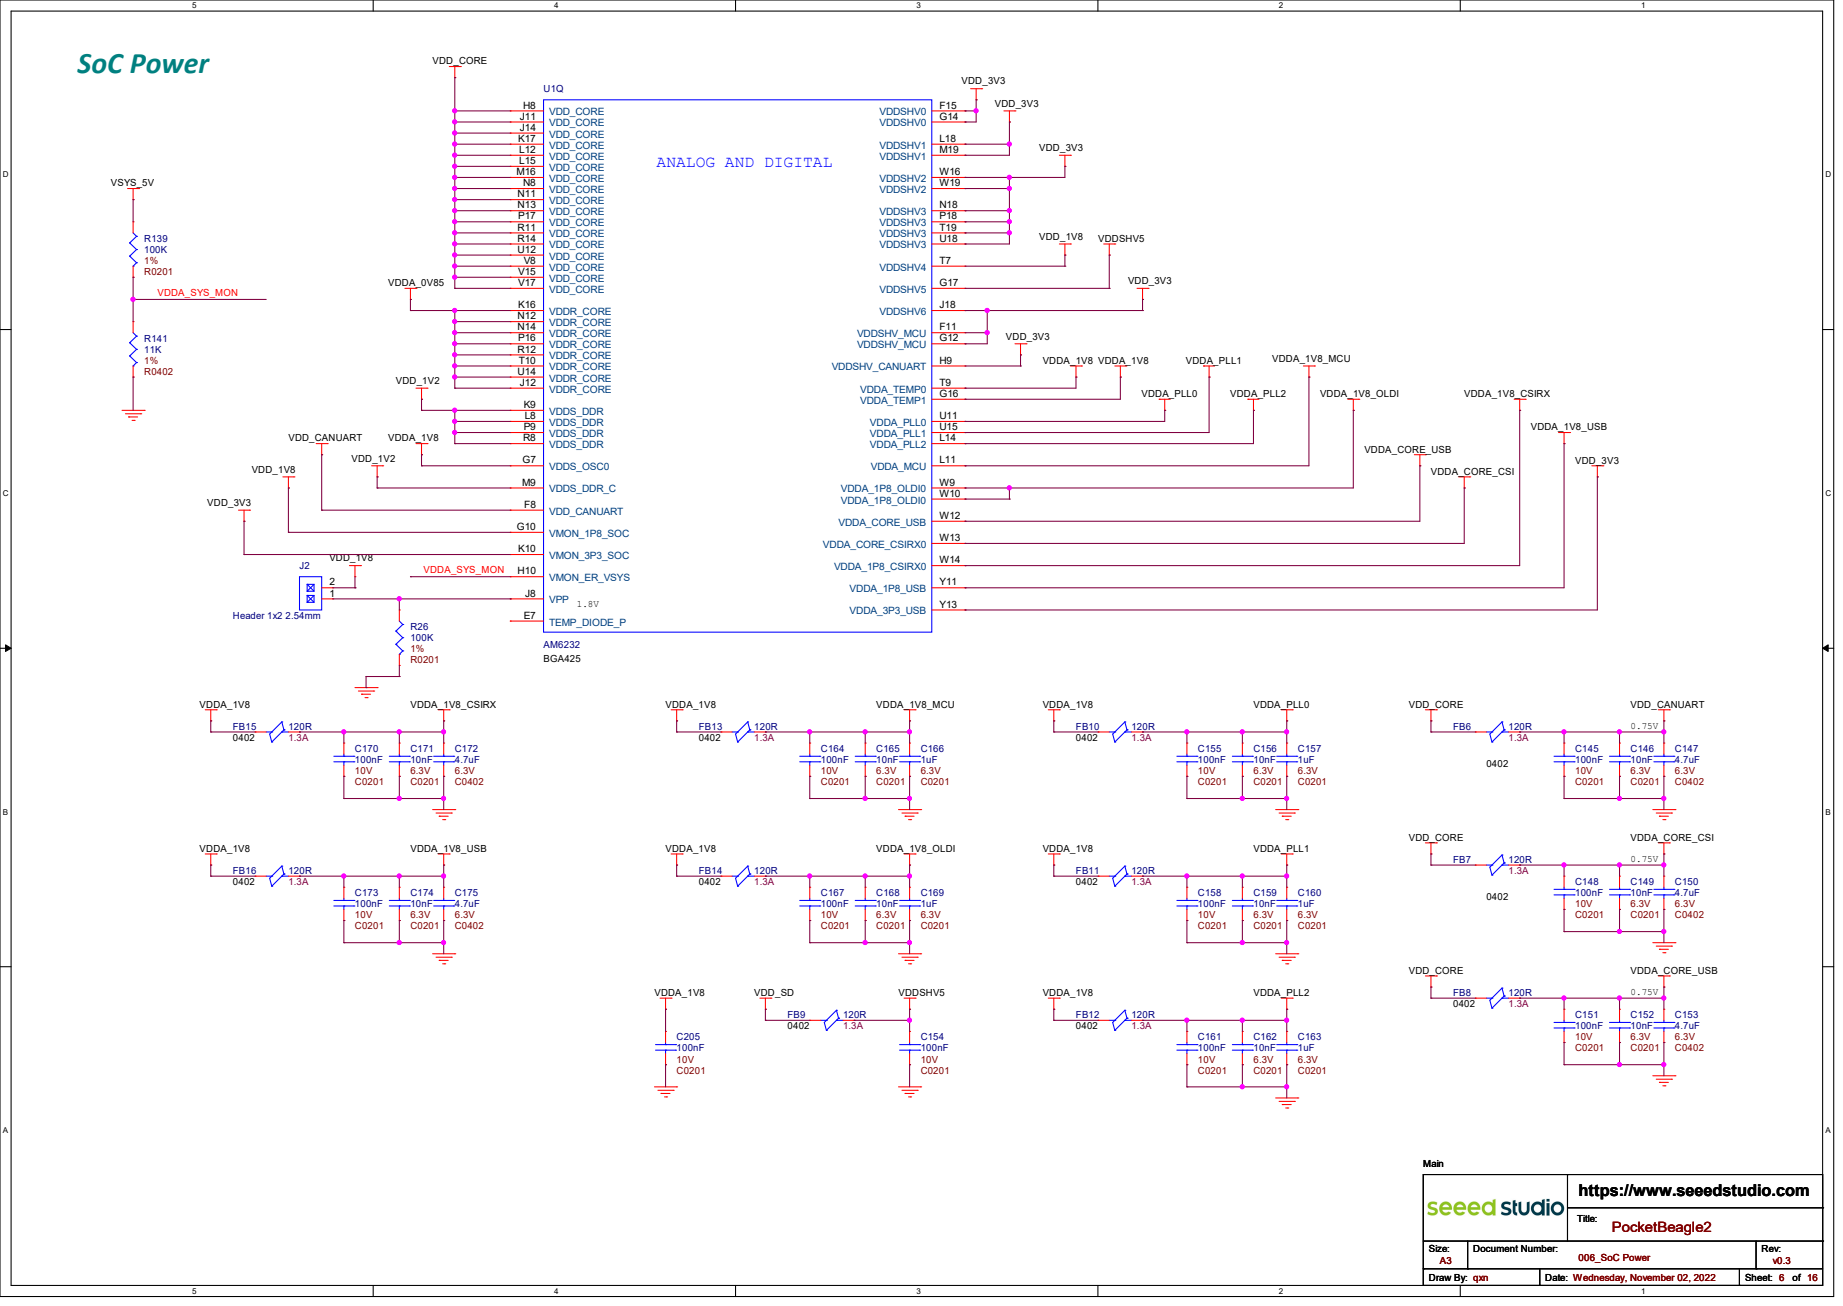
[picture p98: page 6]

# SoC DCAPs 0.75V

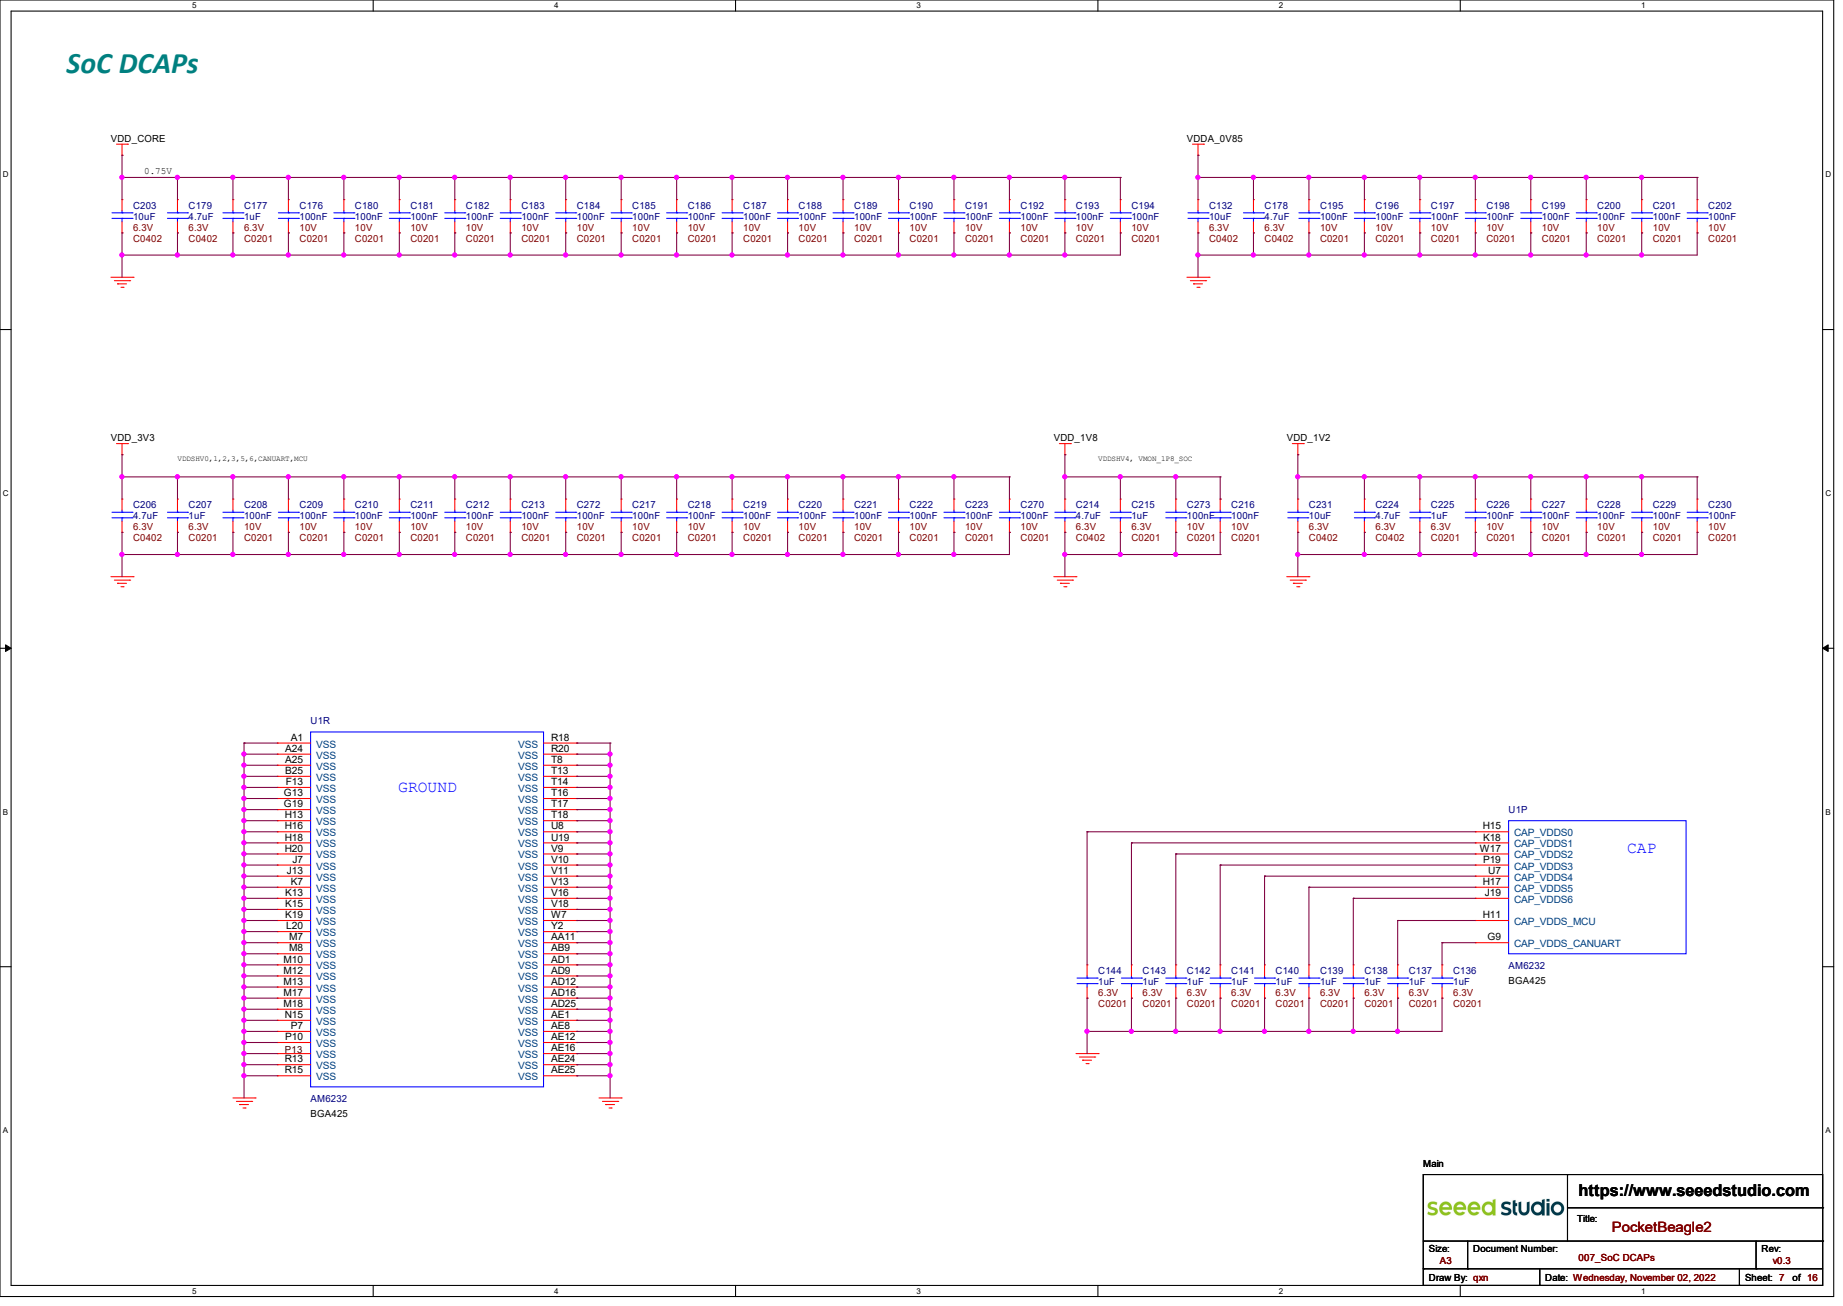
[picture p99: page 7]

VSS R18 VSS R20 VSS T8 VSS T13 VSS T14 VSS T16 VSS T17 VSS T18 VSS U8 VSS U19 VSS V9 VSS V10 VSS V11 VSS V13 VSS V16 VSS V18 VSS W7 VSS Y2 VSS AA11 VSS AB9 VSS AD1 VSS AD9 VSS AD12 VSS AD16 VSS AD25 VSS AE1 VSS AE8 VSS AE12 VSS AE16 VSS AE24 VSS AE25

# DDR4

DDR0_DQ0 F4 DDR0_DQ1 G5 DDR0_DQ2 F3 DDR0_DQ3 H6 DDR0_DQ4 E3 DDR0_DQ5 G2 DDR0_DQ6 F2 DDR0_DQ7 F1 DDR0_DQ8 U1 DDR0_DQ9 U3 DDR0_DQ10 U2 DDR0_DQ11 V5 DDR0_DQ12 W2 DDR0_DQ13 V6 DDR0_DQ14 Y1 DDR0_DQ15 W1 DDR0_ODT0 H1 DDR0_CKE0 H2

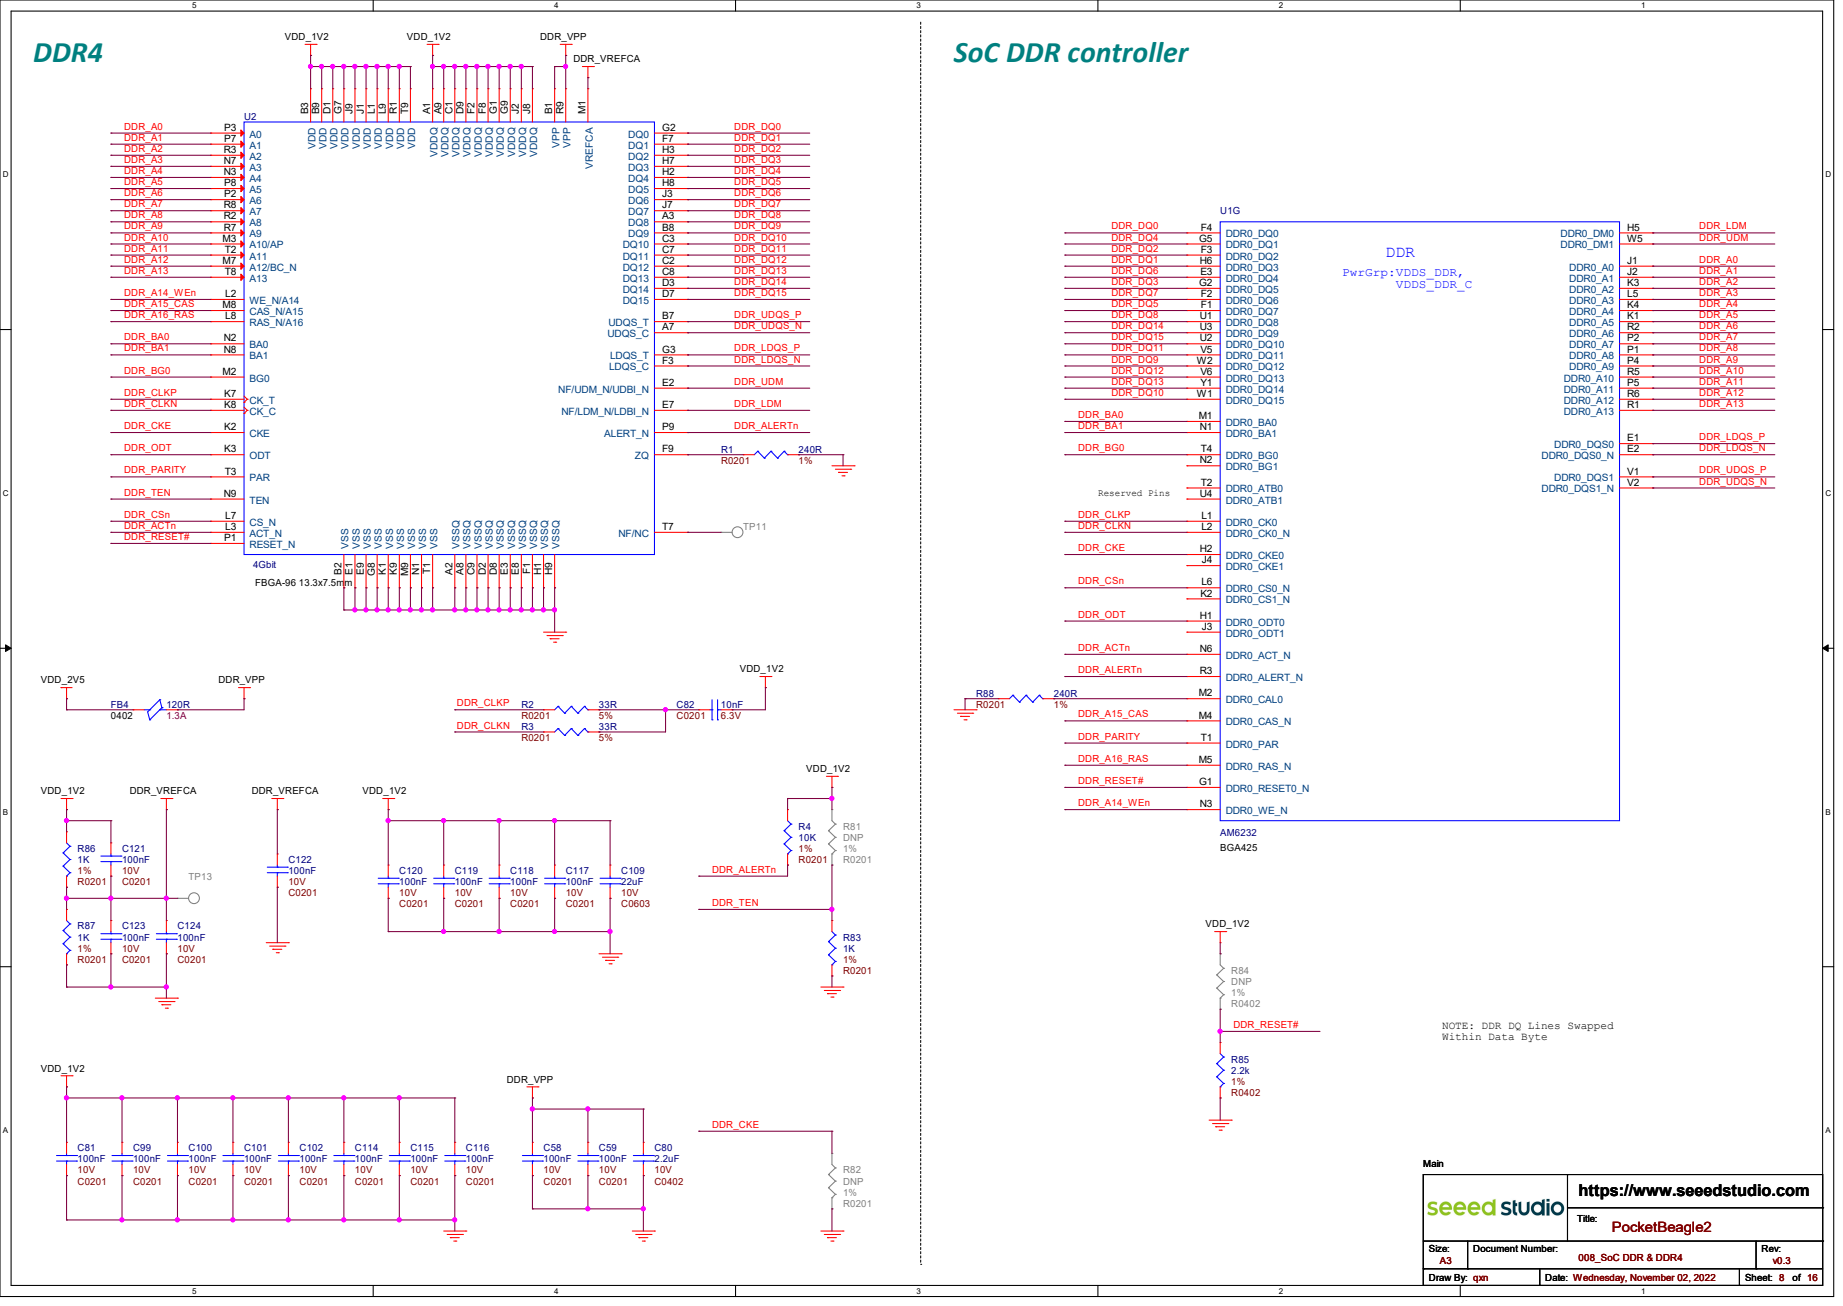
[picture p100: page 8]

NOTE: DDR DQ Lines Swapped
Within Data Byte

# eMMC

# SoC MMC & eMMC

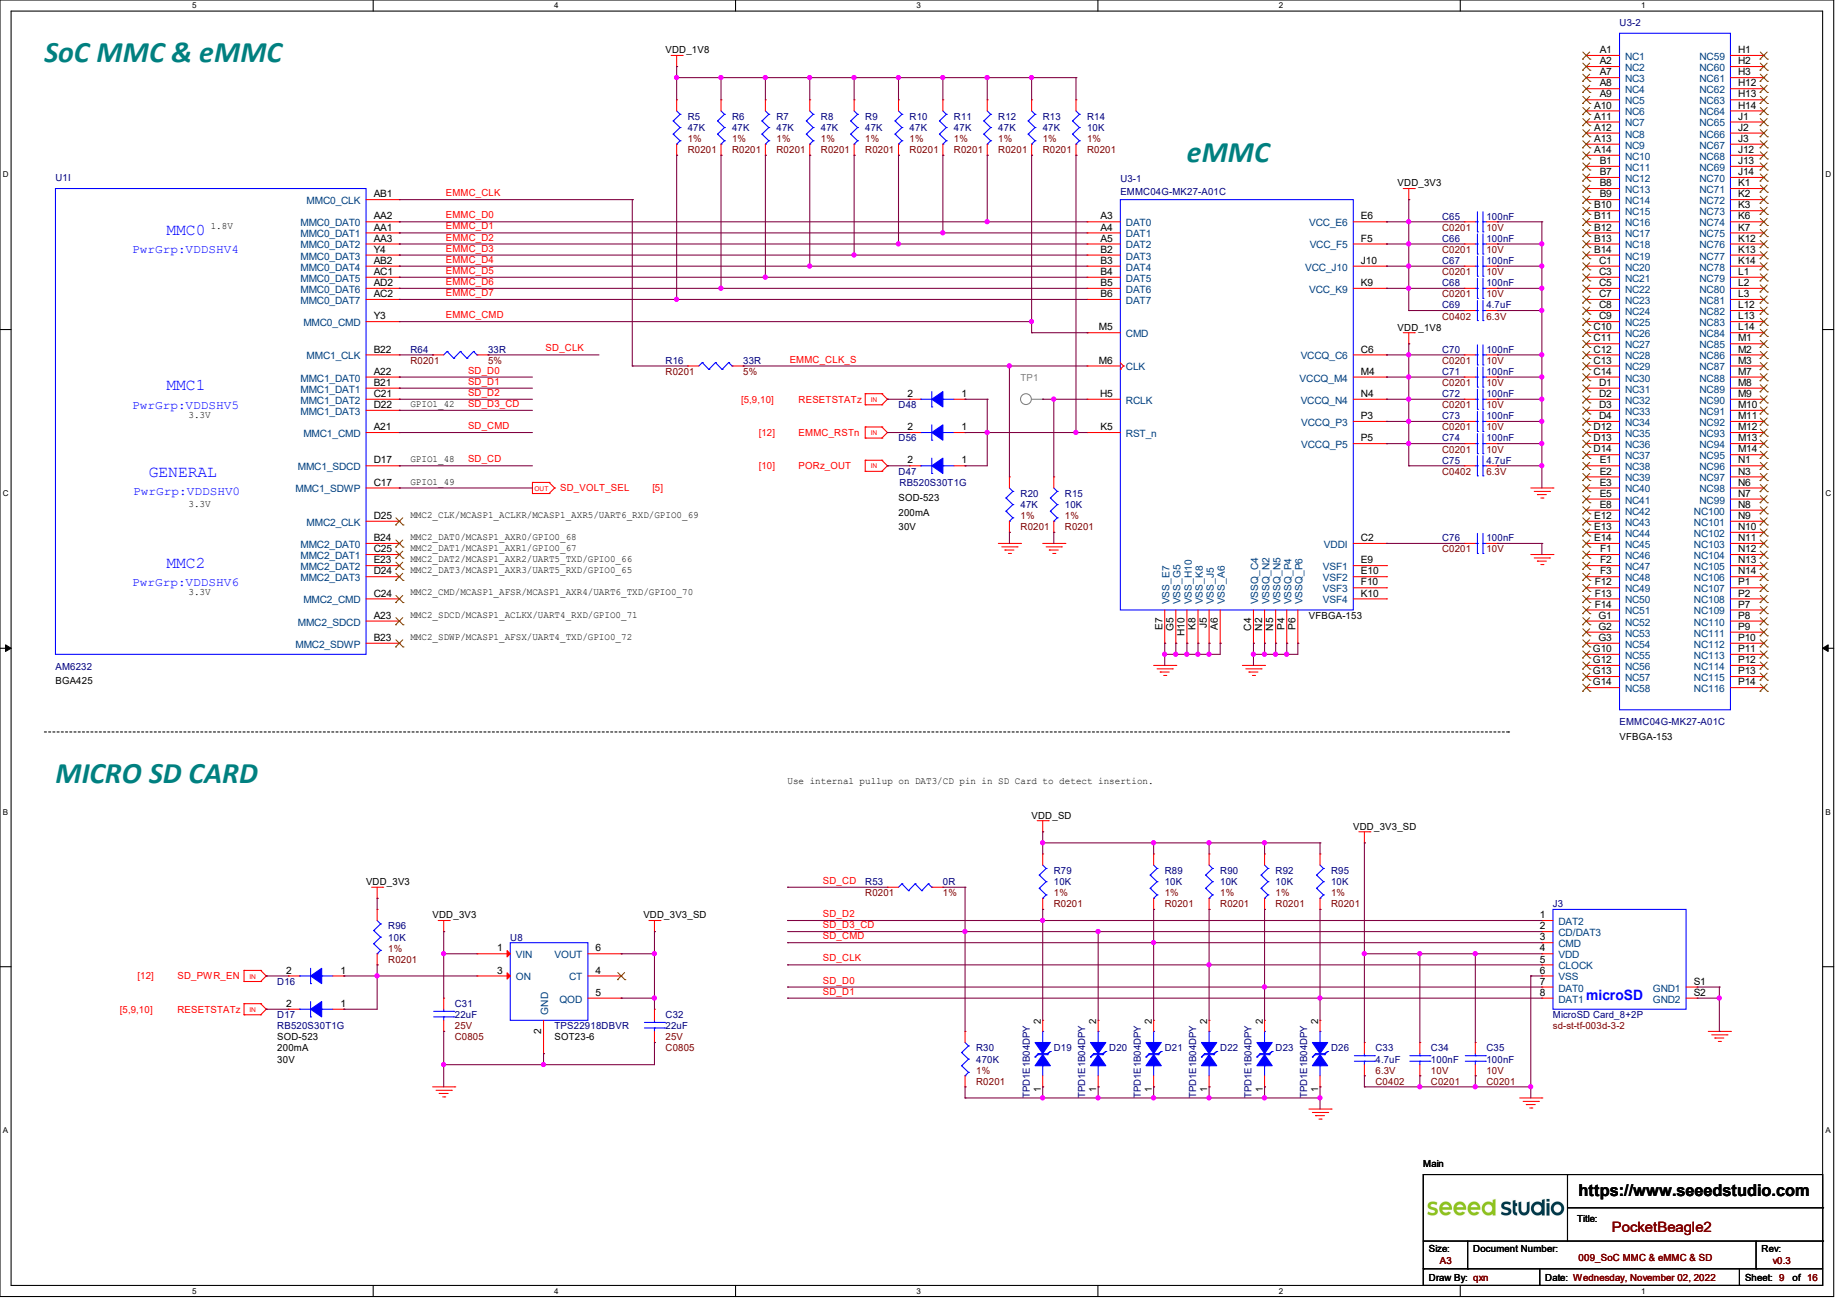
[picture p101: page 9]

Use internal pullup on DAT3/CD pin in SD Card to detect insertion.

2 ON 3 CT 4 QOD 5 VOUT 6

009_SoC MMC & eMMC & SD Main

# SoC System 1.8V

# OSC0

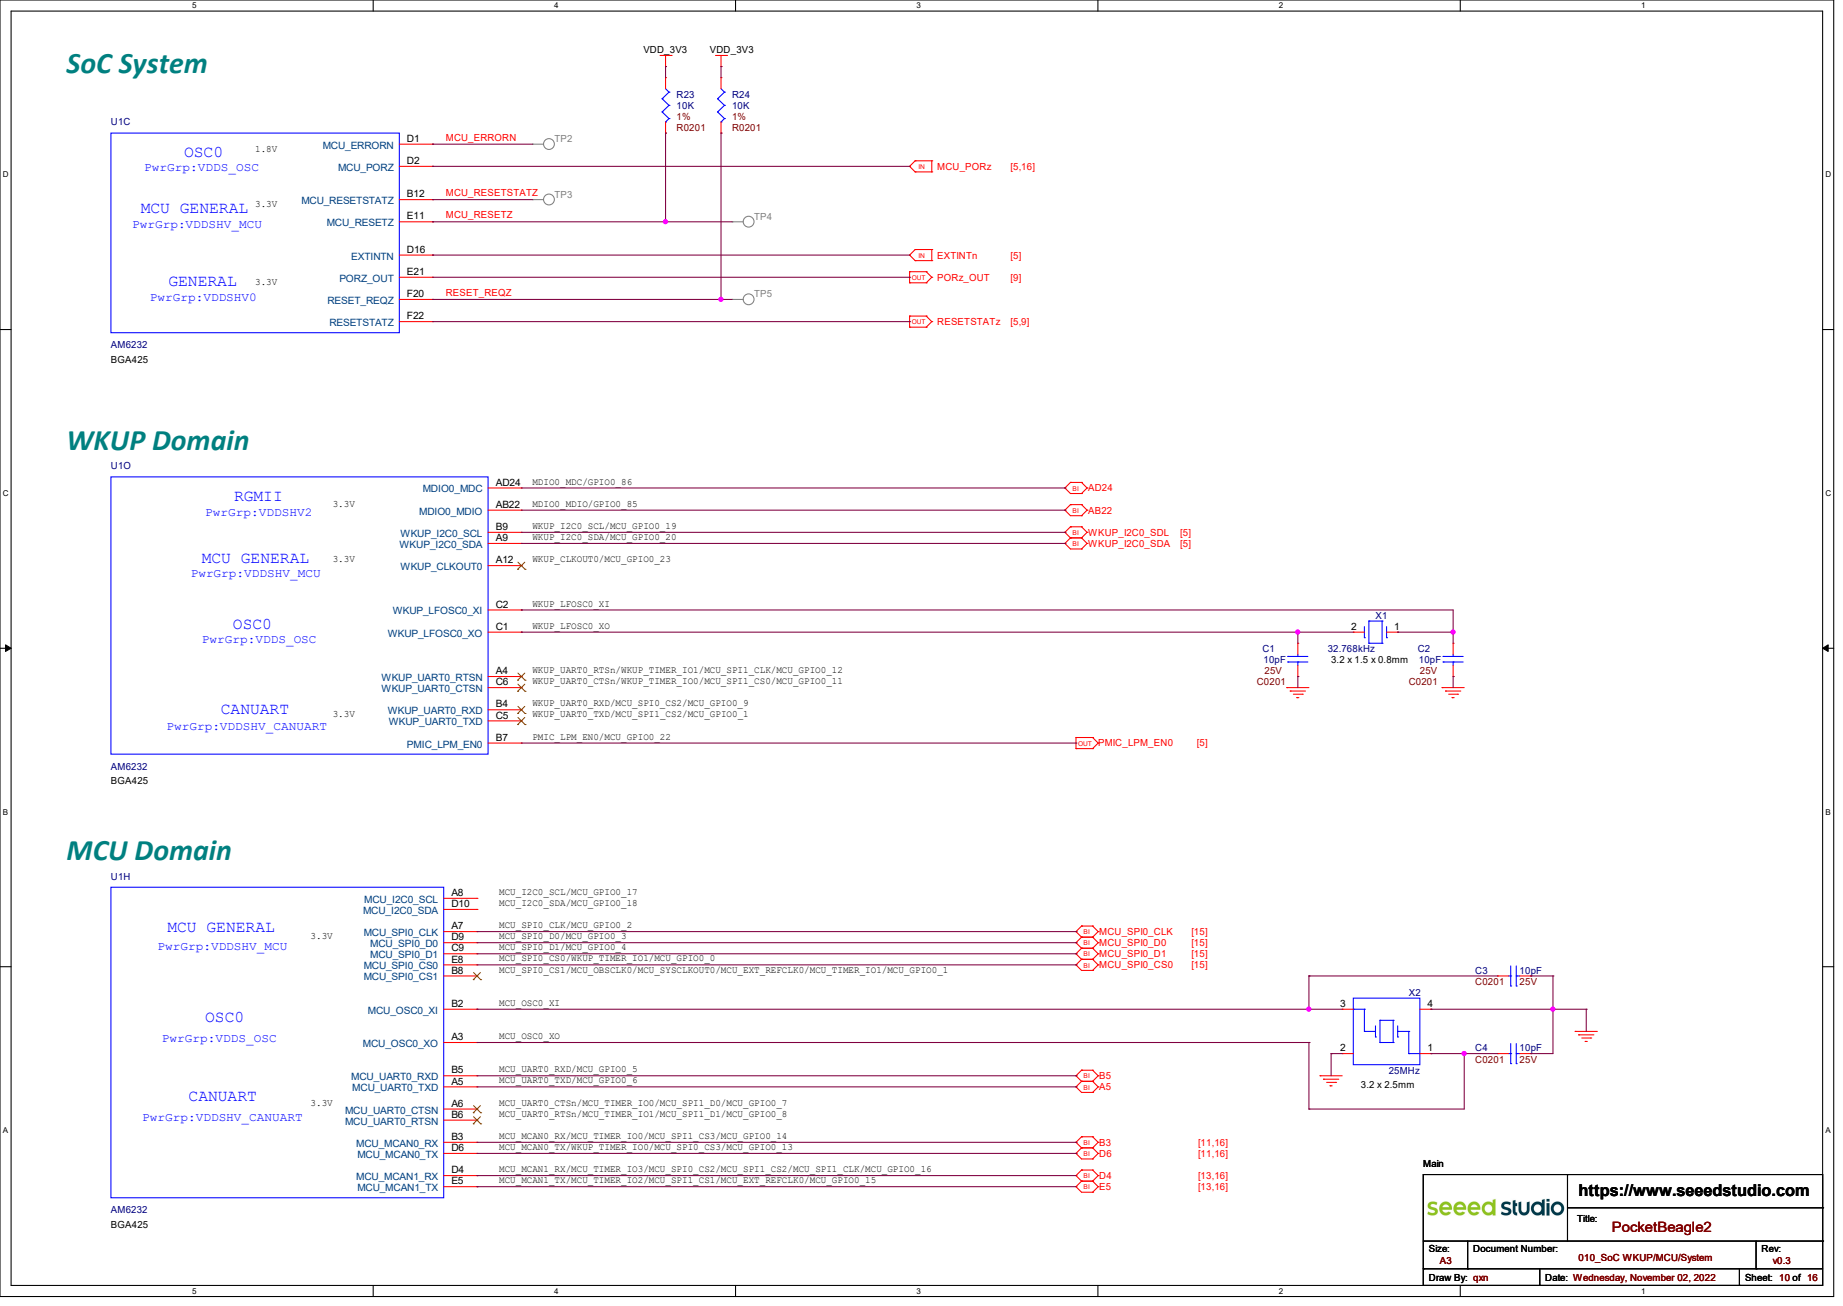
[picture p102: page 10]

# SoC GPIO 1.8V 3.3V

# GPMC U1F

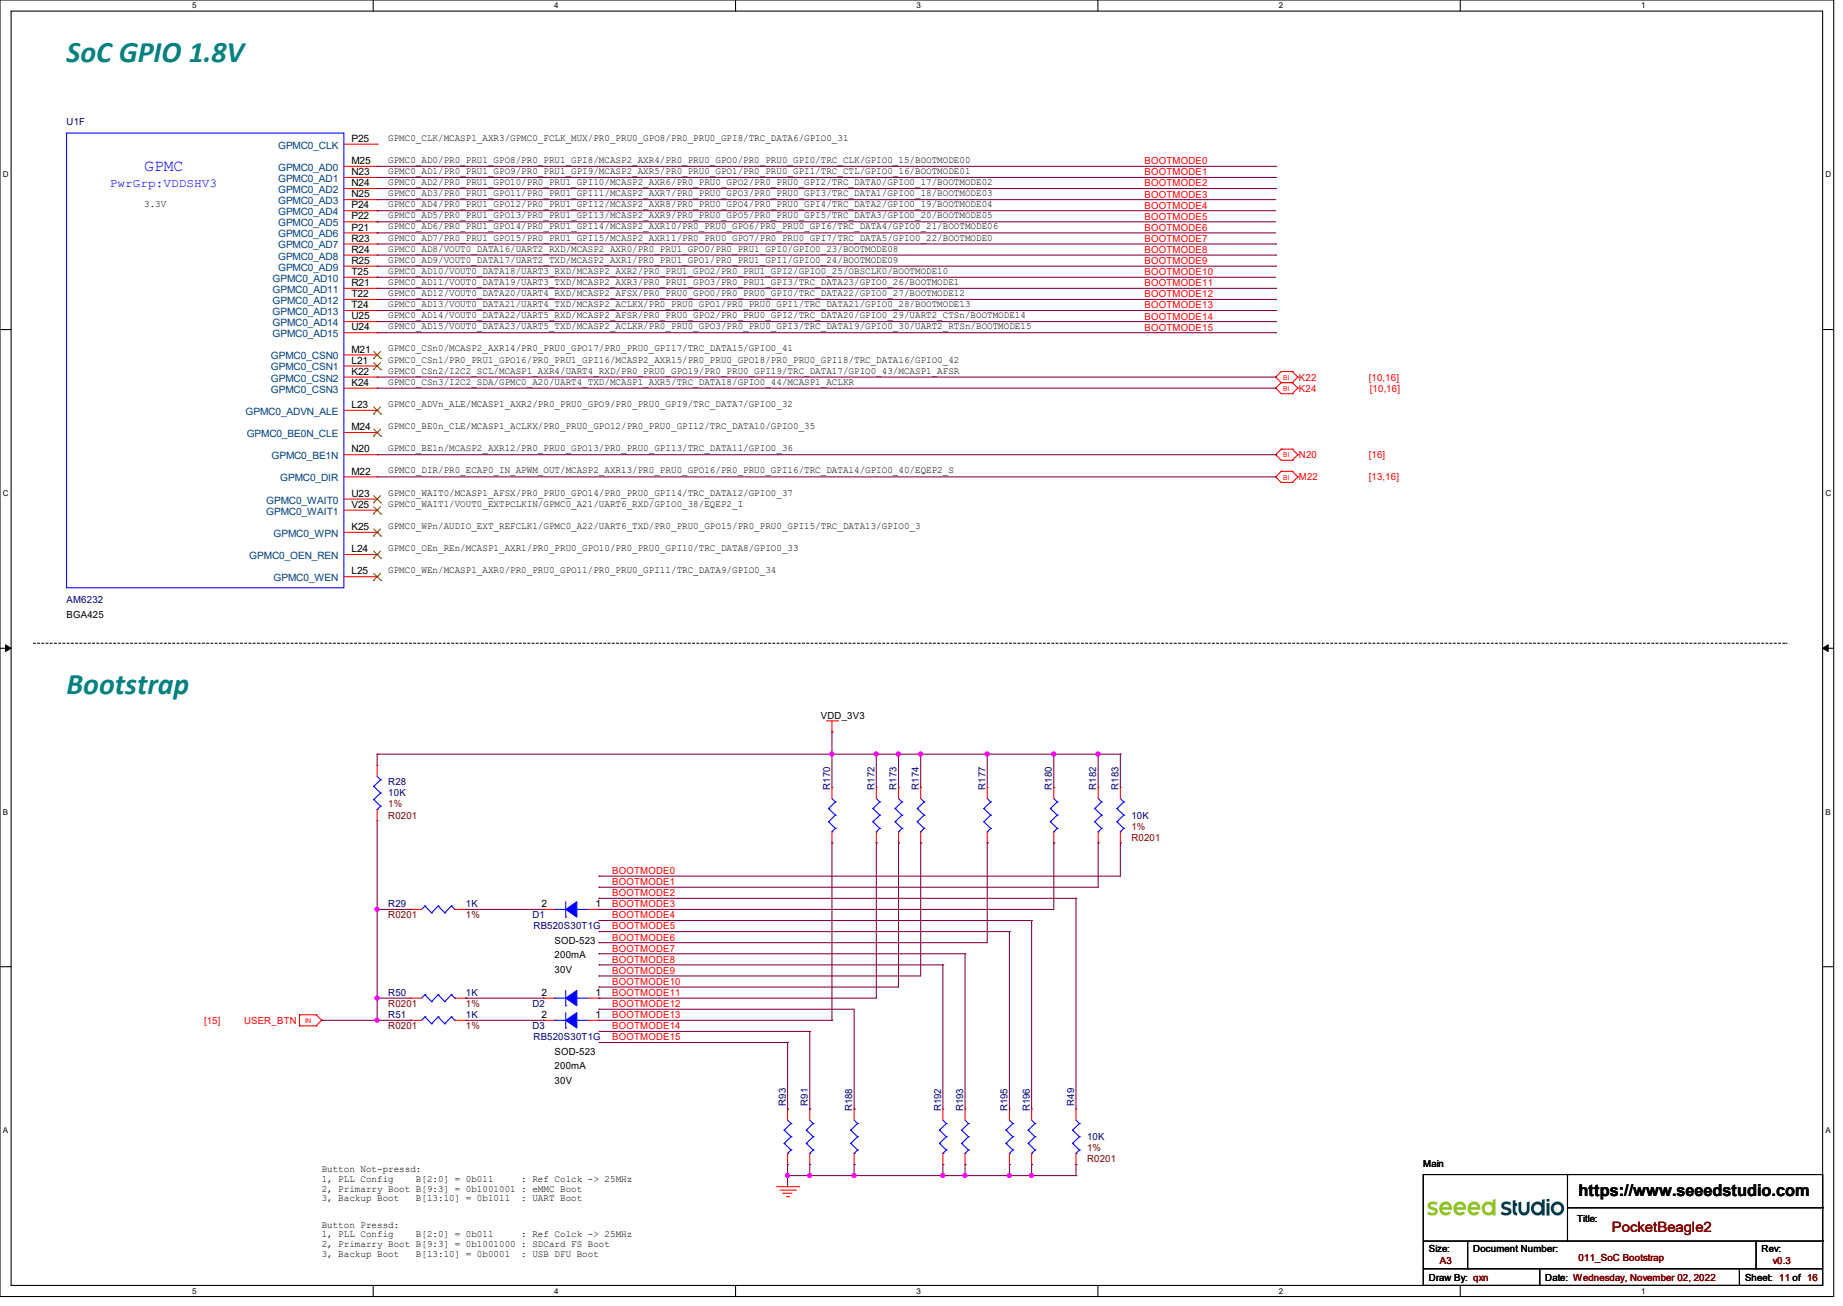
[picture p103: page 11]

Button Not-pressd:
2, Primarry Boot B[9:3] = 0b1001001 : eMMC Boot

Button Pressd:
2, Primarry Boot B[9:3] = 0b1001000 : SDCard FS Boot

# RGMII

# RGMII1

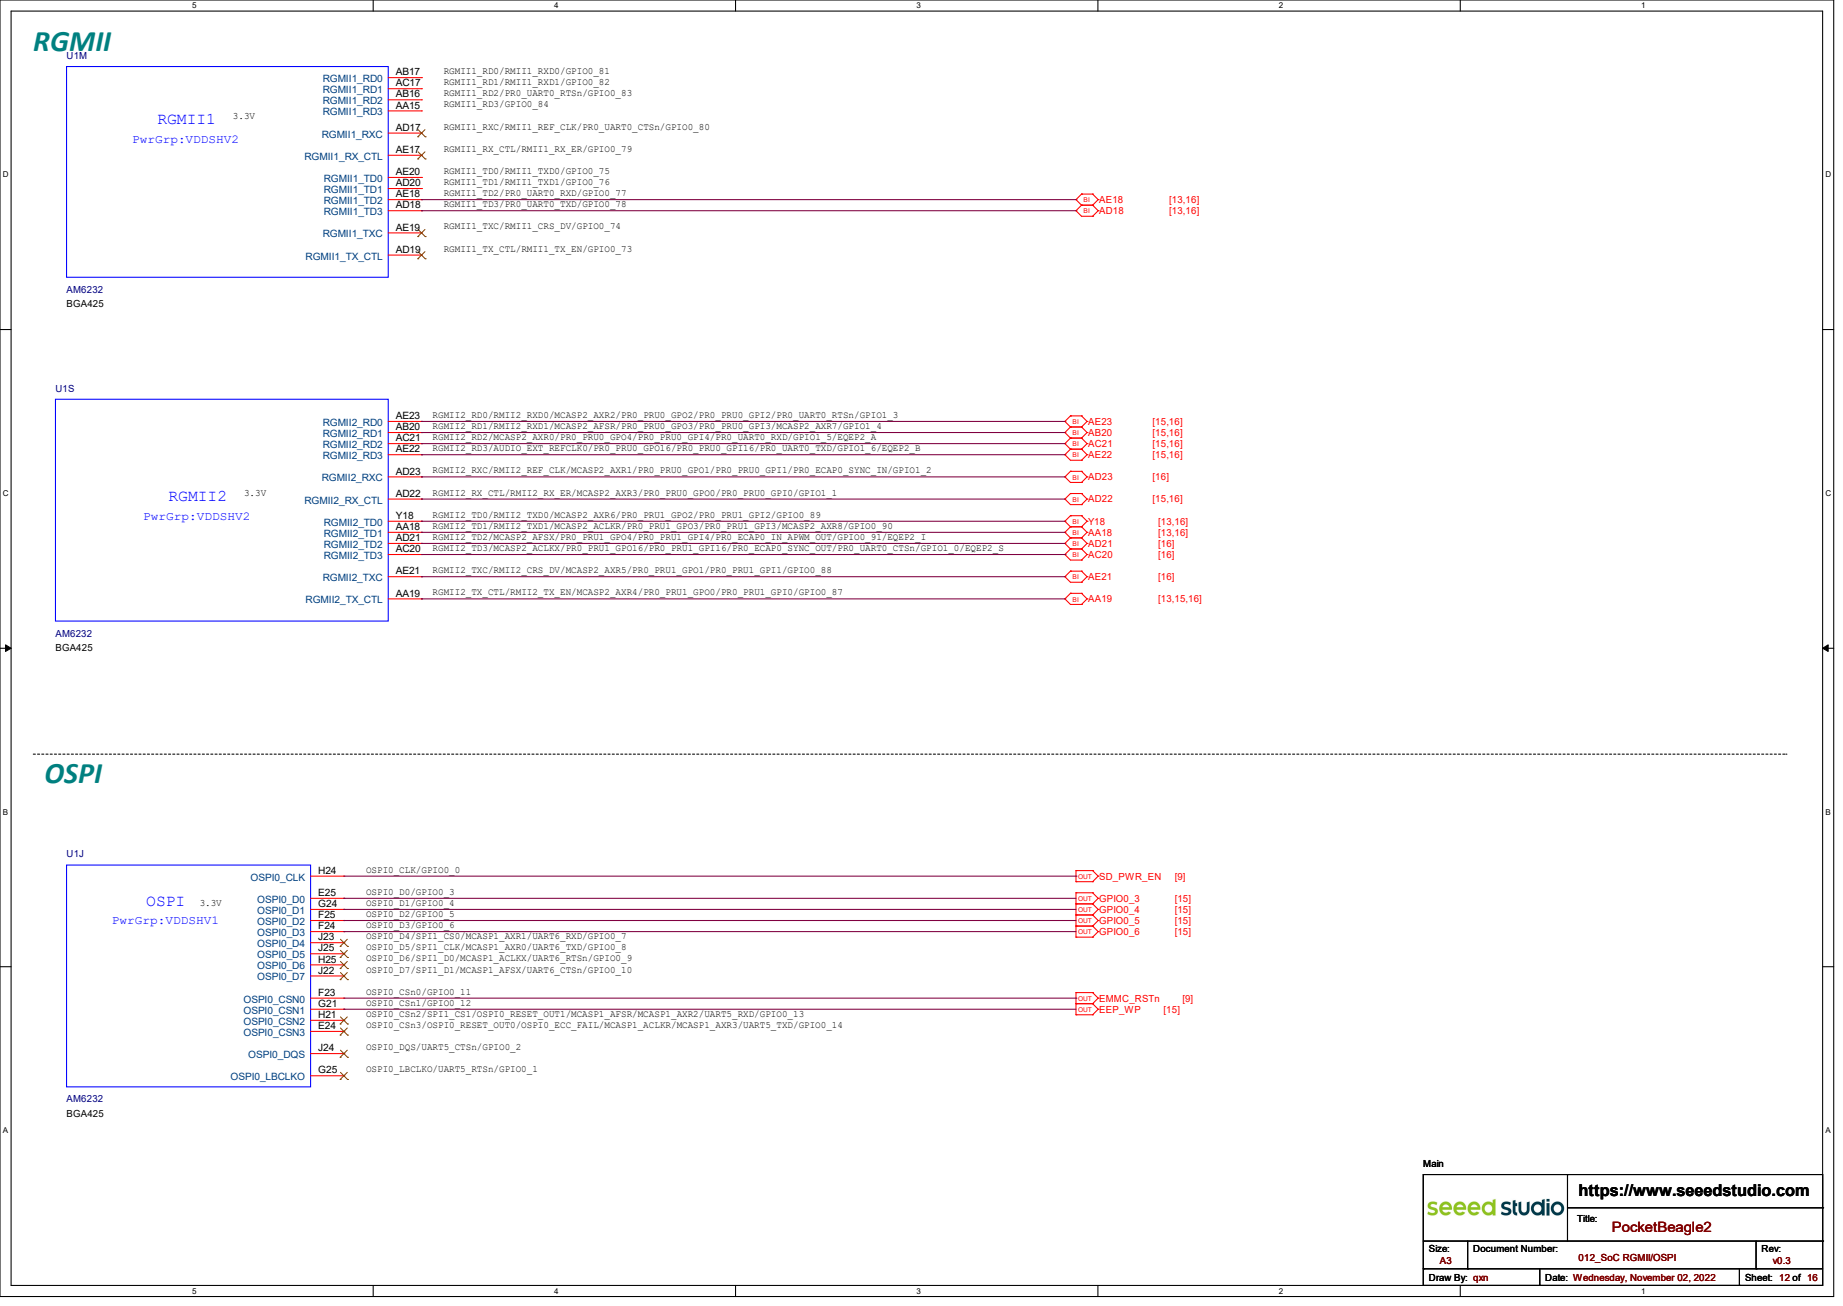
[picture p104: page 12]
A A OSPI0_DQS/UART5_CTSn/GPIO0_2; OSPI0_CSn3/OSPI0_RESET_OUT0/OSPI0_ECC_FAIL/MCASP1_ACLKR/MCASP1_AXR3/UART5_TXD/GPIO0_14; OSPI0_D0/GPIO0_3; OSPI0_CSn1/GPIO0_12; OSPI0_CLK/GPIO0_0; OSPI0_CSn2/SPI1_CS1/OSPI0_RESET_OUT1/MCASP1_AFSR/MCASP1_AXR2/UART5_RXD/GPIO0_13; OSPI0_D2/GPIO0_5 OSPI0_D3/GPIO0_6 OSPI0_D4/SPI1_CS0/MCASP1_AXR1/UART6_RXD/GPIO0_7; OSPI0_D1/GPIO0_4; OSPI0_D7/SPI1_D1/MCASP1_AFSX/UART6_CTSn/GPIO0_10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

012_SoC RGMII/OSPI Main

# SoC GPIO

# GENERAL

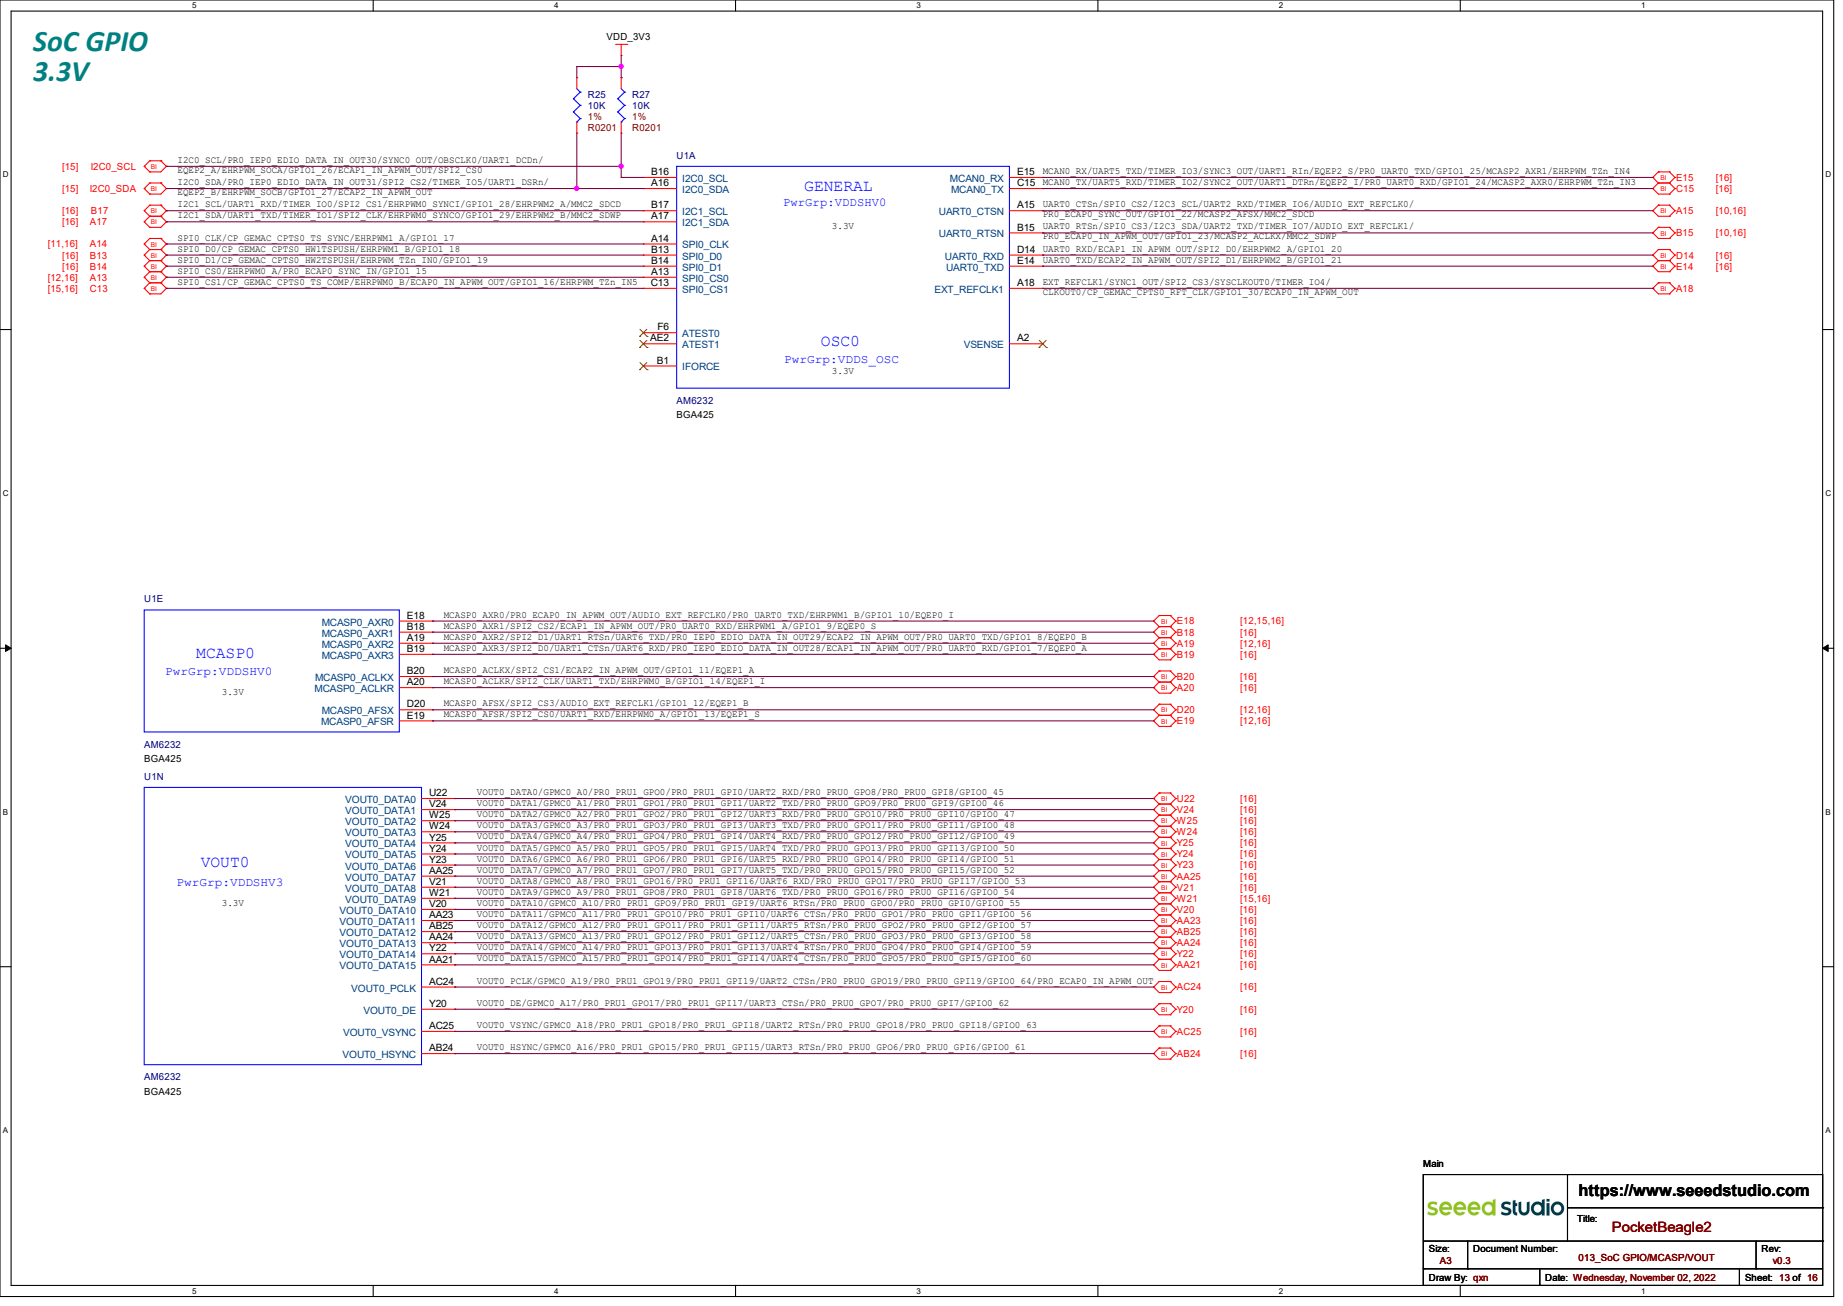
[picture p105: page 13]

013_SoC GPIO/MCASP/VOUT Main

# USB_A & USB_C

# USB0

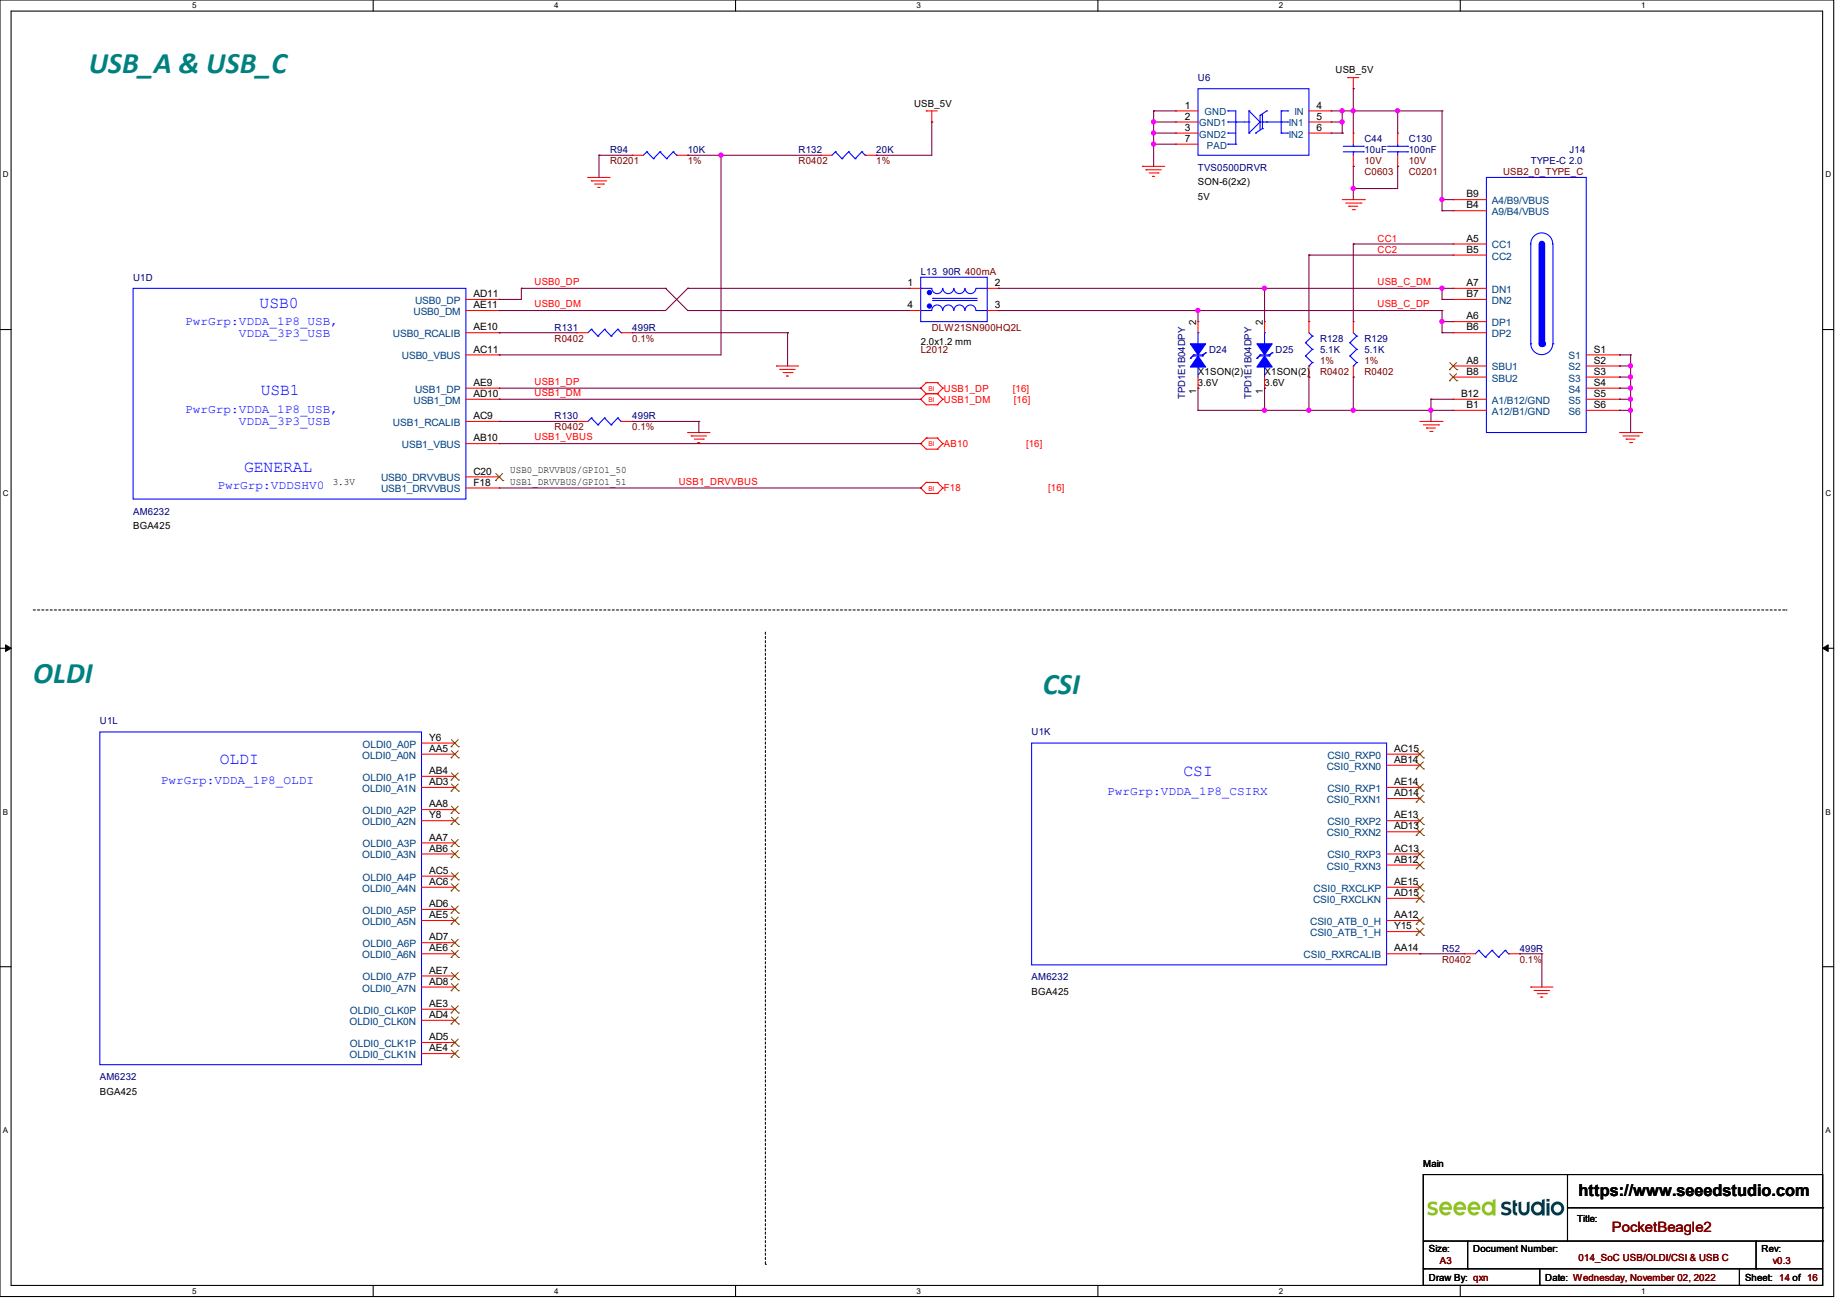
[picture p106: page 14]

014_SoC USB/OLDI/CSI & USB C Main

JTAG | 3.3V

# MCU GENERAL

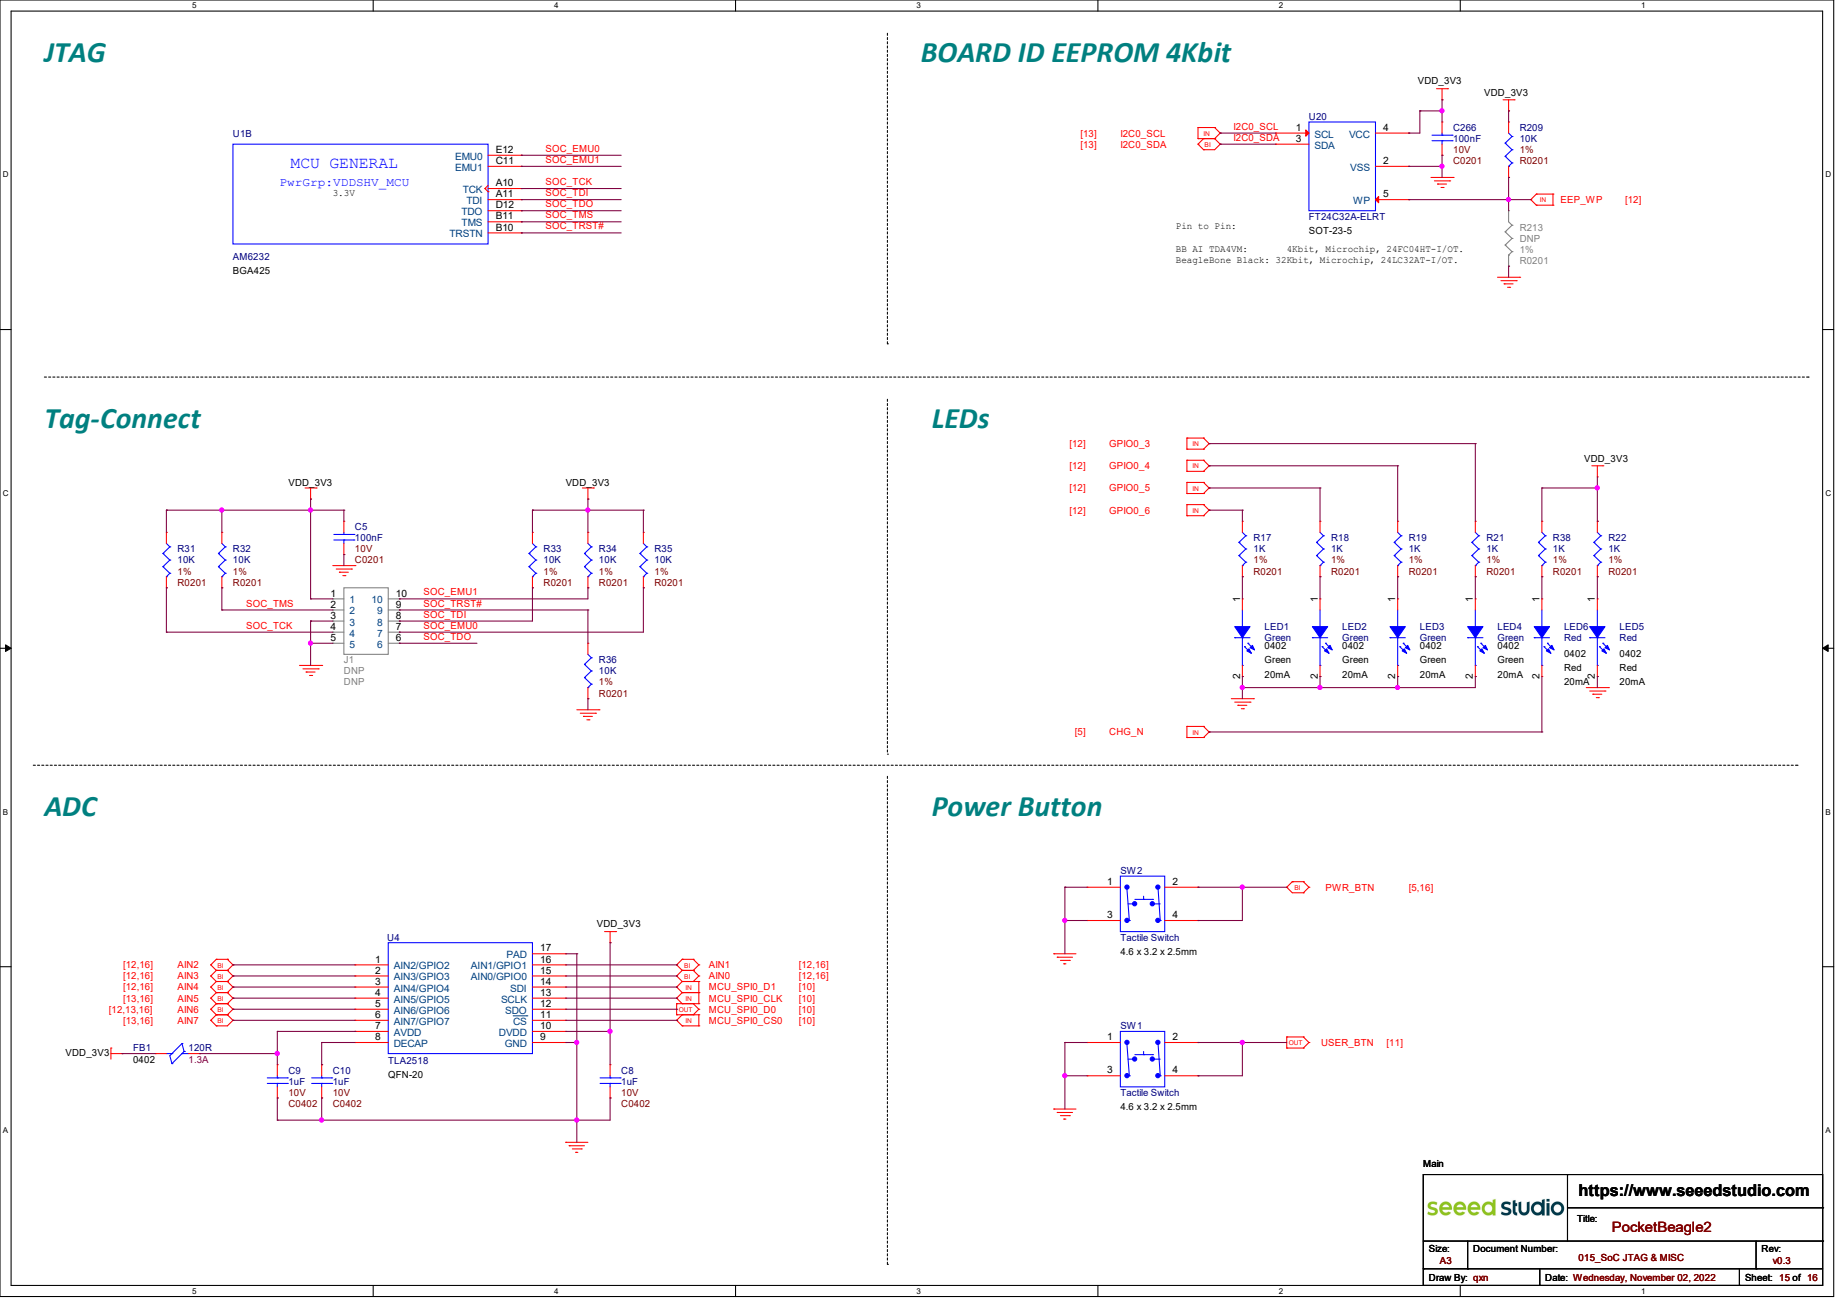
[picture p107: page 15]

BOARD ID EEPROM 4Kbit BeagleBone Black: 32Kbit, Microchip, 24LC32AT-I/OT.

[14] | USB1_DP BI [14] | USB1_DM BI [14] | AB10 BI [14] | F18 | BI [11] | N20 | BI [12,15] | AIN0 | BI [12,15] | AD22 | BI [12,15] | AIN1 | BI [12,15] | AE22 | BI [12,15] | AIN2 | BI [12,15] | AC21 | BI [12,15] | AIN3 | BI [12,15] | AIN4 | BI [12,15] | AE23 | BI [12,15] | AB20 | BI [13] | Y20 | BI [13] | Y22 | BI [13] | AA23 | BI [12] | AE21 | BI

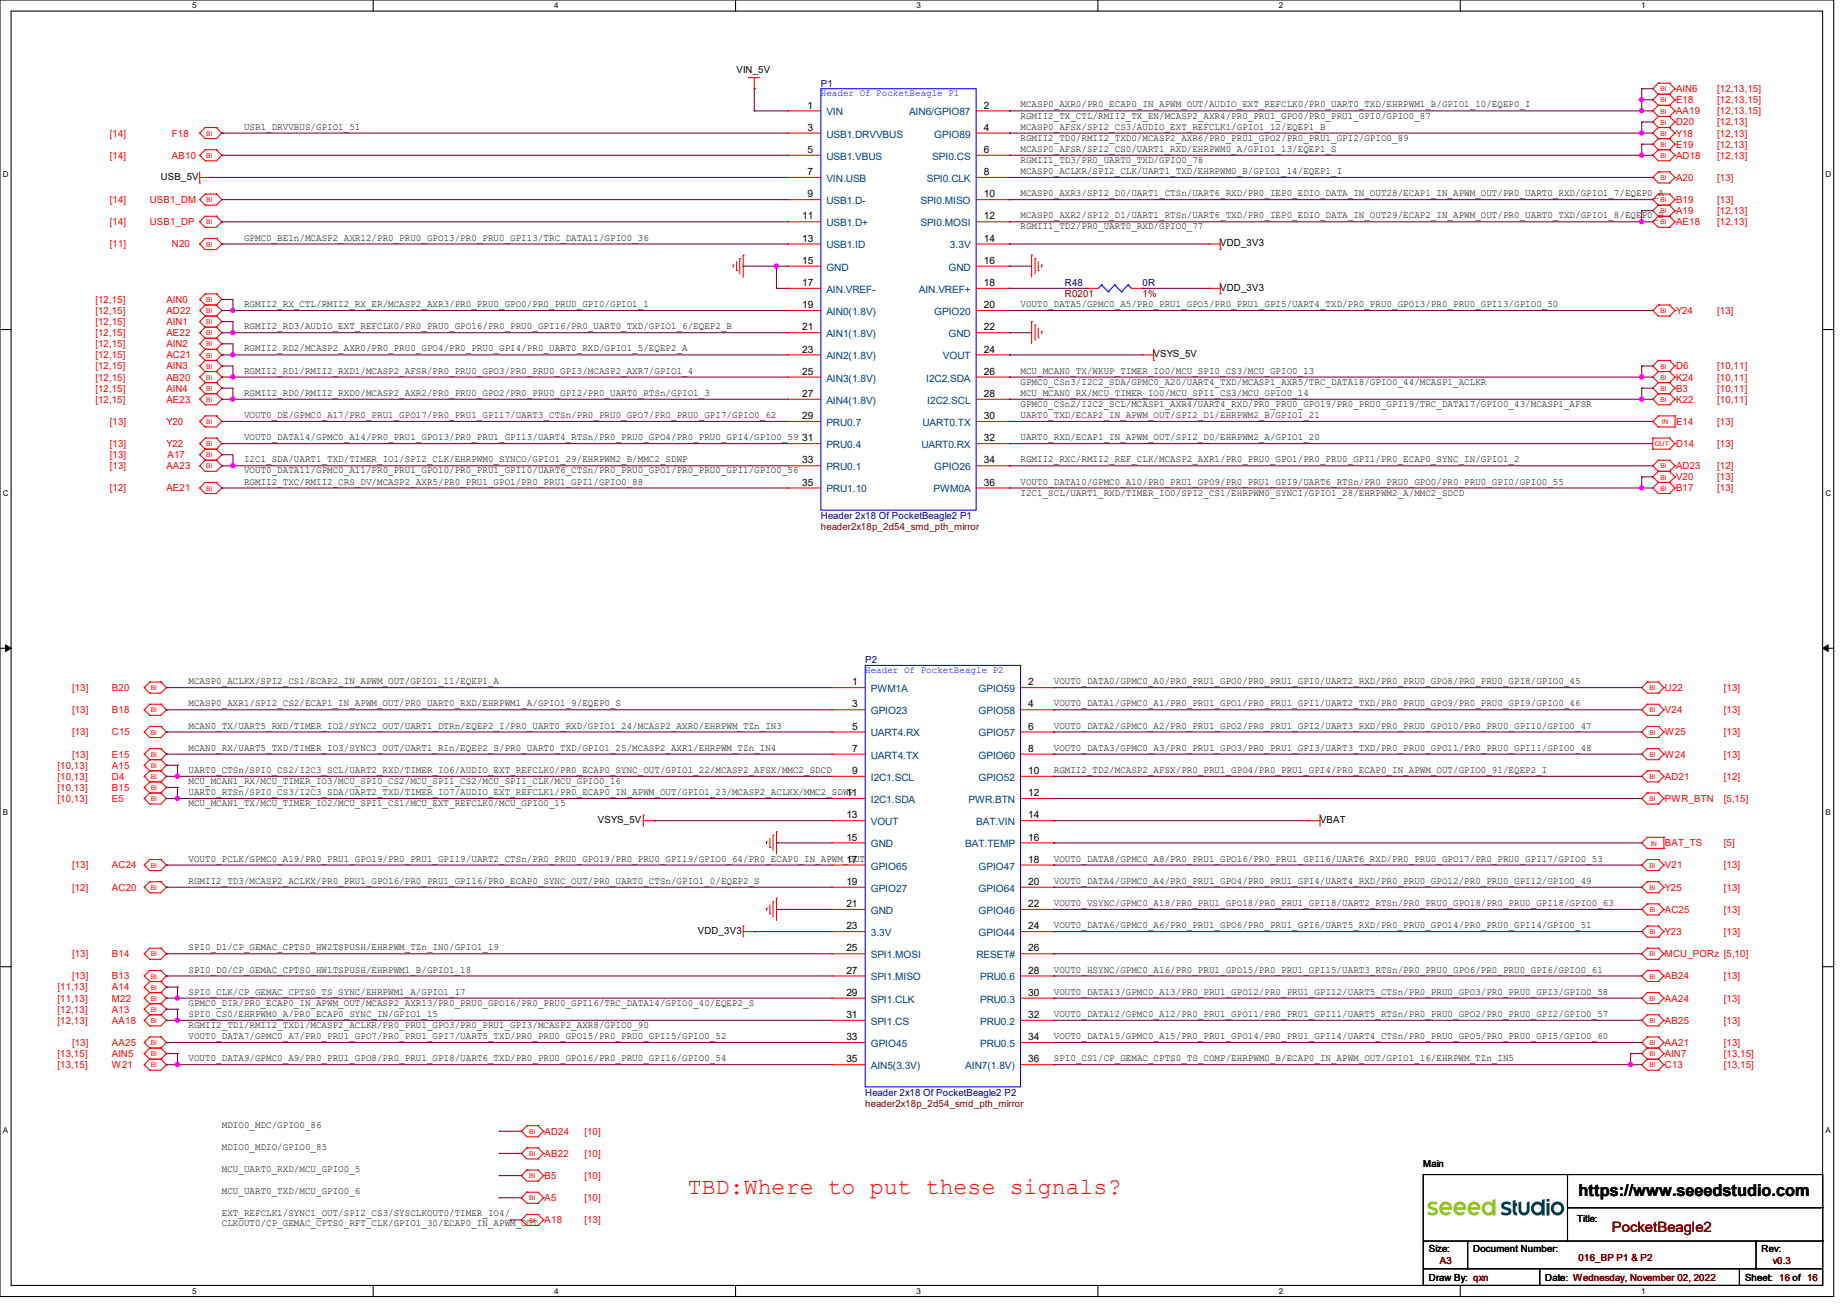
[picture p108: page 16]

TBD:Where to put these signals?
