beagleboard/pocketbeagle-2/design/old/pocketbeagle2 v03 layout.pdf

# Assembly_TOP

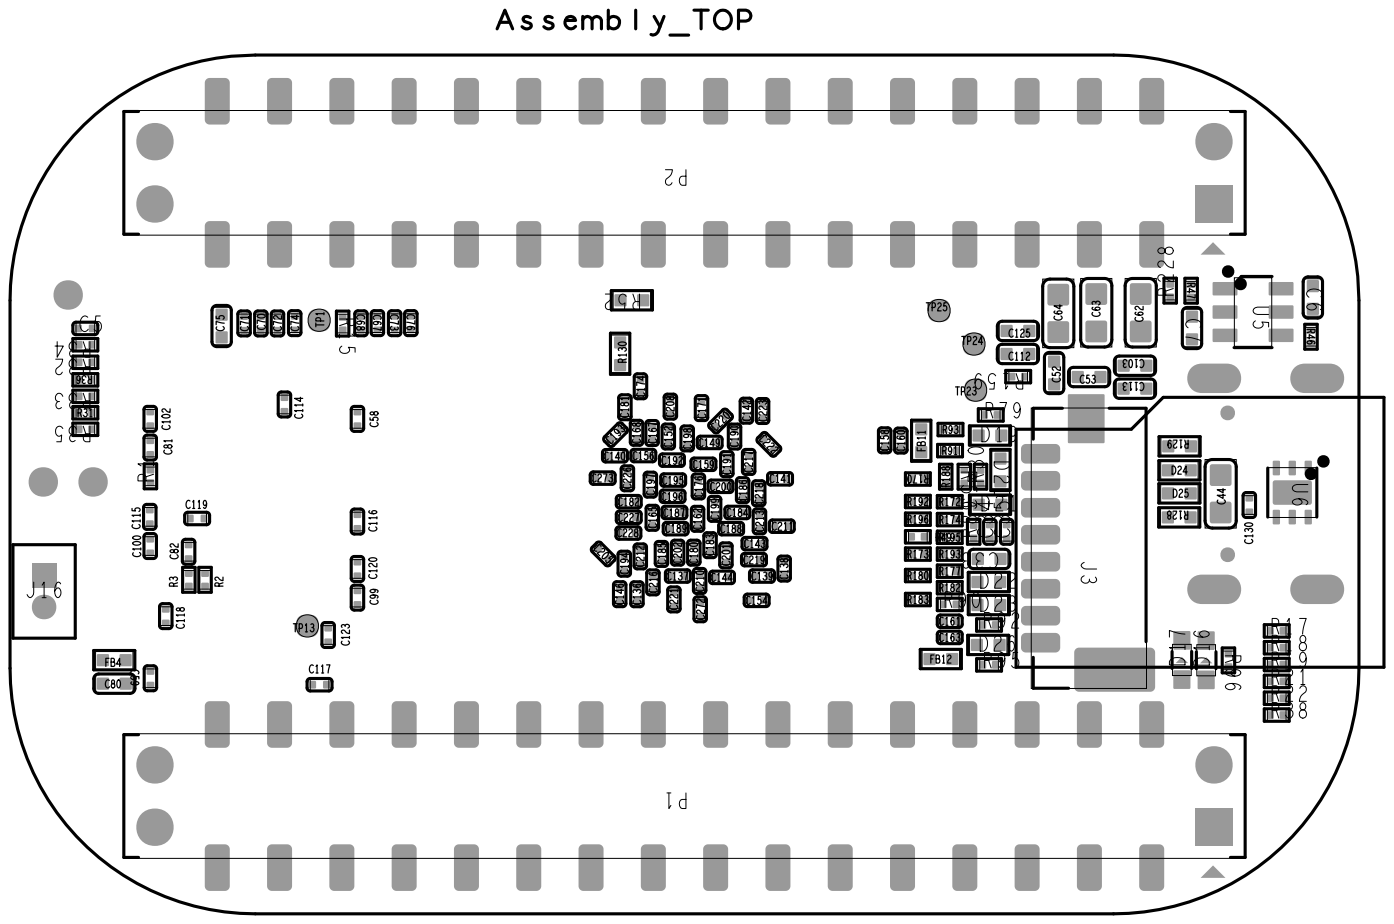
[picture p109: page 1]

Q4

C54 Q5

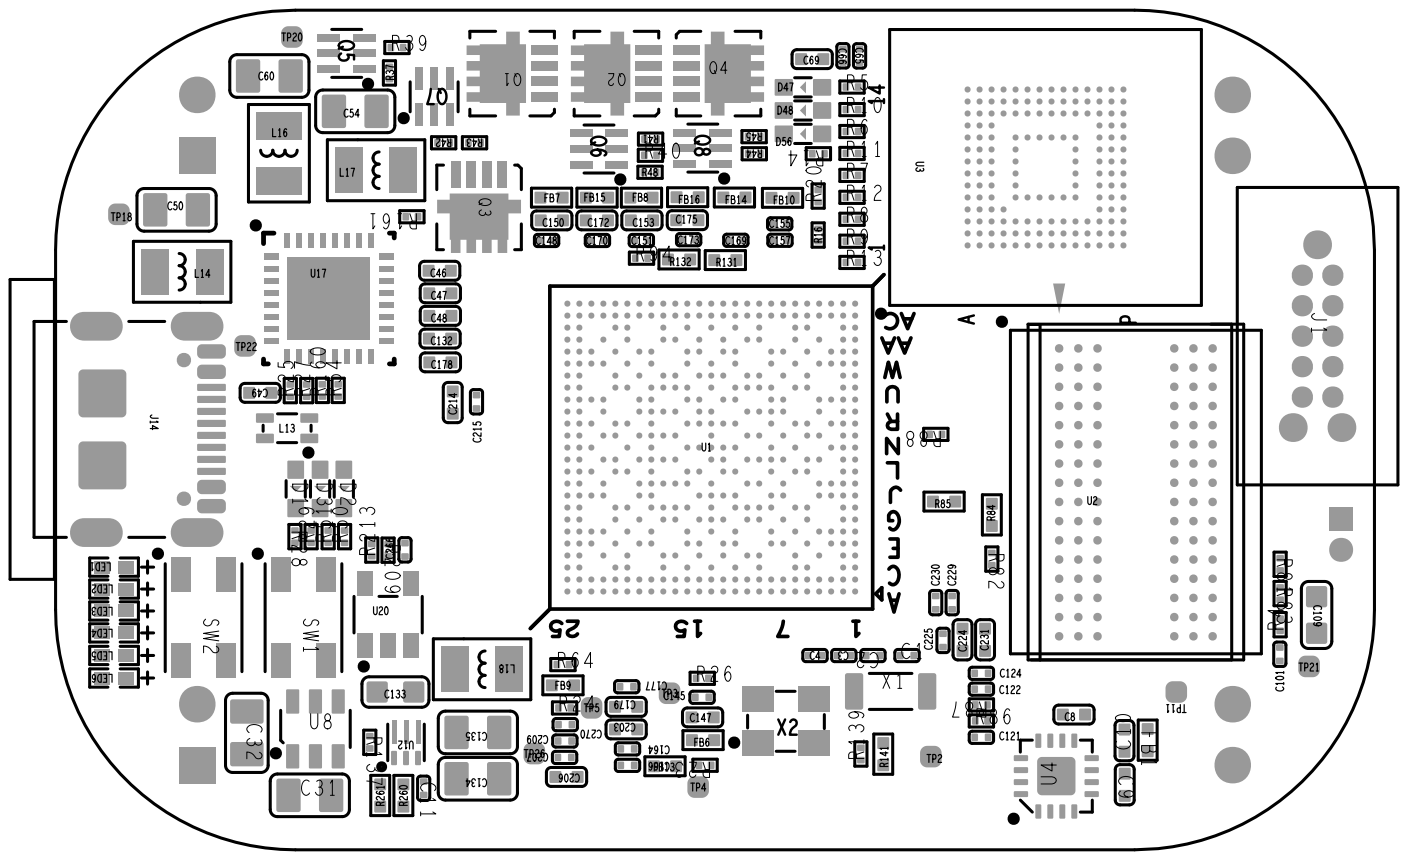
[picture p110: page 2]
