beagleboard/pocketbeagle-2/(list of files, drawings)

Other design files:
design/old/POCKETBEAGLE2 V07.DSN
design/old/POCKETBEAGLE2 V10_241205.DSN
design/POCKETBEAGLE2 V10_241205.DSN
design/POCKETBEAGLE2 V10_241220.DSN
