beagleboard/pocketbeagle-2/(commit log)

2022-11-10 Upload New File
    [PocketBeagle_2_Header_Pins_-_Connections.csv]
2023-02-10 evt: add basic test procedure
    SD and uart console hookup details.
2023-02-10 evt: Add initial test result summary xls
    [EVT1_PB2_rev0.5_Test_Results.xls]
2024-08-13 Add PocketBeagle2 v0.7 design files and move old files
    [POCKETBEAGLE2 V07 ebom.xlsx, POCKETBEAGLE2 V07.DSN, PocketBeagle_2_Header_Pins_-_Connections.csv]
2024-08-15 convert BOM XLSX to CSV
    [POCKETBEAGLE2 V07 ebom.csv, POCKETBEAGLE2 V07 ebom.xlsx]
2024-12-15 Update schematic (21st Nov 2024)
2024-12-16 Update design files
    [POCKETBEAGLE2 V07 ebom.csv, POCKETBEAGLE2 V07.DSN, POCKETBEAGLE2 V10_241205.DSN]
2024-12-25 Update RevA design files
    [POCKETBEAGLE2 V10_241205.DSN, POCKETBEAGLE2 V10_241220.DSN]
2024-12-25 Add RevA board images
2025-01-28 Update board grphics and readme
